ZhangXin555/kosmo-riscv/docs/Kosmo2_RISC-V五级流水CPU详解.docx

本文档怎么用

第 1 章：工程在哪、怎么跑起来。

第 2–10 章：一个模块一章，先贴该模块的全部代码，再按代码书写顺序一步一步讲，配 Vivado 真实截图。

第 11 章：把整机串起来，讲数据怎么在模块之间流动，五级流水怎么形成。

第 12 章：总结、改指令的方法、踩过的坑、附录。

代码块里的行号（如 cpu_add.sv:27）是源文件真实行号，可以直接跳过去对照。

# 目录

按 F9 更新

# 第 1 章 这本书怎么读，工程在哪，怎么跑起来

这一章不讲电路，只讲三件事：工程文件在哪、软件怎么打开、三种跑法怎么点。看完你应该能自己把仿真跑出来、把综合跑出来。

## 1.1 工程在哪

东西 | 路径
RTL 源码（27 个文件） | D:\ZI GUANG\aaaaidearjiyeda\rs0\kosmo_port\rtl\
PDS 工程（紫光，上板用） | D:\ZI GUANG\aaaaidearjiyeda\rs0\kosmo_port\kosmo_riscv\kosmo_riscv.pds
PDS 工具 | D:\ZI GUANG\PDS2025.2\PDS_2025.2-ads\bin\pds_shell.exe
Vivado 工程（看电路图用） | D:\kosmo_vivado\kosmo_rtl\kosmo_rtl.xpr
Vivado 工具 | D:\vivado\2025.2\Vivado\bin\
GitHub 仓库（源码 + 本书 + 约束 + 仿真） | https://github.com/ZhangXin555/kosmo-riscv

ZI 和 GUANG 之间是 10 个空格，整个目录名长度 17 个字符。复制路径时最容易在这里少打空格，一少就"找不到文件"。

用 VSCode 打开 rtl 目录即可（装了 Verilog-HDL 扩展就有语法高亮和跳转）。想看电路图用 Vivado，想上板用 PDS。

## 1.2 先认识五个词

词 | 意思 | 在本工程里
指令 | CPU 执行的一条命令，32 位 | add x5,x6,x7 编成 00 7 3 0 6 5 33
PC | 程序计数器，装"下一条指令的地址" | 复位后是 0x8000_0000
流水线 | 把一条指令拆成几段，几段同时干活 | 本工程 5 段：取指 / 译码 / 执行 / 访存 / 写回
拍 | 一个时钟周期，流水线的计时单位 | 小回归程序跑了 1605 拍
位流 | 综合布线后生成的、能烧进 FPGA 的文件 | 本工程三版都是 3,333,784 字节

## 1.3 五级流水一句话

一条指令进门后要走五个工位，每个工位一拍，走完五拍出结果。第一个工位在取指令的时候，第二个工位正在译码上一条，第三个工位正在算再上一条……所以稳定运行时，每个工位都在干活，平均下来一条指令只花一拍。这就叫五级流水。

本工程五个工位对应五个模块：

级 | 名字 | 干什么 | 源文件
IF | 取指 | 按 PC 从 IROM 取 32 位指令 | cpu_IFU.sv
ID | 译码 | 拆字段、拼立即数、读寄存器、算分支目标 | cpu_IDU.sv、cpu_Control.sv
EX | 执行 | ALU 算结果、判分支、算地址 | cpu_EXU.sv、cpu_ALU.sv、cpu_add.sv
MEM | 访存 | load/store 真正访问存储器 | cpu_LSU.sv
WB | 写回 | 把结果写进寄存器堆 | cpu_WBU.sv、cpu_RegisterFile.sv

工位与工位之间有两道"墙"，墙里是一排触发器，负责把上一级的结果锁住交给下一级：cpu_IFID_EX_Reg.sv 和 cpu_EX_LSWB_Reg.sv。

## 1.4 整机的样子

Vivado 里对综合后的设计按 F4 打开 Schematic，看到的就是整机：四个方块、十一根对外引脚、197 根内部连线。

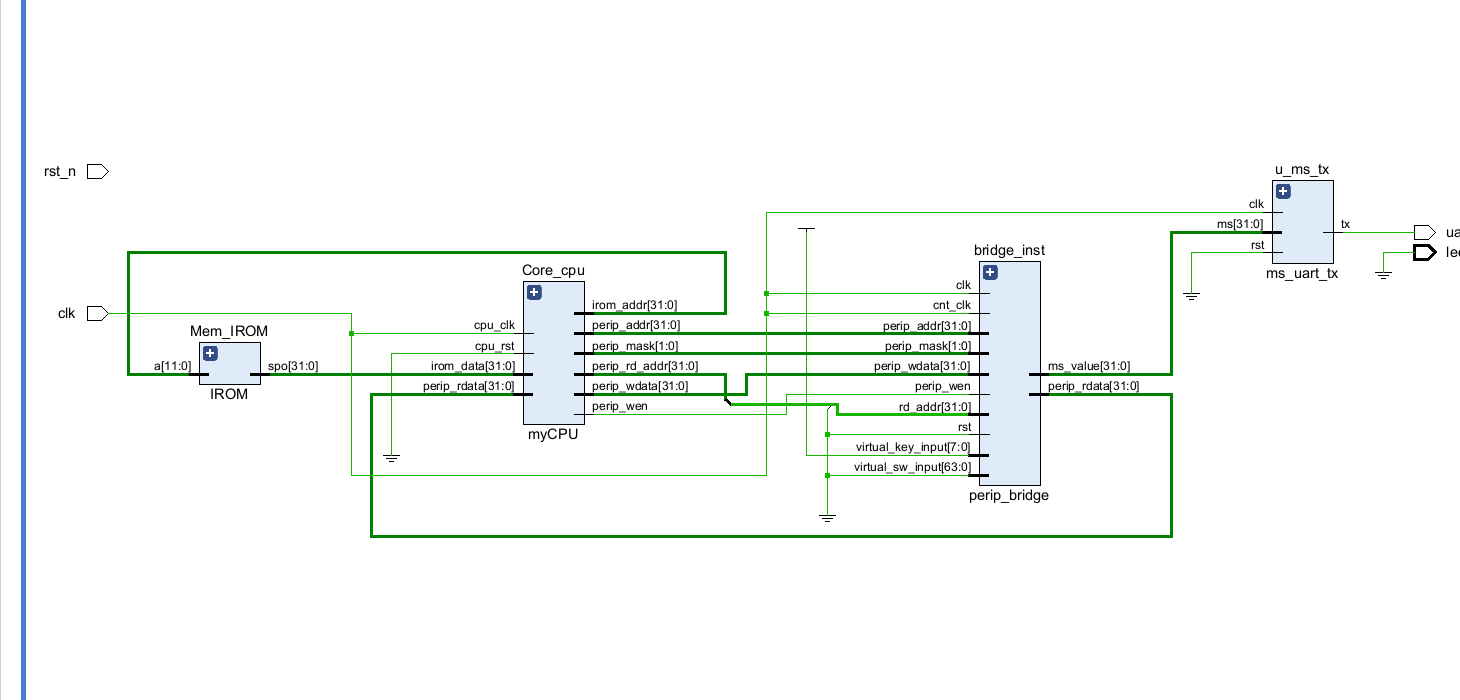
[picture p1: figure]

图 1-1　顶层 top：Mem_IROM 供指令，Core_cpu 是 CPU 本体，bridge_inst 接外设，u_ms_tx 发串口

图里每个方块的左边是输入、右边是输出。Core_cpu 的 irom_addr[11:0] 出去、irom_data[31:0] 回来——这就是取指那条路；perip_addr / perip_wdata / perip_wen 出去、perip_rdata 回来——这就是访问外设那条路。

## 1.5 层次结构

Vivado 左边 Netlist 窗口能看到层次：Core_cpu 下面挂着 10 个模块，其中 EX_LSWB_Reg_inst0 再往下展开是 146 个 RTL_REG_SYNC（就是触发器）。

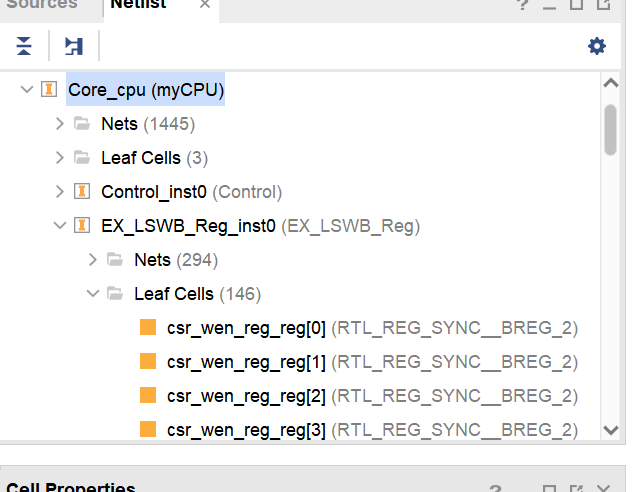
[picture p2: figure]

图 1-2　Netlist 树：Core_cpu → EX_LSWB_Reg_inst0 → 146 个触发器单元

本书第 2 章到第 10 章每章讲一个模块：先贴这个模块的全部代码，再按代码的书写顺序一步步讲，最后收尾。第 11 章把整机串起来讲数据怎么流，第 12 章总结。

## 1.6 三种跑法

跑法一：行为仿真（不烧板，最快）

用 Vivado 或 ModelSim 建工程，把 rtl 全部文件加进去，写一个 testbench 给时钟、给复位，看 pc 和 RegisterFile 里的值。本工程的小回归程序跑 1605 拍，最后寄存器结果是 0x4e84（20100）。

跑法二：综合看电路（不烧板，看面积和连线）

Vivado 里 Run Synthesis，看 Report Utilization：3119 个 LUT、1687 个触发器、64 个 BRAM36。再按 F4 看 Schematic，就是图 1-1。

跑法三：综合布线上板（出位流）

PDS 里打开 kosmo_riscv.pds，先综合再布局布线，最后生成 .sbit。三版位流都是 3,333,784 字节，Fmax 分别是 75.34 / 110.10 / 130.84 MHz。

## 1.7 本书的约定

- 代码块里的行号（如 cpu_add.sv:27）指源文件的真实行号，可直接跳过去看。
- 图都是 Vivado 里的真实截图，不是画出来的示意图。图里方块名、连线名跟代码里的信号名一一对应。
- 每个模块章节最后一节是"三问收尾"：它干什么、怎么做到的、为什么这样写。

## 自测

1. 复位后第一条指令的地址是多少？为什么是这个值？

2. 五级流水稳定运行时，平均一条指令几拍？为什么不是 5 拍？

3. 图 1-1 里 Core_cpu 和 bridge_inst 之间那几根线叫什么名字？它们负责什么？

# 第 2 章 add：一个既能加又能减的加法器

从最底下讲起。整台 CPU 里真正"算数"的东西只有一个 32 位加法器，cpu_add.sv。把它的 31 行代码看懂，后面 ALU 的 11 种运算就有一半能看懂。

## 一、全部代码

`timescale 1ns/1ps

//=============================================================================

// 模块名 ：add（可切换加/减的加法器）

// 位置 ：被 cpu_ALU.sv 调用的组合运算单元（EX 级内部）

// 干什么 ：choose_add_sub=0 时做 add_1 + add_2（加法）；

// choose_add_sub=1 时做 add_1 + (~add_2 + 1) = add_1 - add_2（减法）。

// "加 1"来自 add_2_inv，它是 add_2 的按位取反（在 ALU 里生成），

// 所以这里不再自己取反，省一级逻辑。

// 关键点 ：减法用"补码 = 取反加一"实现；BW 是位宽参数（ALU 里例化成 32）。

//=============================================================================

module add

#(

parameter BW=4 // 位宽参数，默认 4（ALU 里用 32）

)

(

input choose_add_sub, // 0=加法，1=减法

input [BW-1:0]add_1, // 被加数（操作数 A）

input [BW-1:0]add_2, // 加数（操作数 B）

input [BW-1:0]add_2_inv, // ~add_2，减法时用来做补码

output [BW-1:0]result // 运算结果

);

logic [BW-1:0]add_3; // 真正参与相加的第二项

// 选第二操作数：加法直接用 B；减法用 ~B（1 的补数）

assign add_3 = (choose_add_sub == 1'b0)? add_2:(add_2_inv + 1'b1); // 减法时 +1 补齐成 2 的补码

// 核心：A + B 或 A + (~B+1)

assign result = add_1 + add_3;

endmodule

## 二、按代码顺序讲

### 第 1 步 起名字

module add #(

parameter BW=4

)(

input choose_add_sub,

input [BW-1:0] add_1,

input [BW-1:0] add_2,

input [BW-1:0] add_2_inv,

output [BW-1:0] result

);

module add 是这个模块的名字，别处例化它时写 add #(.BW(32)) add_inst0 (...)。

parameter BW=4 是位宽参数，默认 4 位。为什么默认 4 位？因为作者想让它既能做 4 位小加法（测试用），也能在 ALU 里做 32 位加法（BW=32）。不写参数时是 4 位，例化时改一下就是 32 位，代码一行不用重写。

### 第 2 步 四个输入、一个输出

端口 | 位宽 | 它是什么
choose_add_sub | 1 | 0 = 做加法，1 = 做减法
add_1 | BW | 被加数（第一个操作数）
add_2 | BW | 加数（第二个操作数）
add_2_inv | BW | add_2 按位取反，减法时用它做补码
result | BW | 算出来的和或差

四个输入里，add_2 和 add_2_inv 是同一个数的两种形态。为什么不省掉 add_2_inv、让模块自己取反？因为取反是纯组合逻辑，放在外面（ALU 里）可以只做一次、多个地方共用；放进加法器就变成"每次加法都顺手取反一次"，多一级门延迟。这个设计选择会在第 3 章第 4 步再出现一次。

### 第 3 步 先声明一根内部线占个位

logic [BW-1:0] add_3;

add_3 是"真正参与相加的第二项"。为什么需要这一根线？因为第二项有两个来源：加法时它是 add_2，减法时它是 add_2_inv + 1。先把"选哪个"算出来放进 add_3，最后一步就只剩一句干净的 result = add_1 + add_3。

### 第 4 步 选第二项：加还是减

assign add_3 = (choose_add_sub == 1'b0) ? add_2 : (add_2_inv + 1'b1);

这一行是三目运算符，翻译成人话：

- 如果 choose_add_sub 等于 0（做加法），add_3 就等于 add_2；
- 否则（做减法），add_3 就等于 add_2_inv + 1。

为什么减法是"取反加一"？ 计算机里没有减法器，只有加法器。要算 a - b，就把它变成 a + (-b)。而 -b 在补码里等于 ~b + 1（按位取反再加一）。举例：

b = 0000_0011（十进制 3）

~b = 1111_1100

~b+1 = 1111_1101 ← 这就是 -3 的补码

验证：3 + (-3) = 0000_0011 + 1111_1101 = 1_0000_0000，最高位溢出被丢掉，剩下 0000_0000 = 0。对的。

上面这个 +1 是用一个独立的小加法器做的（图 2-1 左边那个 RTL_ADD，一个输入是 d2_inv、另一个是常数 1）。

### 第 5 步 真正相加

assign result = add_1 + add_3;

这一句才是主加法器。前面所有工作都是为了把"该加什么"准备好，到这里只剩一次加法。

+ 在 always 块外面是纯组合逻辑：输入一变，输出立刻跟着变，不需要时钟。综合工具会把它映射成进位链（carry chain），32 位大约占 32 个 LUT。

### 第 6 步 它在图上长什么样

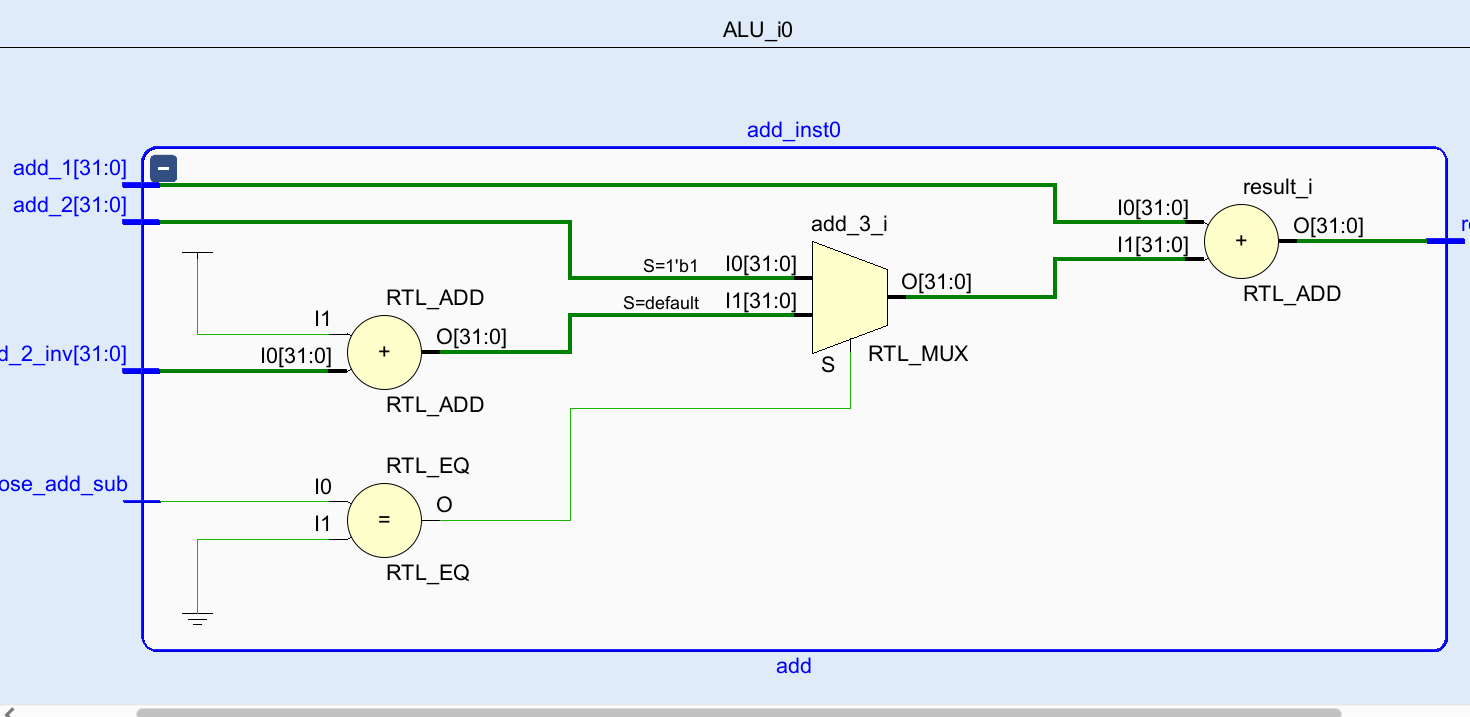
[picture p3: figure]

图 2-1　add_inst0 内部：左边 +1 做补码，中间 MUX 选加还是减，右边 A+B 出结果

图上有四个方块，正好对上代码：

图上的器件 | 对应的代码 | 干什么
左边 RTL_ADD（I0=d_2_inv，I1=1） | :27 的 add_2_inv + 1'b1 | 取反再加一，做出补码
中间 RTL_MUX（S=choose_add_sub） | :27 的三目运算符 ? : | 决定第二项用 add_2 还是补码
右边 RTL_ADD（I0=add_1，I1=add_3） | :30 的 add_1 + add_3 | 真正的加法
下方 RTL_EQ（I0=choose_add_sub，I1=0） | :27 的 choose_add_sub == 1'b0 | 比较器，输出接 MUX 的选择端

这张图最值钱的地方：它证明了"减法不另开加法器"这句话在电路上是什么样——图里只有两个 +，其中一个还是 +1（1 位就够，综合器会把它并进主加法器的进位输入）。

### 第 7 步 改一行，图会怎么变

改动 | 电路上的后果
把 :27 的 add_2_inv + 1'b1 改成 add_2_inv | 左边那个 RTL_ADD 消失，减法结果整体差 1（a-b 变成 a-~b）
把 :27 的三目改成两路 always 分支 | 综合出等价电路，但可能多一级 MUX 延迟
把 BW 改成 64 | 两个加法器都变 64 位，进位链变长，Fmax 下降

## 三、本章小结

问题 | 答案
它干什么 | 算 add_1 + add_3，add_3 是 add_2 或它的补码
怎么做到 | 一个 +1 小加法器做补码 → 一个 MUX 选第二项 → 一个主加法器出结果
为什么这样写 | 减法复用加法器，省一个 32 位加法器的面积
为什么留 add_2_inv 端口 | 取反是纯组合逻辑，放外面只做一次，省延迟
图上怎么认 | 两个 RTL_ADD + 一个 RTL_MUX + 一个 RTL_EQ

## 自测

1. choose_add_sub=0、add_1=5、add_2=3，add_3 和 result 各是多少？

2. choose_add_sub=1、add_1=5、add_2=3，用二进制写出 add_2_inv、add_3、result。

3. 为什么减法的 +1 也要用加法器做，而不是直接写 add_1 - add_2？

# 第 3 章 ALU：11 种运算，一个加法器搞定

这一章只讲一个模块：cpu_ALU.sv 里的 ALU。写法是固定的四段：

1. 先给出全部代码（一字不改，带真实行号）；

2. 按代码书写顺序一步一步讲，每一步先写"这一步在做什么"，再展开细节；

3. 每一步都配一张工程截图，并说清图里哪个器件对应哪一行；

4. 最后收尾三问：这个模块实现了什么功能、为什么这样写就正确、换个写法为什么会错。

读的时候可以对着代码看：左边代码、右边解释、中间看图。

## 一、全部代码

### 1.1 模块本体（cpu_ALU.sv 第 37–112 行）

37: module ALU #(

38: parameter BW = 32 // 数据位宽（本 CPU 用 32）

39: )(

40: input [BW-1:0] d1, // 操作数 A

41: input [BW-1:0] d2, // 操作数 B

42: input [3:0] choice, // 操作码

43: output logic [BW-1:0] result // 运算结果

44: );

45: //-------------------------------------------------------------------------

46: // ① 并行预计算：所有结果同时算，最后选（组合逻辑，无时钟）

47: //-------------------------------------------------------------------------

48: logic [BW-1:0] d2_inv; // d2 的按位取反（减法用）

49: logic [BW-1:0] and_result; // d1 & d2

50: logic [BW-1:0] or_result; // d1 | d2

51: logic [BW-1:0] xor_result; // d1 ^ d2

52: logic [BW-1:0] sll_result; // d1 << d2[4:0]

53: logic [BW-1:0] srl_result; // d1 >> d2[4:0]（高位补 0）

54: logic [BW-1:0] sra_result; // d1 >>> d2[4:0]（高位补符号位）

55: logic [BW-1:0] add_result; // 加法器输出（减法也走它）

56: logic [BW-1:0] sub_result; // 减法结果（= 加法器输出）

57:

58: logic signed_lt; // 有符号小于（1 位）

59: logic unsigned_lt; // 无符号小于（1 位）

60: logic equal; // 不相等（1 位）

61:

62: assign d2_inv = ~d2; // 先取反，减法要用

63:

64: assign and_result = d1 & d2; // 与

65: assign or_result = d1 | d2; // 或

66: assign xor_result = d1 ^ d2; // 异或

67: assign sll_result = d1 << d2[4:0]; // 左移

68: assign srl_result = d1 >> d2[4:0]; // 逻辑右移

69: assign sra_result = $signed(d1) >>> d2[4:0]; // 算术右移

70:

71: // 比较器：$signed 让综合器走有符号比较；结果只有 1 位

72: assign signed_lt = $signed(d1) < $signed(d2); // 有符号小于

73: assign unsigned_lt = d1 < d2; // 无符号小于

74: assign equal = (d1 != d2); // 不相等（注意定义）

75:

76: //-------------------------------------------------------------------------

77: // ② 加减共用一个加法器

78: // choose_add_sub = 0 → d1 + d2

79: // choose_add_sub = 1 → d1 + (~d2 + 1) = d1 - d2（补码）

80: //-------------------------------------------------------------------------

81: add #(

82: .BW(BW)

83: ) add_inst0 (

84: .choose_add_sub(choice == `alu_sub), // 1=减法，0=加法

85: .add_1(d1), // 被加数

86: .add_2(d2), // 加数

87: .add_2_inv(d2_inv), // d2 的取反值（减法时用）

88: .result(add_result) // 和

89: );

90: assign sub_result = add_result; // 减法也走同一个加法器

91:

92: //-------------------------------------------------------------------------

93: // ③ 一层 case 选最终结果（这个 always 是纯组合，always@(*) 不会生成寄存器）

94: //-------------------------------------------------------------------------

95: always @(*) begin

96: case(choice)

97: `alu_signed_comparator : result = {{(BW-1){1'b0}}, signed_lt}; // < 有符号

98: `alu_unsigned_comparator : result = {{(BW-1){1'b0}}, unsigned_lt}; // < 无符号

99: `alu_add : result = add_result; // 加

100: `alu_sub : result = sub_result; // 减

101: `alu_and : result = and_result; // 与

102: `alu_or : result = or_result; // 或

103: `alu_xor : result = xor_result; // 异或

104: `alu_equal : result = {{(BW-1){1'b0}}, equal}; // 不相等

105: `alu_sll : result = sll_result; // <<

106: `alu_srl : result = srl_result; // >>

107: `alu_sra : result = sra_result; // >>>

108: default : result = {BW{1'b0}}; // 未定义 → 0

109: endcase

110: end

111:

112: endmodule

### 1.2 操作码定义（第 23–33 行）

23: `define alu_add 4'b0000 // 加

24: `define alu_sub 4'b0001 // 减

25: `define alu_or 4'b0010 // 或

26: `define alu_and 4'b0011 // 与

27: `define alu_xor 4'b0100 // 异或

28: `define alu_signed_comparator 4'b0101 // 有符号比较（小于）

29: `define alu_unsigned_comparator 4'b0110 // 无符号比较（小于）

30: `define alu_equal 4'b0111 // 相等判断（实际存"不相等"）

31: `define alu_sll 4'b1000 // 逻辑左移

32: `define alu_srl 4'b1001 // 逻辑右移

33: `define alu_sra 4'b1010 // 算术右移

这 11 个 define 是"操作码的名字"。代码里写 ` alu_add ` 就等于写 4'b0000`，只是让人读得懂。

### 1.3 它在整个 CPU 里的位置

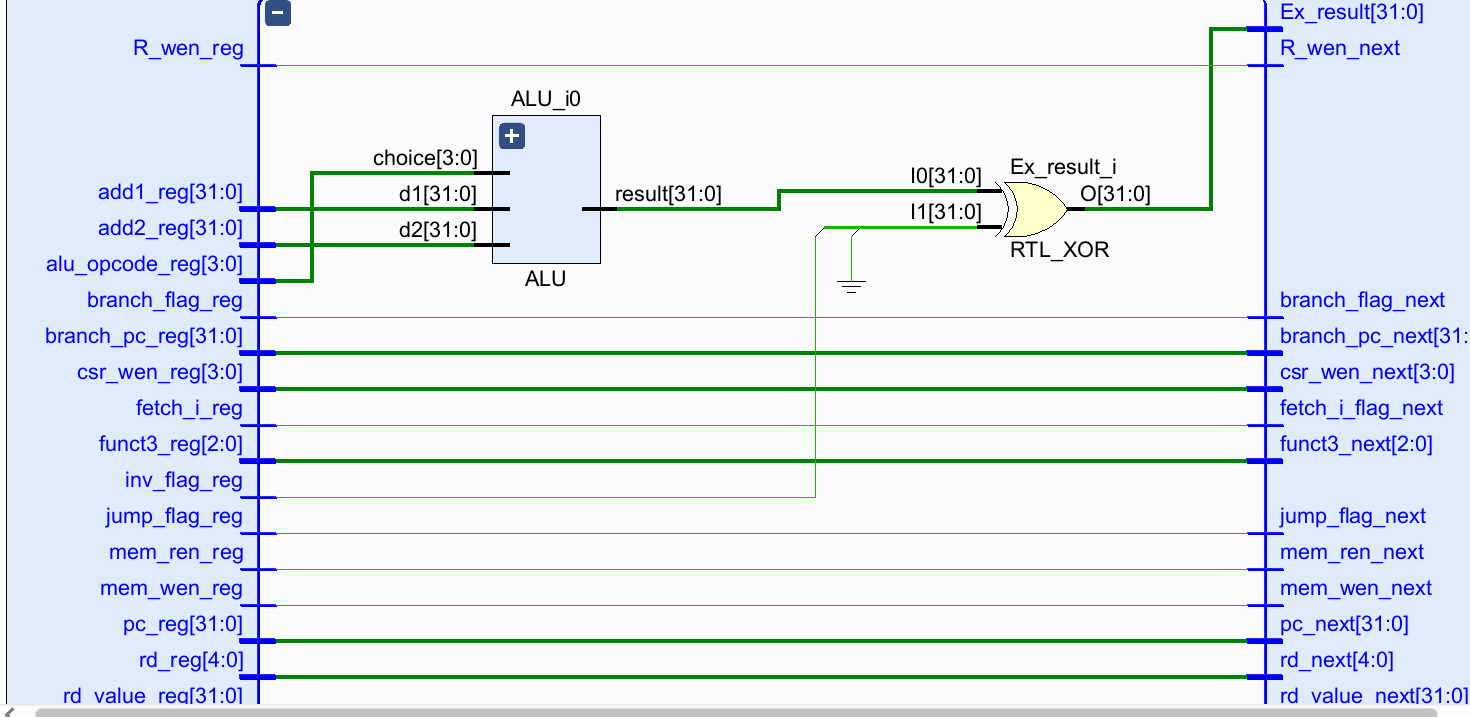
[picture p4: figure]

图 3-3　EXU_inst0 内部：ALU_i0 是 EXU 里唯一干活的方块，右边一个 RTL_XOR 翻 bit0

ALU 不是顶层模块，它被 EXU（cpu_EXU.sv:115-122）例化成一个叫 ALU_i0 的方块。图上那个方块就是本章要拆的东西：

- 左边进去三根总线：d1、d2、choice；
- 右边出来一根：result；
- 再右边那个 RTL_XOR 是 EXU 自己加的，不属于 ALU。

## 二、按代码顺序讲

顺序就是代码的书写顺序，一步不跳：

起名字 → 定端口 → 声明内部线 → 取反 → 六种运算 → 三种比较 → 加法器 → case 选一个 → 收尾

第1步 第2步 第3步 第4步 第5步 第6步 第7步 第8步 第9步

### 第 1 步 module ALU #( parameter BW = 32 ) (

37: module ALU #(

38: parameter BW = 32 // 数据位宽（本 CPU 用 32）

39: )(

这一步在做什么：给电路起名字，并把"位宽"定成一个能改的数。

- module ALU：这块电路的名字叫 ALU。别处写 ALU #(.BW(32)) ALU_i0 (...)，就是把这一整块复制一份放进 EXU 里。
- #( parameter BW = 32 )：参数。这个模块里所有写 `BW` 的地方都等于 32，所有 [BW-1:0] 展开就是 [31:0]，也就是 32 根线并排。
- 为什么用参数而不是直接写 32：add 模块里 BW 默认是 4，ALU 例化它时传了 32，所以同一份 add 代码既能做 4 位加法器，也能做 32 位加法器。

### 第 2 步 4 个端口：3 进 1 出

40: input [BW-1:0] d1, // 操作数 A

41: input [BW-1:0] d2, // 操作数 B

42: input [3:0] choice, // 操作码

43: output logic [BW-1:0] result // 运算结果

44: );

这一步在做什么：画出这个电路与外界的边界——从外面进来什么线，往外面出去什么线。

行 | 端口 | 方向 | 位宽 | 实际是几根线 | 代表什么
40 | d1 | 进 | 32 | d1[31]…d1[0] | 操作数 A（rs1，或立即数运算时的第一个源）
41 | d2 | 进 | 32 | d2[31]…d2[0] | 操作数 B（rs2，或立即数）
42 | choice | 进 | 4 | choice[3]…choice[0] | 操作码，告诉 ALU 做哪种运算
43 | result | 出 | 32 | result[31]…result[0] | 选中的那种运算的结果

为什么只有 `result` 前面多一个 `logic`：因为第 8 步要在 always @(*) 里给 result 赋值（过程赋值），只有 logic / reg 类型才能这么用。d1、d2、choice 只在 assign 右边被读，普通的 input 就够。

到这一步为止，模块里一根线都还没接——只是把 4 个出入口定义好了。

### 第 3 步 先把要用的内部线"占个位"

48: logic [BW-1:0] d2_inv; // d2 的按位取反（减法用）

49: logic [BW-1:0] and_result; // d1 & d2

50: logic [BW-1:0] or_result; // d1 | d2

51: logic [BW-1:0] xor_result; // d1 ^ d2

52: logic [BW-1:0] sll_result; // d1 << d2[4:0]

53: logic [BW-1:0] srl_result; // d1 >> d2[4:0]

54: logic [BW-1:0] sra_result; // d1 >>> d2[4:0]

55: logic [BW-1:0] add_result; // 加法器输出

56: logic [BW-1:0] sub_result; // 减法结果

58: logic signed_lt; // 有符号小于（1 位）

59: logic unsigned_lt; // 无符号小于（1 位）

60: logic equal; // 不相等（1 位）

这一步在做什么：声明 12 根内部线。它们现在什么都没接，只有名字和宽度。

行 | 线名 | 位宽 | 后面会装什么 | 谁用它
48 | d2_inv | 32 | ~d2 | 第 7 步的加法器
49 | and_result | 32 | d1 & d2 | 第 8 步 case 的 0011
50 | or_result | 32 | d1 | d2 | 第 8 步 case 的 0010
51 | xor_result | 32 | d1 ^ d2 | 第 8 步 case 的 0100
52 | sll_result | 32 | d1 << d2[4:0] | 第 8 步 case 的 1000
53 | srl_result | 32 | d1 >> d2[4:0] | 第 8 步 case 的 1001
54 | sra_result | 32 | d1 >>> d2[4:0] | 第 8 步 case 的 1010
55 | add_result | 32 | 加法器输出 | 第 8 步 case 的 0000
56 | sub_result | 32 | 就是 add_result | 第 8 步 case 的 0001
58 | signed_lt | 1 | 有符号比较结果 | 第 8 步 case 的 0101
59 | unsigned_lt | 1 | 无符号比较结果 | 第 8 步 case 的 0110
60 | equal | 1 | "不相等"的结果 | 第 8 步 case 的 0111

为什么 9 根 32 位、3 根 1 位：运算结果都要和 result 一样宽（32 位）；比较只有"是/否"两种，1 位就够，到第 8 步再用 31 个 0 补成 32 位。

### 第 4 步 d2_inv = ~d2（第 62 行）

62: assign d2_inv = ~d2;

这一步在做什么：把 `d2` 每一位取反，接到 `d2_inv` 那 32 根线上。

- assign 是永久连线，不是"执行一次"：右边一变，左边立刻跟着变。
- ~ 是按位取反，不是取负：32 根线每根过一个非门，并排 32 个非门。

d2 = 0x00000003 算一遍：

d2 = 0000_0000_0000_0000_0000_0000_0000_0011

~d2 = 1111_1111_1111_1111_1111_1111_1111_1100 = 0xFFFFFFFC

位 | d2 | 过非门 | d2_inv
bit31…bit2 | 全是 0 | ~0 = 1 | 全是 1
bit1 | 1 | ~1 = 0 | 0
bit0 | 1 | ~1 = 0 | 0

这根线后面给谁用：第 7 步送进 add_inst0 的 .add_2_inv(d2_inv)，减法时靠它拼补码。

不写这一行会怎样：第 7 步的 add_2_inv 端口悬空（0），减法会算成 A + 1。

### 第 5 步 6 行 assign，6 种运算同时算（第 64–69 行）

64: assign and_result = d1 & d2; // 与

65: assign or_result = d1 | d2; // 或

66: assign xor_result = d1 ^ d2; // 异或

67: assign sll_result = d1 << d2[4:0]; // 左移

68: assign srl_result = d1 >> d2[4:0]; // 逻辑右移

69: assign sra_result = $signed(d1) >>> d2[4:0]; // 算术右移

这一步在做什么：6 种运算各配一座电路，同时算，各占一根线。

拿 d1 = 5 = 0101、d2 = 3 = 0011 一位一位看：

行 | 运算 | 门电路 | 算式 | 结果
64 | 按位与 & | 32 个与门，同一位都是 1 才出 1 | 0101 & 0011 | 0001 = 1
65 | 按位或 | | 32 个或门，有一位是 1 就出 1 | 0101 | 0011 | 0111 = 7
66 | 按位异或 ^ | 32 个异或门，两位不同才出 1 | 0101 ^ 0011 | 0110 = 6
67 | 左移 << | 移位器，低位补 0 | 0101 << 3 | 0010_1000 = 40
68 | 逻辑右移 >> | 移位器，高位补 0 | 0101 >> 3 | 0000 = 0
69 | 算术右移 >>> | 移位器，高位补符号位 | 0101 >>> 3 | 0000 = 0

移位量为什么写 `d2[4:0]`：RISC-V 规定移位量只有 5 位（0~31），32 位数据最多移 31 位。写 d2[4:0] 就是只取低 5 根线，其余 27 根不参与。

算术右移和逻辑右移的差别，用负数才看得出来：d1 = 0xFFFFFFF2（-14），d2 = 2

>>> 2 : 1111_1111_1111_1111_1111_1111_1111_1100 = 0xFFFFFFFC = -4 高位补 1

>> 2 : 0011_1111_1111_1111_1111_1111_1111_1100 = 0x3FFFFFFC = 1073741820 高位补 0

同一条数据，`>>>` 补 1、`>>` 补 0——这就是 `sra` 和 `srl` 的全部区别。 $signed(d1) 是告诉编译器"把 d1 当有符号数看"，否则 >>> 会退化成 >>。

这 6 根线后面给谁用：都在第 8 步的 case 里被选中。

### 第 6 步 3 行比较，各出 1 位（第 72–74 行）

72: assign signed_lt = $signed(d1) < $signed(d2); // 有符号小于

73: assign unsigned_lt = d1 < d2; // 无符号小于

74: assign equal = (d1 != d2); // 不相等（注意定义）

这一步在做什么：3 个比较器，每个只输出 1 位（真 = 1，假 = 0）。

有符号和无符号的差别，用负数最明显：d1 = 0xFFFFFFF2（有符号是 -14，无符号是 4294967282），d2 = 2

行 | 怎么比 | 结果 | 为什么
72 | -14 < 2（有符号） | 1 | 负数小于正数
73 | 4294967282 < 2（无符号） | 0 | 42 亿当然不小于 2

同一对数据，两个比较器给出相反结果——这就是 RISC-V 为什么要分 blt（有符号）和 bltu（无符号）。

`equal` 为什么写 `!=`：它算的是"不相等"，5 != 3 得 1。名字叫 equal、值却是"不相等"，这是故意的——EXU 那边（cpu_EXU.sv:108）会把它翻转一次变成"相等"。这里改成 `==`，EXU 再翻一次，等于没翻，所有分支指令全反。

!= 的门电路：32 个异或门（相同位输出 0）+ 一个 32 输入或门（有任何一位不同就输出 1）。

### 第 7 步 把三根线送进加法器（第 81–90 行）

81: add #(

82: .BW(BW)

83: ) add_inst0 (

84: .choose_add_sub(choice == `alu_sub), // 1=减法，0=加法

85: .add_1(d1), // 被加数

86: .add_2(d2), // 加数

87: .add_2_inv(d2_inv), // d2 的取反值（减法时用）

88: .result(add_result) // 和

89: );

90: assign sub_result = add_result; // 减法也走同一个加法器

这一步在做什么：把第 4 步取反好的 `d2_inv` 和第 2 步的 `d1`、`d2` 送进 `add` 模块，一次算出加减。

行 | 语句 | 干什么
81–83 | add #(.BW(BW)) add_inst0 ( | 把 add 模块复制一份，起名 add_inst0，位宽传 32
84 | .choose_add_sub(choice == \alu_sub)` | 算一个 1 位的值：choice 等于 0001 时传 1（做减法），否则传 0（做加法）
85 | .add_1(d1) | A = d1
86 | .add_2(d2) | B = d2
87 | .add_2_inv(d2_inv) | 把取反好的线接进来
88 | .result(add_result) | 加法器输出接到 add_result 这 32 根线
90 | assign sub_result = add_result; | 减法结果就是加法器输出，不再另建电路

图 3-1　add_inst0 内部：左边 +1、中间 MUX、右边 A+B，正对上图第 84–88 行

add 模块内部只有两行（cpu_add.sv:27 和 :30）：

27: assign add_3 = (choose_add_sub == 1'b0)? add_2:(add_2_inv + 1'b1);

30: assign result = add_1 + add_3;

所以：

- choice = 0000（加）→ choose_add_sub = 0 → add_3 = d2 → add_result = d1 + d2
- choice = 0001（减）→ choose_add_sub = 1 → add_3 = ~d2 + 1 → add_result = d1 + ~d2 + 1 = d1 - d2

拿 5 和 3 算：

加：0101 + 0011 = 1000 = 8 ✓

减：0101 + (1100 + 1 = 1101) = 1_0010 → 丢掉最高进位 = 0010 = 2 ✓

为什么"取反加一"等于减法：~B + 1 = 2³² − B，所以 A + (~B + 1) = 2³² + (A − B)，32 位加法器只保留低 32 位，那个 2³² 正好溢出丢掉，剩下 A − B。

### 第 8 步 case：如果 choice 等于几，就把哪根线接到输出（第 95–110 行）

95: always @(*) begin

96: case(choice)

97: `alu_signed_comparator : result = {{(BW-1){1'b0}}, signed_lt};

98: `alu_unsigned_comparator : result = {{(BW-1){1'b0}}, unsigned_lt};

99: `alu_add : result = add_result;

100: `alu_sub : result = sub_result;

101: `alu_and : result = and_result;

102: `alu_or : result = or_result;

103: `alu_xor : result = xor_result;

104: `alu_equal : result = {{(BW-1){1'b0}}, equal};

105: `alu_sll : result = sll_result;

106: `alu_srl : result = srl_result;

107: `alu_sra : result = sra_result;

108: default : result = {BW{1'b0}};

109: endcase

110: end

这一步在做什么：12 路里挑 1 路接到 `result`——就是一个 12 选 1 的 MUX。

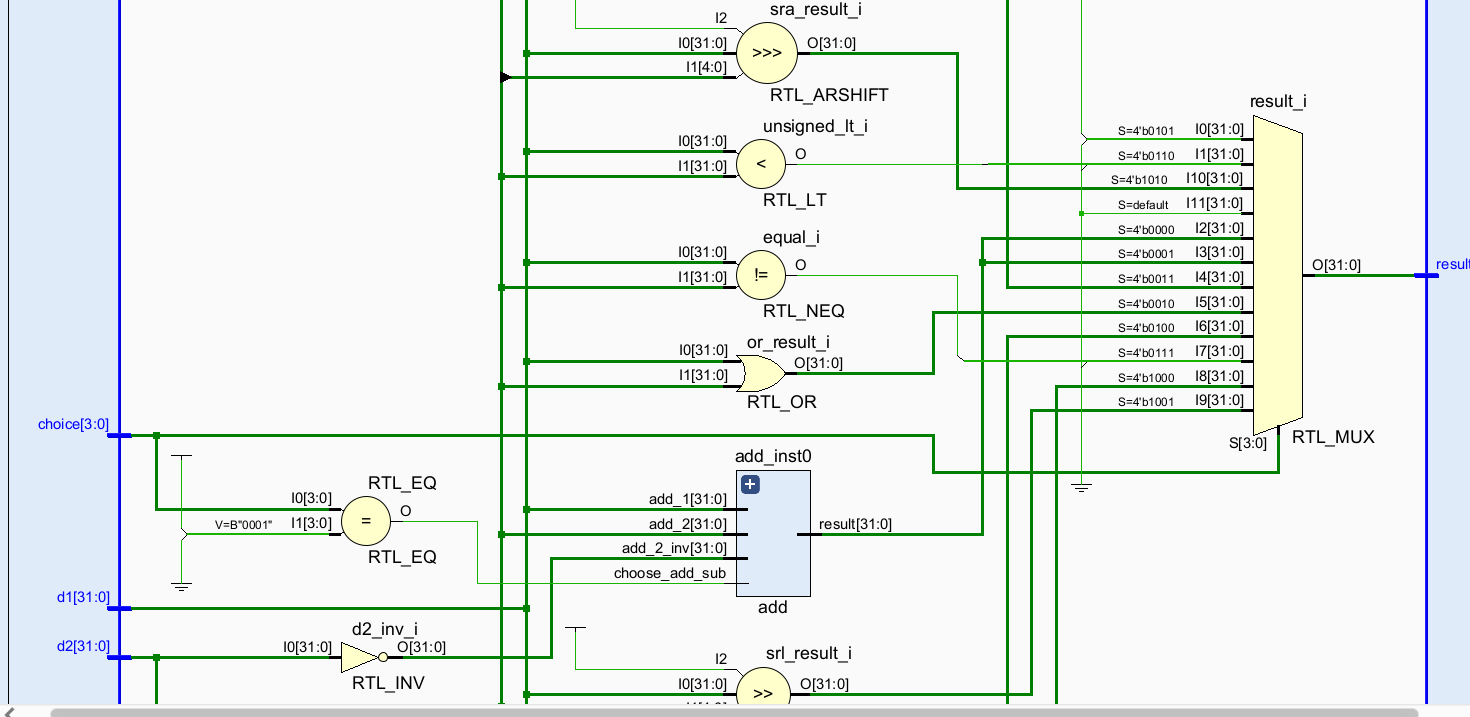
[picture p5: figure]

图 3-2　ALU_i0 内部：左边一排运算单元并行，右边 RTL_MUX（S = choice[3:0]）按 case 选

看图对照代码：图左边那一排 `RTL_AND` / `RTL_OR` / `RTL_XOR` / `RTL_LSHIFT` / `RTL_RSHIFT` / `RTL_ARSHIFT` / `RTL_LT`×2 / `RTL_EQ` / `RTL_INV` / `add_inst0`，就是第 4～7 步那 10 行 `assign` + 1 个例化；图右边那个 `RTL_MUX`，就是第 8 步这个 `case`。

每一行翻译成人话就是"如果 `choice` 等于这个值，就把等号右边那根线接到 `result` 上"：

常量 | 值 | 这一行 | 人话
alu_add | 0000 | result = add_result; | 要加，就把加法器输出接出去
alu_sub | 0001 | result = sub_result; | 要减，接减法输出（同一根线）
alu_or | 0010 | result = or_result; | 接或
alu_and | 0011 | result = and_result; | 接与
alu_xor | 0100 | result = xor_result; | 接异或
alu_signed_comparator | 0101 | result = {31'd0, signed_lt}; | 接有符号比较，补 31 个 0
alu_unsigned_comparator | 0110 | result = {31'd0, unsigned_lt}; | 接无符号比较
alu_equal | 0111 | result = {31'd0, equal}; | 接"不相等"
alu_sll | 1000 | result = sll_result; | 接左移
alu_srl | 1001 | result = srl_result; | 接逻辑右移
alu_sra | 1010 | result = sra_result; | 接算术右移
其他 | 1011~1111 | result = 32'd0; | 默认全 0

`{{(BW-1){1'b0}}, signed_lt}` 是什么意思：把 1 位的 signed_lt 放在最低位，前面补 31 个 0，凑成 32 位。{(BW-1){1'b0}} 就是"31 个 0"的写法。

`always @(*)` 为什么不能写 `posedge clk`：这是组合逻辑，choice 一变就该立刻出结果。加了时钟就变成"下一拍才出"，整个 CPU 多一拍延迟。

`default` 为什么必须有：choice 是 4 位，有 16 种可能，代码只写了 11 种。不写 default，剩下 5 种情况下 result 没赋值，综合器会推断"要记住上次的值"，生成锁存器（latch）——电路不对，仿真和时序都对不上。

### 第 9 步 收尾：这 8 步合起来实现了什么

合起来干的事：

1. 拿到 32 位的 A、32 位的 B、4 位的操作码；

2. 用 32 个非门做出 ~B；

3. 同时算出与、或、异或、三种移位、两种比较、一种"不相等"，9 个结果各挂一根线；

4. 把 A、B、~B 送进一个加法器，加法和减法靠"选 B 还是 ~B+1"共用一座电路；

5. 最后用 12 选 1 的 MUX，按操作码把对应那根线接到输出。

功能一句话：给一个操作码，就输出对应的那一种运算结果。 RISC-V 的 R 型指令（add/sub/and/or/xor/sll/srl/sra）和 I 型指令（addi/andi/ori/xori/slli/srli/srai）在 EX 级做的是同一件事，只是操作码不同，走的是同一个 ALU。

为什么这样就对：

- 加/减：全加器按真值表串联，取反加一等于取负（~B+1 = 2³²−B，溢出位丢掉）。
- 与/或/异或：RISC-V 定义就是按位运算，& / | / ^ 正好一位对一位。
- 移位：shamt 只有 5 位，正好对应 d2[4:0]。
- 比较：< 综合成减法看符号/进位；!= 是 32 个异或再或起来。
- MUX：choice 4 根线能区分 16 种，用 11 种够用。

换个写法为什么会错：

换个写法 | 会怎样 | 为什么
删掉 :108 的 default | 综合出锁存器 | 16 种取值只写了 11 种，剩下 5 种没赋值，综合器只能"记住上次"
:74 改成 equal = (d1 == d2) | 分支指令全反 | EXU 的 inv_flag 还要再翻一次，两次取反等于没翻
用 if/else if 链代替 case | 功能对，Fmax 下降 | 综合成级联 MUX，信号要穿 11 级选择
加减各做一个加法器 | 功能对，面积翻倍 | 多一个 32 位加法器
移位量写 d2 | 仿真结果一样 | Verilog 自动取低 5 位，但读代码的人会误以为能移 32 位以上

## 三、本章小结

你要记住的 | 内容
这个模块干什么 | 给 4 位操作码，输出 11 种运算里对应的那一种
它怎么做到 | 所有运算并行算，最后一层 MUX 选
加减为什么只有一个加法器 | ~B+1 就是 -B，靠 MUX 选第二操作数
为什么 equal 是"不相等" | EXU 会翻转 bit0，两次取反会抵消
图上怎么认 | 左边一排运算单元 = 第 4～6 步；中间 add_inst0 = 第 7 步；右边 RTL_MUX = 第 8 步

# 第 4 章 EXU：ALU 外面只套了一个异或门

第 3 章把 ALU 讲完了。ALU 是 EXU 里面的一个方块。这一章讲 cpu_EXU.sv：EXU 自己干了什么，为什么它能只用一个异或门就把 ALU 包起来。

## 一、全部代码

`timescale 1ns/1ps

//=============================================================================

// 模块名 ：EXU（Execute Unit，执行单元）

// 流水级 ：第 3 级 —— EX（真正算数的那一级）

// 干什么 ：1) 把 ID 送来的操作数 A/B 丢进 ALU 算（加减/逻辑/移位/比较）

// 2) 把控制信号原样"透传"给 EX→MEM 流水寄存器

// 3) 用 inv_flag 对"比较结果"做一次取反，实现 beq/bge/bgeu

// 关键点 ：

// * EXU 本身没有状态（纯组合逻辑），流水寄存器在 EX_LSWB_Reg 里；

// * `Ex_result = alu_result ^ {31'd0, inv_flag_reg}` 这行是"取反技巧"：

// ALU 只会算"小于"和"不相等"，分支指令需要"大于等于""相等"，

// beq/bge/bgeu 在 ID 级把 inv_flag 置 1，这里只翻转最低位就完成等价判断，

// 省掉一条"再比较一次"的路径，关键路径更短、频率更高；

// * 访存地址、寄存器写回值都从 Ex_result 走：lw/sw 的地址 = rs1+imm，

// alu 结果 = 写回值。

//=============================================================================

/*interface define*/

// __opcode__

`define R_opcode 7'b0110011 // R 型

`define lw 7'b0000011 // load

`define addi 7'b0010011 // 立即数算术

`define jarl 7'b1100111 // jalr

`define S_opcode 7'b0100011 // store

`define B_opcode 7'b1100011 // 条件分支

`define lui 7'b0110111 // lui

`define auipc 7'b0010111 // auipc

`define jal 7'b1101111 // jal

`define M_opcode 7'b1110011 // 系统指令

// ---- ALU 操作码 ----

`define alu_add 4'b0000

`define alu_sub 4'b0001

`define alu_or 4'b0010

`define alu_and 4'b0011

`define alu_xor 4'b0100

`define alu_signed_comparator 4'b0101

`define alu_unsigned_comparator 4'b0110

`define alu_equal 4'b0111

`define alu_sll 4'b1000

`define alu_srl 4'b1001

`define alu_sra 4'b1010

`define Performance_Count

module EXU (

// ---- 来自 IFID_EX_Reg（ID 打过来的）----

input [2:0] funct3_reg, // 功能码

input [3:0] csr_wen_reg, // CSR 写使能

input R_wen_reg, // 写通用寄存器

input mem_wen_reg, // 写内存

input mem_ren_reg, // 读内存

input [4:0] rd_reg, // 目的寄存器

input [31:0] pc_reg, // 本条 PC

input [3:0] alu_opcode_reg, // ALU 操作码

input inv_flag_reg, // 比较结果取反

input jump_flag_reg, // 跳转

input branch_flag_reg, // 分支

input fetch_i_reg, // fence.i

input [31:0] branch_pc_reg, // 分支目标

input [31:0] rs2_value_reg, // rs2 原值（store 数据）

input [31:0] add1_reg, // ALU A

input [31:0] add2_reg, // ALU B

input [31:0] rd_value_reg, // 预计算写回值

// ---- 送给 EX_LSWB_Reg（往下打一拍）----

output [2:0] funct3_next,

output [3:0] csr_wen_next,

output R_wen_next,

output mem_wen_next,

output mem_ren_next,

output [4:0] rd_next,

output [31:0] pc_next,

output jump_flag_next,

output [31:0] rs2_value_next,

output [31:0] rd_value_next,

output [31:0] Ex_result, // ALU 结果（下面两级都要用）

output fetch_i_flag_next,

output branch_flag_next,

output [31:0] branch_pc_next

);

logic [31:0] alu_result; // ALU 原始输出

//-------------------------------------------------------------------------

// 控制信号透传：EX 级不改这些信号，只是原样交给下一级寄存器

//-------------------------------------------------------------------------

assign funct3_next = funct3_reg; // 功能码

assign csr_wen_next = csr_wen_reg; // CSR 写使能

assign R_wen_next = R_wen_reg; // 写寄存器

assign mem_wen_next = mem_wen_reg; // 写内存

assign mem_ren_next = mem_ren_reg; // 读内存

assign rd_next = rd_reg; // 目的寄存器

assign pc_next = pc_reg; // PC

assign jump_flag_next = jump_flag_reg; // 跳转标志

assign rs2_value_next = rs2_value_reg; // store 数据（原样带下去）

assign rd_value_next = rd_value_reg; // 写回值（原样带下去）

assign fetch_i_flag_next = fetch_i_reg; // fence.i

assign branch_flag_next = branch_flag_reg; // 分支标志

assign branch_pc_next = branch_pc_reg; // 分支目标

//-------------------------------------------------------------------------

// ALU 结果 + 取反技巧

// inv_flag_reg = 1 时，只翻转 bit0：

// ALU 算 "不相等"(1) → 翻转成 0 → bne 不成立；beq 成立…

// 注意 ALU 里 equal 的定义是 (d1 != d2)，配合 inv_flag 正好实现两类分支。

//-------------------------------------------------------------------------

assign Ex_result = alu_result ^ {31'd0, inv_flag_reg};

//-------------------------------------------------------------------------

// 例化 ALU（组合逻辑，参数化位宽 BW）

// 输入：d1=A, d2=B, choice=操作码；输出：result

//-------------------------------------------------------------------------

/* verilator lint_off PINMISSING */

ALU #(

.BW(32) // 32 位数据通路

) ALU_i0 (

.d1(add1_reg), // 操作数 A

.d2(add2_reg), // 操作数 B

.choice(alu_opcode_reg), // 操作码

.result(alu_result) // 结果

);

endmodule

## 二、按代码顺序讲

### 第 1 步 它在流水线上的位置

EXU = EXecute Unit，第三级。它的上游是流水寄存器 IFID_EX_Reg（把 ID 级算好的东西锁住），下游是 EX_LSWB_Reg。

图 4-1　EXU_inst0 内部：中间 ALU_i0 是算数单元，右边 RTL_XOR 只翻 bit0，四周全是直通的 _reg → _next

图里最明显的特征：一大排 `_reg` 进、`_next` 出，竖着穿过去。这些是"EXU 不碰、但要往下传"的信号：目的寄存器号、写使能、访存标志、PC……EXU 只负责算，别的原样往下递。

### 第 2 步 端口：两组，一组算、一组过

EXU 的端口可以分成三列看：

类别 | 信号 | 说明
要算的 | add1_reg、add2_reg、alu_opcode_reg | 两个操作数 + 操作码，喂给 ALU
算出来的 | Ex_result | ALU 结果，可能被异或门翻 bit0
直通的 | R_wen_reg、rd_reg、mem_ren_reg、mem_wen_reg、csr_wen_reg、pc_reg、funct3_reg、rs2_value_reg、rd_value_reg、jump_flag_reg、valid_last、ready_last | 一位不改，直接 _next

这就是 EXU 的全部工作：算一个值，其余原样传。

### 第 3 步 15 条直通线

assign rd_next = rd_reg;

assign R_wen_next = R_wen_reg;

assign mem_ren_next = mem_ren_reg;

assign mem_wen_next = mem_wen_reg;

assign csr_wen_next = csr_wen_reg;

assign pc_next = pc_reg;

assign funct3_next = funct3_reg;

assign rs2_value_next = rs2_value_reg;

assign rd_value_next = rd_value_reg;

assign jump_flag_next = jump_flag_reg;

每一句都是"左边 = 右边"，中间什么都没做。这在电路上就是一根线（图 4-1 里那些竖着穿过去的细线）。

为什么要这样写而不是省略？因为流水寄存器 EX_LSWB_Reg 需要这些信号，而它们必须由 EXU 交给它；EXU 是两级之间的"传菜口"。

### 第 4 步 算数：只例化一个 ALU

ALU #(.BW(32)) ALU_i0 (

.d1 (add1_reg),

.d2 (add2_reg),

.choice (alu_opcode_reg),

.result (alu_result)

);

#(.BW(32)) 把 ALU 的位宽参数设成 32；ALU_i0 是例化名，Vivado 图里那个方块的标签就是它。

### 第 5 步 那一个异或门：翻 bit0

assign Ex_result = alu_result ^ {31'd0, inv_flag_reg};

inv_flag_reg 是 1 位，{31'd0, inv_flag_reg} 把它补成 32 位（高 31 位是 0，最低位是它）。异或的性质：

- x ^ 0 = x（不翻）——inv_flag_reg=0
- x ^ 1 = ~x[0]（只翻最低位）——inv_flag_reg=1

所以这一句的意思是：`inv_flag_reg` 为 0 时结果不变，为 1 时把结果的最低位取反。

### 第 6 步 为什么要翻最低位

分支指令的比较结果就放在 bit0 里。cpu_ALU.sv 里 equal = (d1 != d2) 算的是"不相等"：相等时 equal=0，不相等时 equal=1。

而 RISC-V 的 beq 要求"相等就跳"。所以 beq 需要把"不相等"翻成"相等"：inv_flag=1 时把 bit0 翻过来，equal=0 变 1，branch_taken = branch_flag & Ex_result[0] 就成立了。

这就是 IDU 里那行 inv_flag 的由来：

assign inv_flag = (opcode == `B_opcode && (funct3 == 3'b101 || funct3 == 3'b111 || funct3 == 3'b000)) ? 1'b1 : 1'b0;

funct3 为 000（beq）、101（bge）、111（bgeu）时置 1——这三条都是"要取反才等价"的分支：

指令 | ALU 算出来的 bit0 | 翻不翻 | 最终跳不跳
beq | equal（不等=1） | 翻 | 相等才跳
bne | equal | 不翻 | 不等于才跳
blt | signed_lt（小于=1） | 不翻 | 小于就跳
bge | signed_lt | 翻 | 不小于（≥）就跳
bltu | unsigned_lt | 不翻 | 无符号小于就跳
bgeu | unsigned_lt | 翻 | 无符号不小于就跳

一个异或门 + 一个 inv_flag 位，搞定 6 条分支的方向。这是全工程最省的一处设计。

### 第 7 步 谁用它

branch_taken 在 cpu_Control.sv 里：

assign branch_taken = branch_flag & Ex_result[0];

branch_flag 说明"这是一条分支"，Ex_result[0] 说明"比较结果是真"。两个都为真才改 PC。

### 第 8 步 改这行，电路会怎么变

改动 | 后果
把 ^ 改成 + | 变成加法，bit0 进位会串到高位，全错
把 {31'd0, inv_flag_reg} 改成 inv_flag_reg | 位宽不匹配，只有 bit0 参与异或，其余位被截断
删掉异或门，让 ALU 直接输出 == | 要么多一种 ALU 运算（面积 + MUX 深度），要么改分支逻辑，二选一

## 三、本章小结

问题 | 答案
它干什么 | 调 ALU 算结果，把其他信号原样送到下一级
怎么做到 | 15 条 assign 直通 + 1 个 ALU_i0 + 1 个异或门
为什么用一个异或门 | 6 条分支里有 3 条需要"取反"，翻 bit0 最省
图上怎么认 | 中间 ALU_i0，右下 RTL_XOR，其余是竖着穿的线
谁接它的结果 | cpu_Control.sv 的 branch_taken，和 EX_LSWB_Reg

## 自测

1. d1=5、d2=5、choice=4'b0111（equal），inv_flag_reg=1，Ex_result[0] 是多少？分支跳不跳？

2. 为什么 blt 不需要翻，而 bge 需要翻？

3. 图 4-1 里那些竖着穿过去的线，它们在代码里对应哪些 assign？

# 第 5 章 IDU：把 32 位机器码拆成五路信号

IDU = Instruction Decode Unit，第二级。它拿到 32 位指令，输出"这一条指令要干什么"的一整套信号：ALU 干什么、要不要访存、要不要写寄存器、要不要跳、跳去哪。

这一章要讲四个文件：cpu_IDU.sv（主译码器）、cpu_RegisterFile.sv（寄存器堆）、cpu_Control.sv（两级总调度）、cpu_Data_hazard.sv（冒险检测）。

## 一、全部代码

### 1.1 IDU 主体

`timescale 1ns/1ps

//=============================================================================

// 模块名 ：IDU（Instruction Decode Unit，译码单元）

// 流水级 ：第 2 级 —— ID（译码 + 读寄存器 + 算分支目标）

// 干什么 ：拿到 IF 送来的 32 位指令，做四件事：

// 1) 拆字段：opcode[6:0] / rs1[19:15] / rs2[24:20] / funct3[14:12] / rd[11:7]

// 2) 拼立即数：I/U/S/B/J 五种格式，按 opcode 选一个

// 3) 生成控制信号：写回使能 R_wen、访存 mem_wen/mem_ren、分支 branch_flag、

// 跳转 jump_flag、ALU 操作码 alu_opcode、CSR 写使能 csr_wen_next

// 4) 读通用寄存器（例化 Reg_Stack），顺便算出分支目标 pc+imm、跳转返回地址 snpc

// 关键点 ：

// * 本模块全是组合逻辑（assign），只有末尾的 Reg_Stack 里有触发器；

// * ALU 的两个操作数 add1_value/add2_value 在这里就选好，EX 级只管算；

// * `imm` 与 `csr_wen_next` 互相引用（csr_wen_next 用 imm，imm 又由 opcode 选），

// Verilog 的 assign 是并行求值，先后顺序无所谓；

// * 例外：csr_wen_next 判断时 imm 还没“定义完”，但组合逻辑会自动收敛。

//=============================================================================

/*interface define*/

// ---- RISC-V opcode（inst[6:0]）----

`define R_opcode 7'b0110011 // R 型：add/sub/sll/slt/sltu/xor/srl/sra/or/and

`define lw 7'b0000011 // I 型 load：lw

`define addi 7'b0010011 // I 型算术：addi 及各变体

`define jarl 7'b1100111 // I 型 jalr（原文拼写 jarl）

`define S_opcode 7'b0100011 // S 型 store

`define B_opcode 7'b1100011 // B 型 条件分支

`define lui 7'b0110111 // U 型 lui

`define auipc 7'b0010111 // U 型 auipc

`define jal 7'b1101111 // J 型 jal

`define M_opcode 7'b1110011 // 系统指令：ecall/mret/csr 读写

// ---- ALU 操作码（与 cpu_ALU.sv 的 case 一一对应）----

`define alu_add 4'b0000 // 加（也用于地址计算/访存地址）

`define alu_sub 4'b0001 // 减

`define alu_or 4'b0010 // 或

`define alu_and 4'b0011 // 与

`define alu_xor 4'b0100 // 异或

`define alu_signed_comparator 4'b0101 // 有符号小于（slt / blt / bge）

`define alu_unsigned_comparator 4'b0110 // 无符号小于（sltu / bltu / bgeu）

`define alu_equal 4'b0111 // 相等（beq / bne）

`define alu_sll 4'b1000 // 逻辑左移

`define alu_srl 4'b1001 // 逻辑右移

`define alu_sra 4'b1010 // 算术右移

`define Performance_Count // 性能统计开关

//=============================================================================

// 端口分组说明（读代码时先看这一块，再看下面的 assign）

// 【指令入口】inst[31:0] 当前指令；snpc = pc+4；pc 当前地址

// 【寄存器堆】rd_value = 上一条写回的值；rd/R_wen 写回端口；csrd/csr_wen CSR 读口

// 【EXU 前递】EXU_rs1_in / EXU_rs2_in —— 经过冒险单元选择后的真实操作数

// （可能是寄存器值，也可能是 EX/MEM 前递过来的新值）

// 【给 ID→EX 流水寄存器】rd_next/funct3/alu_opcode/add1_value/add2_value/

// branch_pc/mem_wen/mem_ren/inv_flag/branch_flag/jump_flag/

// R_wen_next/csr_wen_next/rd_value_next/pc_out

// 【给控制/异常】ecall_flag/mret_flag/fence_i_flag/exc_cause

// 【给冒险单元】rs1/rs2（源寄存器号）、A0 值 a0_value（调试用）

// 【握手】valid_last/ready_last、valid_next/ready_next（本设计恒通）

//=============================================================================

module IDU(

input clock, // 时钟

input reset, // 复位

input [31:0] inst, // 当前指令

input [31:0] snpc, // pc + 4（jal/jalr 的返回地址）

input [31:0] pc, // 当前指令地址

input [31:0] rd_value, // 写回值（来自 WB 级）

input [31:0] csrd, // CSR 读出的值

input [4:0] rd, // 写回目标寄存器号

input R_wen, // 写回使能（来自后续级）

input [3:0] csr_wen, // CSR 写使能（来自后续级）

input [31:0] EXU_rs1_in, // 实际 rs1 操作数（含前递）

input [31:0] EXU_rs2_in, // 实际 rs2 操作数（含前递）

output [4:0] rd_next, // 本指令的 rd（送下一级）

output [2:0] funct3, // funct3 字段（ALU 细分用）

output mret_flag, // 是 mret 指令

output ecall_flag, // 是 ecall 指令

input [1:0] exc_cause, // 异常原因（来自 Control）

output fence_i_flag, // 是 fence.i 指令（清流水，本设计只做气泡）

output [31:0] branch_pc, // 分支目标地址 = pc + imm

output [31:0] rs1_value, // rs1 寄存器值（Reg_Stack 输出）

output [31:0] rs2_value, // rs2 寄存器值

output [31:0] add1_value, // ALU 操作数 A（已选好）

output [31:0] add2_value, // ALU 操作数 B（已选好）

output [3:0] csr_wen_next, // CSR 写使能（4bit：mepc/mcause/mstatus/mtvec）

output R_wen_next, // 本指令是否写通用寄存器

output [31:0] rd_value_next, // 预先算好的写回值（jal/jalr 的返回地址等）

output mem_wen, // 写存储器（store）

output mem_ren, // 读存储器（load）

output inv_flag, // 分支需要取反（beq/bge/bgeu → 用 bne/blt/bltu 判）

output branch_flag, // 是条件分支

output jump_flag, // 是跳转（jal/jalr）

output [3:0] alu_opcode, // ALU 操作码

output [4:0] rs1, // 源寄存器 1 号

output [4:0] rs2, // 源寄存器 2 号

output [31:0] a0_value, // a0(x10) 的值（调试/打印用）

output [31:0] mepc_out, // mepc 寄存器值（异常返回地址）

output [31:0] mtvec_out, // mtvec 寄存器值（异常入口）

output [31:0] pc_out, // 本级 PC（保存进流水寄存器）

input valid_last, // 上一级有效

output ready_last, // 告诉上一级我准备好了

input ready_next, // 下一级准备好了

output valid_next // 告诉下一级数据有效

);

logic [31:0] csr_addr; // CSR 地址（= imm）

logic [6:0] oprand; // inst[31:25]：R 型用来区分 sra/srl、add/sub

logic [6:0] opcode; // inst[6:0]：主操作码

// 五种立即数格式 + CSR 读值 + 选中后的 imm

logic [31:0] imm_I; // I 型：12 位符号扩展

logic [31:0] imm_U; // U 型：20 位左移 12

logic [31:0] imm_R; // R 型：无立即数（只为对称保留）

logic [31:0] imm_S; // S 型：store 的偏移

logic [31:0] imm_B; // B 型：分支偏移（已左移 1）

logic [31:0] imm_J; // J 型：jal 偏移（已左移 1）

logic [31:0] csrs; // CSR 读出的数据

logic [31:0] imm; // 最终选中的立即数

assign ready_last = ready_next; // 握手直通（本设计无背压）

assign valid_next = valid_last; // 握手直通

//-------------------------------------------------------------------------

// 字段切分：RISC-V 的字段位置是固定的，直接从 inst 里取

//-------------------------------------------------------------------------

assign oprand = inst[31:25]; // funct7

assign opcode = inst[6:0]; // 主操作码

assign rs1 = inst[19:15]; // 源寄存器 1

assign rs2 = inst[24:20]; // 源寄存器 2

assign funct3 = inst[14:12]; // 功能码 3 位

assign rd_next = inst[11:7]; // 目的寄存器

//-------------------------------------------------------------------------

// 三条"整条指令编码固定"的特殊指令：直接和 32 位常数比较

//-------------------------------------------------------------------------

assign ecall_flag = (inst == 32'b00000000000000000000000001110011); // ecall

assign mret_flag = (inst == 32'b00110000001000000000000001110011); // mret

assign fence_i_flag = (inst == 32'b00000000000000000001000000001111); // fence.i

//-------------------------------------------------------------------------

// CSR 写使能：4 位分别对应 4 个 CSR

// [0]=mepc(0x341) [1]=mcause(0x342) [2]=mstatus(0x300) [3]=mtvec(0x305)

// 只有 opcode 是系统指令、且立即数等于这个 CSR 地址时，才允许写

//-------------------------------------------------------------------------

assign csr_wen_next[0] = (opcode == `M_opcode && imm == 32'h341); // mepc

assign csr_wen_next[1] = (opcode == `M_opcode && imm == 32'h342); // mcause

assign csr_wen_next[2] = (opcode == `M_opcode && imm == 32'h300); // mstatus

assign csr_wen_next[3] = (opcode == `M_opcode && imm == 32'h305); // mtvec

//-------------------------------------------------------------------------

// 写回 / 访存 / 跳转 / 分支 控制

//-------------------------------------------------------------------------

// store、branch 不写寄存器；opcode==0 是空指令（NOP 被当成 0），也不写

assign R_wen_next = (opcode == `S_opcode || opcode == `B_opcode || opcode == 0)? 1'b0:1'b1;

assign mem_wen = (opcode == `S_opcode); // store 才写存储器

assign mem_ren = (opcode == `lw); // lw 才读存储器

assign jump_flag = (opcode == `jarl || opcode == `jal)? 1'b1:1'b0; // jalr / jal

// 分支取反：beq(000)/bge(101)/bgeu(111) 用"反向比较"来实现，省一条减法

assign inv_flag = (opcode == `B_opcode && (funct3 == 3'b101 || funct3 == 3'b111 || funct3 == 3'b000 ))? 1'b1:1'b0;

assign branch_flag = (opcode == `B_opcode)? 1'b1:1'b0; // 条件分支整体标志

//-------------------------------------------------------------------------

// 写回值预计算：跳转指令写 PC+4；CSR 指令写 CSR 旧值；其它指令写 0（真正结果由 EX 给）

//-------------------------------------------------------------------------

assign csr_addr = imm; // CSR 地址就藏在 imm 里（I 型编码）

assign rd_value_next = jump_flag? snpc: // jal/jalr：返回地址 = pc+4

(|csr_wen_next)? csrs: // csr 指令：写回 CSR 读值（| 表示非零）

0; // 其它：占位 0

assign branch_pc = pc + imm; // 分支目标 = 当前 PC + 偏移（ID 级就算好）

assign pc_out = pc; // 本级 PC 存进流水寄存器，后面算 auipc/jalr

//-------------------------------------------------------------------------

// ALU 两个操作数：在 ID 级就选好，EX 级直接送加法器

//-------------------------------------------------------------------------

// 操作数 A：lui 用 0；jal/auipc 用 PC；其余用 rs1

assign add1_value = (opcode == `lui)? 0 :

(opcode == `jal || opcode == `auipc )? pc :

EXU_rs1_in;

// 操作数 B：R/B 型用 rs2；csrrs/csrrc 用 rd_value_next；csrrwi 用 0；其余用立即数

assign add2_value = (opcode == `R_opcode || opcode == `B_opcode)? EXU_rs2_in :

(opcode == `M_opcode && funct3 == 3'b010)? rd_value_next :

(opcode == `M_opcode && funct3 == 3'b001)? 0 : imm;

//-------------------------------------------------------------------------

// ALU 操作码译码：一串三目运算（等价于优先级 case）

// 读法：A ? 结果 : B ? 结果 : ... : 最后默认值

// 1) 地址类/加法类 → alu_add

// 2) slt/blt/bge → alu_signed_comparator

// 3) sltu/bltu/bgeu→ alu_unsigned_comparator

// 4) xor / or / and / sll / srl / sra / sub

//-------------------------------------------------------------------------

assign alu_opcode = (opcode == `S_opcode || opcode == `lw

|| opcode == `lui || opcode == `auipc

|| opcode == `jal || opcode == `jarl

|| (opcode ==`addi && funct3 == 3'b000) || (opcode == `R_opcode &&

funct3 == 3'b000 && oprand[5] == 1'b0) || (opcode == `B_opcode &&

funct3[2:1] == 2'b01))?

`alu_add : (opcode == `addi && funct3 == 3'b010) || // slti

(opcode == `R_opcode && funct3 == 3'b010) || // slt

(opcode == `B_opcode && (funct3 == 3'b101 || funct3 == 3'b100))? // bge/blt

`alu_signed_comparator:

(opcode == `B_opcode && (funct3 == 3'b110 || funct3 == 3'b111)) || // bltu/bgeu

(opcode == `addi && (funct3 == 3'b011)) || // sltiu

(opcode == `R_opcode && (funct3 == 3'b011))? // sltu

`alu_unsigned_comparator:

(opcode == `addi && funct3 == 3'b100 ) || // xori

(opcode == `R_opcode && funct3 == 3'b100 )? // xor

`alu_xor : (opcode == `addi && funct3 == 3'b110 ) || // ori

(opcode == `R_opcode && funct3 == 3'b110 ) || // or

(opcode == `M_opcode && funct3 == 3'b010 )? // csrrs

`alu_or : (opcode == `addi && funct3 == 3'b111 ) || // andi

(opcode == `R_opcode && funct3 == 3'b111 )? // and

`alu_and : (opcode == `addi && funct3 == 3'b001 ) || // slli

(opcode == `R_opcode && funct3 == 3'b001 )? // sll

`alu_sll : (opcode == `addi && funct3 == 3'b101 && oprand[5] == 1'b0) || // srli

(opcode == `R_opcode && funct3 == 3'b101 && oprand[5] == 1'b0)? // srl

`alu_srl : (opcode == `addi && funct3 == 3'b101 && oprand[5] == 1'b1) || // srai

(opcode == `R_opcode && funct3 == 3'b101 && oprand[5] == 1'b1)? // sra

`alu_sra : (opcode == `R_opcode && funct3 == 3'b000 && oprand[5] == 1'b1)? // sub

`alu_sub : (opcode == `B_opcode && funct3[2:1] == 2'b00)? // beq/bne

`alu_equal:`alu_add; // 默认加法

// 注意：beq/bne 用 alu_equal 算出"相等"，再配合 inv_flag 决定是否取反

//-------------------------------------------------------------------------

// 立即数拼接（逐位对照 RISC-V 手册的编码图）

//-------------------------------------------------------------------------

assign imm_I = {{20{inst[31]}},inst[31:20]}; // I：signExt(inst[31:20])

assign imm_U = {inst[31:12],12'd0}; // U：inst[31:12]<<12

assign imm_R = {25'd0,inst[31:25]}; // R：无立即数，仅占位

assign imm_S = {{20{inst[31]}},inst[31:25],inst[11:7]}; // S：signExt(imm[11:5],imm[4:0])

assign imm_B = {imm_S[31:11],imm_S[0],imm_S[10:1]}<<1; // B：位重排后左移 1（偶数偏移）

assign imm_J = {{11{inst[31]}},inst[31],inst[19:12],inst[20],inst[30:21]}<<1; // J：位重排后左移 1

/* verilator lint_off IMPLICIT */

// 按 opcode 选立即数

assign imm = (opcode == `lw || opcode == `addi || opcode == `jarl || opcode == `M_opcode)? imm_I:

(opcode == `lui || opcode == `auipc)? imm_U:

(opcode == `jal)? imm_J:

(opcode == `B_opcode)? imm_B:

(opcode == `S_opcode)? imm_S:

(opcode == `S_opcode)? imm_R : // ← 原文笔误：这里再写 S_opcode，imm_R 永远选不中

0; // R 型本来不用立即数，所以无害，保留原样

// 读法提醒：立即数靠"opcode 决定格式"，不改 opcode、改 funct3 都还在同一格式里。

//-------------------------------------------------------------------------

// 例化寄存器栈：读 rs1/rs2 的值，并维护 mepc/mtvec/mcause 等 CSR

// （真正的寄存器堆在 cpu_RegisterFile.sv 里，这里是把"读口 + CSR + 调试口"打包）

//-------------------------------------------------------------------------

Reg_Stack Reg_Stack_inst0(

.reset(reset), // 复位

.clock(clock), // 时钟

.pc(pc), // 当前 PC（ecall 时存进 mepc）

.ecall_flag(ecall_flag), // ecall 触发

.exc_cause(exc_cause), // 异常原因（写 mcause）

.rs1(rs1), // 读口 1 地址

.rs2(rs2), // 读口 2 地址

.rd(rd), // 写口地址

.rd_value(rd_value), // 写口数据

.csr_addr(csr_addr), // CSR 地址

.R_wen(R_wen), // 通用寄存器写使能

.csr_wen(csr_wen), // CSR 写使能

.csrd(csrd), // CSR 读数据

.rs1_value(rs1_value), // 输出 rs1 值

.rs2_value(rs2_value), // 输出 rs2 值

.a0_value(a0_value), // 输出 a0（x10）值，调试用

.csrs(csrs), // 输出 CSR 值

.mepc_out(mepc_out), // 输出 mepc

.mtvec_out(mtvec_out) // 输出 mtvec

);

endmodule

### 1.2 寄存器堆

`timescale 1ns/1ps

//=============================================================================

// RegisterFile：32×32 位寄存器堆（RV32I 的 x0~x31）

//=============================================================================

// 【要点】

// 1) 两个**组合**读口（rs1/rs2）：只要给地址，当拍就出数据，不需要时钟。

// 这是 RISC-V 的便利之处：读不消耗周期。

// 2) 一个**同步**写口（wen + waddr + wdata）：时钟上升沿写入。

// 写口接的是 WB 级（写回），所以"读"永远看到的是已经提交的值。

// 3) x0 必须恒为 0：

// · 写口：`waddr != 0` 才写（防止被写坏）

// · 读口：`rs1_addr == 0 ? 0 : ...`（防止有人绕过写口）

// 4) a0（x10）单独引出一根线：测试程序把结果放在 a0 里，

// 仿真/板上的判定模块直接读它就知道程序跑出什么值。

// 5) reset 时把 32 个寄存器全清 0（for 循环，综合会展开成并行复位）。

//=============================================================================

// __opcode__（和其他文件重复定义，方便单文件搬走）

`define R_opcode 7'b0110011

`define lw 7'b0000011 // lw

`define addi 7'b0010011 // addi

`define jarl 7'b1100111 // jalr

`define S_opcode 7'b0100011 // store

`define B_opcode 7'b1100011 // 分支

`define lui 7'b0110111 // lui

`define auipc 7'b0010111 // auipc

`define jal 7'b1101111 // jal

`define M_opcode 7'b1110011 // CSR/ecall/mret

// alu 操作码（本模块用不到，保持与其他文件一致的宏集合，便于整体拷贝）

`define alu_add 4'b0000

`define alu_sub 4'b0001

`define alu_or 4'b0010

`define alu_and 4'b0011

`define alu_xor 4'b0100

`define alu_signed_comparator 4'b0101

`define alu_unsigned_comparator 4'b0110

`define alu_equal 4'b0111

`define alu_sll 4'b1000

`define alu_srl 4'b1001

`define alu_sra 4'b1010

`define Performance_Count

module RegisterFile #(ADDR_WIDTH = 5, DATA_WIDTH = 32) (

input clock, // 时钟

input [DATA_WIDTH-1:0] wdata, // 写数据（来自 WB 级）

input [ADDR_WIDTH-1:0] waddr, // 写地址（rd）

input wen, // 写使能（WB 级的 R_wen）

input reset, // 复位（清空全部寄存器）

input [ADDR_WIDTH-1:0] rs1_addr, // 读地址 1

input [ADDR_WIDTH-1:0] rs2_addr, // 读地址 2

output [DATA_WIDTH-1:0] rs1_value, // 读数据 1（组合输出）

output [DATA_WIDTH-1:0] rs2_value, // 读数据 2（组合输出）

output [DATA_WIDTH-1:0] a0_value // x10 (a0) 的值，测试判定用

);

// 32 个 32 位寄存器

logic [DATA_WIDTH-1:0] rf [2**ADDR_WIDTH-1:0];

//-------------------------------------------------------------------------

// 同步写口 + 复位

// · reset 为高：下一个沿把 32 个寄存器全部清 0

// · 否则 wen 且 waddr != 0：写入 wdata

// · x0 永远不写（waddr != 0 这个条件就是干这个的）

//-------------------------------------------------------------------------

always @(posedge clock) begin

if (reset) begin

for (int i = 0; i < 2**ADDR_WIDTH; i++) begin

rf[i] <= 0;

end

end else if (wen && waddr != 0) begin // x0 寄存器始终为 0

rf[waddr] <= wdata;

end

end

//-------------------------------------------------------------------------

// 组合读口

// 读 x0 时直接返回常数 0，不查表 —— 双保险，防止 x0 被写脏

//-------------------------------------------------------------------------

assign rs1_value = (rs1_addr == 0) ? 0 : rf[rs1_addr];

assign rs2_value = (rs2_addr == 0) ? 0 : rf[rs2_addr];

// a0 = x10：测试程序约定把结果放这里

assign a0_value = rf[10];

endmodule

### 1.3 Control（总调度）

`timescale 1ns/1ps

//=============================================================================

// Control：流水线控制单元（旁路/停顿/跳转/异常 的总决策器）

//=============================================================================

// 【它在流水线里的位置】

// 它是**纯组合逻辑**（没有时序），随时看"当前各级里是什么指令"，

// 然后当拍决定三件事：

// 1) 下一条 PC 去哪 → dnpc / dnpc_flag

// 2) 这一拍谁要作废 → EXU_inst_clear（冲刷 EX 级）、icache_clr

// 3) 操作数从哪来 → EXU_rs1_in / EXU_rs2_in（数据旁路）

// 另外还负责 load-use 冒险的一拍停顿 → IFU_stall

//

// 【为什么要有旁路（forwarding）】

// `addi x1, x0, 5` 刚在 EX 级算出 x1=5，下一条 `add x2, x1, x1` 在 ID 级读寄存器堆时，

// 前一条还没写回（要等 WB 级），读出来的是旧值。

// 做法：不真等，而是从"正在飞的指令"里把结果抄过来 —— 这就是旁路。

// 优先级：EX 级结果（最近）> MEM 级结果 > MEM 级 load 数据 > 寄存器堆原值（最旧）。

//

// 【load-use 冒险为什么必须停一拍】

// load 的数据要到 MEM 级末尾才从存储器出来，EX 级拿不到。

// 所以当"上一条是 load 且目标是本条要用的寄存器"时，只能让 IF 停一拍、

// 把 EX 级作废，等 load 的数据在 MEM 级出现后再旁路。

//=============================================================================

module Control(

input clock, // 时钟（本模块没用到，保留端口便于替换成时序版本）

input reset, // 复位（同上，没用到）

input [31:0] mtvec_out, // 异常入口地址（CSR mtvec）

input [31:0] mepc_out, // 异常返回地址（CSR mepc）

input [31:0] branch_pc, // EX 级算好的分支目标（pc+imm）

input [31:0] Ex_result, // EX 级 ALU 结果

input [31:0] MEM_Ex_result, // MEM 级的结果（= WB 写回值，旁路源）

input [31:0] MEM_Rdata, // MEM 级 load 读回的数据（旁路源）

input [31:0] IDU_rs1_value, // ID 级从寄存器堆读出的 rs1 原值

input [31:0] IDU_rs2_value, // ID 级从寄存器堆读出的 rs2 原值

input branch_flag, // EX 级：这是一条分支指令

input jump_flag, // EX 级：这是一条跳转指令（jal/jalr）

input mret_flag, // ID 级：mret

input ecall_flag, // ID 级：ecall

input MEM_mem_ren, // MEM 级：这是一条 load

input fence_i_flag, // EX 级：fence.i（清指令缓存）

input [4:0] IDU_rs1, // ID 级：本条指令的 rs1 号

input [4:0] IDU_rs2, // ID 级：本条指令的 rs2 号

input IDU_valid, // ID 级有真指令

input EXU_valid, // EX 级有真指令

input MEM_valid, // MEM 级有真指令

input ifault, // IF 级：取指地址越界（异常）

input [4:0] EXU_rd, // EX 级：目的寄存器号

input [4:0] MEM_rd, // MEM 级：目的寄存器号

input EXU_mem_ren, // EX 级：这是一条 load（下一拍就要用它的数据）

input EXU_R_Wen, // EX 级：要写寄存器堆

input MEM_R_Wen, // MEM 级：要写寄存器堆

output IFU_stall, // ★让 IF 级停一拍

output [31:0] EXU_rs1_in, // ★旁路后真正送进 ALU 的 rs1

output [31:0] EXU_rs2_in, // ★旁路后真正送进 ALU 的 rs2

output icache_clr, // 清取指缓存

output EXU_inst_clear, // ★冲刷 EX 级（把这条指令作废）

output [31:0] dnpc, // ★下一条 PC

output dnpc_flag, // ★要不要改 PC

output [1:0] exc_cause // 异常原因（给 CSR 用）

);

logic [1:0] IDU_rs1_choice; // rs1 的四选一控制码（由 Data_hazard 给出）

logic [1:0] IDU_rs2_choice; // rs2 的四选一控制码

// 预计算控制信号以减少关键路径

logic branch_taken; // 分支真的成立（要跳）

logic exception_or_jump; // 无条件改变 PC 的事件

logic stall_condition; // 需要停一拍

logic exc_misalign; // 目标地址不对齐

logic exc_trap; // 发生异常（要跳异常入口）

logic rs1_hazard, rs2_hazard; // rs1/rs2 撞上了上一条 load 的目标

//-------------------------------------------------------------------------

// 第一级：基本条件计算（都是组合，当拍出结果）

//-------------------------------------------------------------------------

// 分支是否成立：ALU 把"比较结果"塞在 bit0 上（beq 时 inv_flag 取反后 1=相等）

assign branch_taken = branch_flag & Ex_result[0];

// 这些指令一定会改 PC：jal/jalr、fence.i、mret、ecall

assign exception_or_jump = jump_flag | fence_i_flag | mret_flag | ecall_flag;

// 取指地址不对齐（IALIGN=32）：跳转/分支目标 bit[1] 非 0 即触发 mcause=0

// 注：mret/ecall 不走这条判断（它们的目标是 CSR 里的地址）

assign exc_misalign = ~mret_flag & ~ecall_flag &

((jump_flag & Ex_result[1]) | (branch_taken & branch_pc[1]));

// 只要"地址不对齐"或"取指越界"就进异常

assign exc_trap = exc_misalign | ifault;

// 异常原因编码：2'b10=取指越界，2'b01=地址不对齐，2'b00=正常

assign exc_cause = ifault ? 2'b10 : (exc_misalign ? 2'b01 : 2'b00);

// ---- load-use 冒险检测 ----

// x0 永远是 0，写 x0 不算数，所以 `EXU_rd != 5'b0` 必须判

assign rs1_hazard = (EXU_rd == IDU_rs1) && (EXU_rd != 5'b0);

assign rs2_hazard = (EXU_rd == IDU_rs2) && (EXU_rd != 5'b0);

// 上一条(EX 级)是 load，且它要写的寄存器正是本条要读的 → 停一拍

assign stall_condition = EXU_mem_ren && (rs1_hazard || rs2_hazard);

//-------------------------------------------------------------------------

// 第二级：输出信号

//-------------------------------------------------------------------------

// 要改 PC：分支成立 / 无条件跳转 / 异常

assign dnpc_flag = branch_taken | exception_or_jump | exc_trap;

// 要冲刷 EX 级：上面那些"改 PC"的情况都会让紧跟其后的指令作废；

// load-use 停顿也要作废（停的这一拍 EX 级里是条假指令）

assign EXU_inst_clear = branch_taken | exception_or_jump | stall_condition | exc_trap;

// 让 IF 级停一拍（PC 保持、不发新指令）

assign IFU_stall = stall_condition;

// fence.i：清指令缓存（本工程的 IROM 是组合读，实际只用来同步流水线）

assign icache_clr = fence_i_flag & EXU_valid;

//-------------------------------------------------------------------------

// 第三级：dnpc 选择（跳到哪里）—— 优先级从上到下

//-------------------------------------------------------------------------

logic [31:0] dnpc_reg;

always @(*) begin

if (exc_trap) // ① 异常最优先 → 去 mtvec

dnpc_reg = mtvec_out;

else if (jump_flag) // ② jal/jalr → 用 ALU 算出的目标

dnpc_reg = Ex_result;

else if (branch_flag) // ③ 分支 → 用 ID 级算好的 pc+imm

dnpc_reg = branch_pc;

else if (mret_flag) // ④ mret → 回 mepc

dnpc_reg = mepc_out;

else // ⑤ 其它（理论上不会走到，因为 dnpc_flag=0）

dnpc_reg = mtvec_out;

end

assign dnpc = dnpc_reg;

//-------------------------------------------------------------------------

// 第三级（并行）：数据旁路四选一

// choice 由 Data_hazard 模块根据"寄存器号是否相同 + 该级是否真的写"算出：

// 2'b00 → 用寄存器堆读出来的原值（最新鲜的旧值）

// 2'b01 → 用 EX 级 ALU 结果（上一条刚算出来）

// 2'b10 → 用 MEM 级结果（上上条的结果，已经在流水寄存器里）

// 2'b11 → 用 MEM 级 load 读回的数据

//-------------------------------------------------------------------------

logic [31:0] rs1_mux_reg, rs2_mux_reg;

always @(*) begin

case (IDU_rs1_choice)

2'b01: rs1_mux_reg = Ex_result; // 来自 EX 级

2'b10: rs1_mux_reg = MEM_Ex_result; // 来自 MEM 级

2'b11: rs1_mux_reg = MEM_Rdata; // 来自 load

default: rs1_mux_reg = IDU_rs1_value; // 寄存器堆原值

endcase

end

always @(*) begin

case (IDU_rs2_choice)

2'b01: rs2_mux_reg = Ex_result;

2'b10: rs2_mux_reg = MEM_Ex_result;

2'b11: rs2_mux_reg = MEM_Rdata;

default: rs2_mux_reg = IDU_rs2_value;

endcase

end

assign EXU_rs1_in = rs1_mux_reg;

assign EXU_rs2_in = rs2_mux_reg;

//-------------------------------------------------------------------------

// 旁路控制码生成：单独放在 Data_hazard 模块里（见 cpu_Data_hazard.sv）

//-------------------------------------------------------------------------

Data_hazard Data_hazard_inst(

.IDU_rs1(IDU_rs1),

.IDU_rs2(IDU_rs2),

.EXU_rd(EXU_rd),

.MEM_rd(MEM_rd),

.MEM_valid(MEM_valid),

.EXU_valid(EXU_valid),

.IDU_valid(IDU_valid),

.MEM_mem_ren(MEM_mem_ren),

.EXU_R_Wen(EXU_R_Wen),

.MEM_R_Wen(MEM_R_Wen),

.IDU_rs1_choice(IDU_rs1_choice),

.IDU_rs2_choice(IDU_rs2_choice)

);

endmodule

### 1.4 Data_hazard（冒险检测）

`timescale 1ns/1ps

//=============================================================================

// Data_hazard：数据冒险（旁路）选择器 —— 纯组合，只吐 2 位控制码

//=============================================================================

// 【一句话职责】

// 判断"我在 ID 级要用的 rs1/rs2"能不能从流水线更靠后的级直接抄过来，

// 并给出四选一控制码，交给 Control 去做真正的多路选择。

//

// 【控制码含义】（和 cpu_Control.sv 里的 case 一一对应）

// 2'b00 → 用寄存器堆读出的原值

// 2'b01 → 用 EX 级 ALU 结果（上一条指令刚算出来的）

// 2'b10 → 用 MEM 级结果（上上条指令的结果）

// 2'b11 → 用 MEM 级 load 读回的数据

//

// 【为什么要 `!= 5'b0`】

// x0 恒为 0，任何写 x0 的指令都是空操作；如果不排除，会出现

// "把某条指令的 rd=0 当成真依赖"而错误旁路，甚至覆盖 x0 的 0 值。

//

// 【为什么 EXU 优先于 MEM】

// EX 级是"最近"的指令，它的结果最新；

// 如果 EX 和 MEM 同时命中同一个寄存器，必须用 EX 的（MEM 那条更旧）。

//

// 【为什么 load 要特殊处理】

// load 的数据不在 Ex_result 里，而在存储器读口出来的 MEM_Rdata 里，

// 所以 MEM 级命中且这条是 load（MEM_mem_ren=1）时，选择码要给 2'b11。

// 注意：load 后面紧跟使用它的指令这种情况（load-use）光靠旁路救不了，

// 必须由 Control 的 stall_condition 停一拍（见 cpu_Control.sv）。

//=============================================================================

module Data_hazard(

input [4:0] IDU_rs1, // 本条指令的 rs1 号

input [4:0] IDU_rs2, // 本条指令的 rs2 号

input [4:0] EXU_rd, // EX 级指令的目的寄存器

input [4:0] MEM_rd, // MEM 级指令的目的寄存器

input IDU_valid, // 以下三个 valid 本实现里没用到，

input EXU_valid, // 保留是为了以后加"作废指令不参与旁路"用

input MEM_valid,

input MEM_mem_ren, // MEM 级这条是 load（要取读数据而不是 ALU 结果）

input EXU_R_Wen, // EX 级真的会写寄存器堆

input MEM_R_Wen, // MEM 级真的会写寄存器堆

output [1:0] IDU_rs1_choice, // rs1 的四选一控制码

output [1:0] IDU_rs2_choice // rs2 的四选一控制码

);

// 第一步：只比"寄存器号是否相同"（还没管这一级是不是真的要写）

logic exu_rs1_match, exu_rs2_match;

logic mem_rs1_match, mem_rs2_match;

// 第二步：再与上"这一级确实要写寄存器堆 (R_Wen)"

logic exu_rs1_valid, exu_rs2_valid;

logic mem_rs1_valid, mem_rs2_valid;

// 寄存器号相同，且不是 x0

assign exu_rs1_match = (EXU_rd == IDU_rs1) && (EXU_rd != 5'b0);

assign exu_rs2_match = (EXU_rd == IDU_rs2) && (EXU_rd != 5'b0);

assign mem_rs1_match = (MEM_rd == IDU_rs1) && (MEM_rd != 5'b0);

assign mem_rs2_match = (MEM_rd == IDU_rs2) && (MEM_rd != 5'b0);

// 命中 + 该级真的要写 → 才允许旁路

assign exu_rs1_valid = EXU_R_Wen && exu_rs1_match;

assign exu_rs2_valid = EXU_R_Wen && exu_rs2_match;

assign mem_rs1_valid = MEM_R_Wen && mem_rs1_match;

assign mem_rs2_valid = MEM_R_Wen && mem_rs2_match;

// 最终优先级：EX 级 > MEM 级(load 用 11 / 普通结果用 10) > 寄存器堆原值(00)

assign IDU_rs1_choice = exu_rs1_valid ? 2'b01 : (mem_rs1_valid ? (MEM_mem_ren ? 2'b11 : 2'b10) : 2'b00);

assign IDU_rs2_choice = exu_rs2_valid ? 2'b01 : (mem_rs2_valid ? (MEM_mem_ren ? 2'b11 : 2'b10) : 2'b00);

endmodule

## 二、按代码顺序讲 IDU

### 第 1 步 先看指令长什么样

RISC-V 的 32 位指令不是随意排的，字段位置是固定的：

字段 | 位置 | 作用
opcode | inst[6:0] | 主操作码，决定大类（R 型 / I 型 / load / store / 分支……）
rd | inst[11:7] | 目的寄存器号（写谁）
funct3 | inst[14:12] | 3 位功能码，细分同大类里的不同指令
rs1 | inst[19:15] | 源寄存器 1 号
rs2 | inst[24:20] | 源寄存器 2 号
funct7 | inst[31:25] | 7 位功能码（R 型用来分 add/sub、srl/sra）

所以 IDU 开头几行就是把字段切出来：

assign oprand = inst[31:25]; // funct7

assign opcode = inst[6:0]; // 主操作码

assign rs1 = inst[19:15];

assign rs2 = inst[24:20];

assign funct3 = inst[14:12];

assign rd_next= inst[11:7];

这几句在电路上就是按位取线，不消耗任何逻辑门——综合器直接连线。

### 第 2 步 拼立即数：五种拼法

分支、load/store、lui 这些指令带立即数，但立即数的位在指令里是打散的（为了让 rs1/rs2/rd 位置固定）。IDU 要把它们拼回来：

assign imm_I = {{20{inst[31]}}, inst[31:20]};

assign imm_U = {inst[31:12], 12'd0};

assign imm_S = {{20{inst[31]}}, inst[31:25], inst[11:7]};

assign imm_B = {imm_S[31:11], imm_S[0], imm_S[10:1]} << 1;

assign imm_J = {{11{inst[31]}}, inst[31], inst[19:12], inst[20], inst[30:21]} << 1;

类型 | 拼法 | 例子
I 型 | 指令的 bit31 复制 20 份补高位，接上 inst[31:20] | addi x1,x2,-1
U 型 | inst[31:12] 后面补 12 个 0（等于左移 12） | lui x1,0x12345
S 型 | 高位 inst[31:25] + 低位 inst[11:7] | sw x1,8(x2)
B 型 | 从 S 型重排位序，再左移 1（偏移一定是偶数） | beq x1,x2,label
J 型 | 位序大乱，再左移 1 | jal x1,label

{{20{inst[31]}}, ...} 是符号扩展：如果指令最高位是 1（负数），高 20 位全补 1。例：inst[31:20] 是 1111_1111_1111（-1），拼出来就是 0xFFFF_FFFF。

### 第 3 步 选立即数

assign imm = (opcode == `lw || opcode == `addi || opcode == `jarl || opcode == `M_opcode) ? imm_I :

(opcode == `S_opcode) ? imm_S :

(opcode == `B_opcode) ? imm_B :

(opcode == `lui || opcode == `auipc) ? imm_U : imm_J;

一串三目运算符 = 一个多路选择器。按主操作码选对应格式的立即数。这就是图里那个 RTL_MUX。

### 第 4 步 五类控制信号

IDU 输出的信号可以归成五类：

类别 | 信号 | 举例
写回 | R_wen_next、rd_next、rd_value_next | jal 的返回值是 pc+4
访存 | mem_ren、mem_wen | lw 置 mem_ren，sw 置 mem_wen
跳转 | jump_flag、branch_flag、branch_pc | branch_pc = pc + imm
算数 | alu_opcode、add1_value、add2_value | ALU 的操作码和两个操作数
CSR/异常 | csr_wen_next、mret_flag、ecall_flag、fence_i_flag | 4 位 CSR 写使能

其中 R_wen_next 这一行最关键：

assign R_wen_next = (opcode == `S_opcode || opcode == `B_opcode || opcode == 0) ? 1'b0 : 1'b1;

store 和分支不写寄存器，opcode=0（非法指令）也不写，其余都写。注意它和流水寄存器里的 `valid` 是两回事：R_wen_next 说"这条指令本身要不要写"，valid 说"这条指令现在还在不在流水线里"。两者必须同时为真才真的写（第 7 章讲）。

### 第 5 步 操作数 A/B 怎么选

assign add1_value = (opcode == `lui) ? 0 : ...

assign add2_value = (opcode == `R_opcode || opcode == `B_opcode) ? EXU_rs2_in : ...

- ALU 的 A 口：lui 时用 0（因为 lui 的结果就是立即数本身），其余用 rs1 的值；
- ALU 的 B 口：R 型和分支用 rs2 的值，其余用立即数。

为什么要传 EXU_rs1_in / EXU_rs2_in 进来？因为前递（forwarding）：rs1 的值可能还在 EX 级没写回，得从 EXU 那边直接拿最新的（第 10 章）。

### 第 6 步 寄存器堆：两读一写

cpu_RegisterFile.sv 是一个 32×32 的存储器，两个读口同时读（rs1、rs2），一个写口写（rd）。

assign rdata1 = (raddr1 == 0) ? 0 : regs[raddr1];

assign rdata2 = (raddr2 == 0) ? 0 : regs[raddr2];

raddr1 == 0 时强制读 0，这是第一道 x0 保护：x0 恒为 0，代码里 add x0,... 写不进去。

写口：

if (wen && waddr != 0) regs[waddr] <= wdata;

waddr != 0 是第二道保护：即使写使能为 1，写 x0 也不生效。

寄存器堆是写在前、读组合：读不经过时钟（当拍就能出数），写要等时钟上升沿。所以同一条指令里"读 rs1 和 rs2"是当拍完成，"写 rd"要等到 WB 级那一拍结束。

### 第 7 步 Control：一个模块管两件事

cpu_Control.sv 管两件事：下一拍 PC 去哪（dnpc）和要不要停/清流水。

dnpc 有五级优先，从上往下判断，谁先命中听谁的：

优先级 | 条件 | dnpc
1 | exc_trap（异常） | mtvec
2 | jump_flag（jal/jalr） | EXU_Ex_result（跳转目标已在 EX 级算好）
3 | branch_taken | branch_pc（ID 级算的 pc+imm）
4 | mret | mepc
5 | 默认 | snpc（pc+4）

assign branch_taken = branch_flag & Ex_result[0];

### 第 8 步 Data_hazard：四档旁路码

cpu_Data_hazard.sv 输出两个 2 位码，告诉 IDU 的"读寄存器"该怎么取数：

码 | 意思
00 | 用寄存器堆读出来的值
01 | 用 EX 级的结果（EXU_Ex_result）
10 | 用 MEM 级的结果（LSU_Rdata 或 Ex_result）
11 | 用 WB 级要写回的值

这就是"前递"：后面的指令要用的数还没写回寄存器堆，就直接从流水线中间抽过来。

### 第 9 步 停顿的判据

assign stall_condition = EXU_mem_ren && (rs1_hazard || rs2_hazard);

翻译：EX 级是一条 load，而 ID 级这条指令要用的寄存器正好是 load 要写的那个 → 停一拍。

为什么要停？因为 load 的数据要到 MEM 级结束才拿得到，EX 级那一拍还没有，没法前递。停一拍等它出来，代价是周期数 +1（本工程真实固件里 load-use 停顿时 13,684 拍，占 6.8%）。

## 三、本章小结

问题 | 答案
IDU 干什么 | 把 32 位机器码拆成"算数/访存/跳转/写回/CSR"五类信号
怎么做到 | 按位切字段 → 拼五种立即数 → 选立即数 → 按 opcode 生成控制信号
Control 干什么 | 定下一拍 PC（五级优先）+ 决定停不停、清不清
Data_hazard 干什么 | 四个 2 位码选旁路源 + 一个停顿信号
为什么要前后递 | 后一条指令要用的数可能还在流水线中间，没写回寄存器堆

## 自测

1. inst = 0x00C58533（add x10,x11,x12），opcode、rs1、rs2、rd 各是多少？

2. beq x1,x2,-8 的立即数在指令里是打散的，imm_B 拼出来是多少？为什么要左移 1？

3. 什么时候 stall_condition 为 1？如果去掉这个停顿，程序会错在哪？

# 第 6 章 IFU：PC 从哪来，指令怎么取

IFU = Instruction Fetch Unit，第一级。它只干两件事：维护 PC、把 PC 送出去换成指令。

## 一、全部代码

//=============================================================================

// 模块名 ：IFU（Instruction Fetch Unit，取指单元）

// 流水级 ：第 1 级 —— IF（取指）

// 干什么 ：维护"下一条要取的指令地址" PC，并把 IROM 的数据当成指令送出去。

// 它只管"地址怎么变"，不管"指令是什么意思"（那是 ID 级的事）。

// 关键点 ：

// 1) PC 复位值 0x8000_0000，是 IROM 的起始地址；

// 2) 正常情况 PC <= PC + 4（RISC-V 指令定长 4 字节）；

// 3) 一旦 dnpc_flag 有效（来自 ID 级的分支/跳转/陷入），PC <= dnpc，

// 这就叫"重定向/redirect"，是流水线清空(flush)的触发源；

// 4) stall 有效时 PC 保持不变（load-use 冒险时冻结取指）；

// 5) ready 是外部（多周期存储器）给的"可以继续"信号，本设计恒为 1。

// 说明 ：本模块没有寄存器堆、没有运算，全部逻辑就是"三选一的 PC 更新"。

//=============================================================================

`timescale 1ns / 1ps

/*interface define*/

// ---- 下面是 RISC-V 指令 opcode 的宏定义（CPU 各文件都复制一份，方便单独编译）----

`define R_opcode 7'b0110011 // R 型：add/sub/and/or/xor/sll/srl/sra/slt

`define lw 7'b0000011 // I 型 load：lw

`define addi 7'b0010011 // I 型算术：addi

`define jarl 7'b1100111 // I 型 jalr（原文拼写为 jarl，沿用不改）

`define S_opcode 7'b0100011 // S 型 store

`define B_opcode 7'b1100011 // B 型 条件分支 beq/bne/blt/bge...

`define lui 7'b0110111 // U 型 lui

`define auipc 7'b0010111 // U 型 auipc

`define jal 7'b1101111 // J 型 jal

`define M_opcode 7'b1110011 // 系统指令（ecall/mret/csr 类）

// ---- ALU 操作码宏定义（EX 级 cpu_ALU.sv 用，这里只为了各文件能独立编译）----

`define alu_add 4'b0000

`define alu_sub 4'b0001

`define alu_or 4'b0010

`define alu_and 4'b0011

`define alu_xor 4'b0100

`define alu_signed_comparator 4'b0101

`define alu_unsigned_comparator 4'b0110

`define alu_equal 4'b0111

`define alu_sll 4'b1000

`define alu_srl 4'b1001

`define alu_sra 4'b1010

`define Performance_Count // 打开性能计数器（统计拍数/CPI 用）

//=============================================================================

// 端口说明

// 输入 clock ：时钟，所有时序逻辑都在它的上升沿动作

// 输入 reset ：复位（高有效），把 PC 拉回 0x8000_0000

// 输入 dnpc[31:0] ：新的 PC 值（分支/跳转/陷入的目标地址）

// 输入 dnpc_flag ：新 PC 使能；=1 表示"这一拍就要跳"

// 输入 irom_data ：IROM 组合读出的指令字（地址已经由 pc 给出）

// 输入 stall ：取指冻结（load-use 冒险时由 Data_hazard 给）

// 输出 snpc[31:0] ：顺序 PC = pc + 4（送去 ID 级算 jal/jalr 的返回地址）

// 输出 pc[31:0] ：当前指令地址（同时直接接到 IROM 的地址口）

// 输出 inst[31:0] ：当前指令内容（就是 irom_data 直通）

// 输入 ready ：存储器就绪；本设计恒 1，保留是为了将来接慢速存储器

// 输出 ifault ：取指越界异常（PC 跑到 IROM 之外）

// 输出 valid ：取到的指令有效；本设计恒 1

//=============================================================================

module IFU(

input clock, // 时钟

input reset, // 复位，高有效

input [31:0] dnpc, // 重定向目标地址

input dnpc_flag, // 重定向使能

input [31:0] irom_data, // IROM 输出的指令

input stall, // 取指暂停

output [31:0] snpc, // pc + 4

output logic [31:0] pc, // 当前 PC

output [31:0] inst, // 当前指令

input ready, // 存储器就绪

output ifault, // 取指越界异常

output logic valid // 指令有效

);

localparam ResetValue = 32'h8000_0000; // 复位后第一条指令地址（IROM 基址）

assign valid = 1'b1; // 本设计取指永远有效（IROM 单拍返回）

// IROM 只有 16 KB（0x8000_0000 ~ 0x8000_3FFF）：

// pc[31:14] 必须等于 18'h2_0000（即高 18 位是 0x8000 >> … 精确说 0x8000_0000>>14 = 0x20000）

// 一旦不等，说明 PC 跑到 ROM 外面去了 —— 这就是"取指地址越界"异常。

assign ifault = (pc[31:14] != 18'h2_0000); // 1 = 越界

assign snpc = pc + 4; // 顺序下一条（指令 4 字节对齐）

assign inst = irom_data; // IROM 是组合读，当拍就能拿到指令

//-------------------------------------------------------------------------

// PC 更新：四种情况，优先级从高到低

// 1) reset → 回到 0x8000_0000

// 2) stall → 冻结（PC 不动，等前面那条 load 写完）

// 3) dnpc_flag → 跳转/分支/陷入，PC 取目标地址

// 4) 其他 → PC + 4，顺序执行

// 注意每个分支都带 valid & ready 条件：存储器没准备好就不动 PC。

//-------------------------------------------------------------------------

always @(posedge clock) begin

if (reset) // 复位优先

pc <= ResetValue; // 回到 ROM 起始

else if (stall & valid & ready) // 冒险暂停

pc <= pc; // 保持

else if (dnpc_flag & valid & ready) // 重定向

pc <= dnpc; // 跳到目标

else if (valid & ready) // 正常顺序执行

pc <= snpc; // PC += 4

end

endmodule

## 二、按代码顺序讲

### 第 1 步 复位到哪

localparam ResetValue = 32'h8000_0000;

复位后 PC 等于 0x8000_0000。为什么是这个怪数？因为板子上 IROM 就映射在这个地址（M 段），PC 从这开始取的第一条指令就是程序的第一条。

### 第 2 步 PC 的四种走法

always @(posedge clock) begin

if (reset) pc <= ResetValue;

else if (stall & valid & ready) pc <= pc;

else if (dnpc_flag & valid & ready) pc <= dnpc;

else if (valid & ready) pc <= snpc;

end

四条分支，优先级从上到下：

优先级 | 条件 | PC 变成 | 什么时候发生
1 | reset | 0x8000_0000 | 上电/按键复位
2 | stall | 不动 | load-use 冒险，等一拍
3 | dnpc_flag | dnpc | 分支成立、跳转、异常、mret
4 | 默认 | snpc = pc+4 | 正常顺序执行

这个 always 块编译出来就是一个 32 位寄存器 + 一个四选一 MUX。

### 第 3 步 snpc 和 inst

assign snpc = pc + 4;

assign inst = irom_data;

snpc 是"顺序下一条"，永远等于 pc+4（RISC-V 指令固定 4 字节）。inst 直接取 IROM 的输出——IROM 是组合读，地址给上去当拍就有数据，不需要等时钟。所以 IFU 一拍就能完成取指。

### 第 4 步 valid 恒为 1

assign valid = 1'b1;

本设计取指永远有效：IROM 组合读、单拍返回，没有"取指失败"这种情况。如果换成需要等待的存储器（比如外挂 SPI Flash），这里就要改成状态机。

### 第 5 步 越界检测

assign ifault = (pc[31:14] != 18'h2_0000);

0x8000_0000 的高 18 位是 0b10_0000_0000_0000_0000 = 0x20000。只要 PC 高 18 位不等于这个值，就说明 PC 跑出了 IROM 的 16 KB 范围（0x8000_0000~0x8000_3FFF）。

这个 ifault 是个探针：接出来看波形，能立刻发现"程序跑飞了"。第 8 章那个 736 拍的 bug，就是靠它定位的。

### 第 6 步 IROM 只接 12 根地址线

顶层里 IROM 的例化是：

Mem_IROM (.a(pc[13:2]), .spo(irom_data))

注意是 pc[13:2]，不是 pc[11:0]：

- pc[1:0] 永远是 0（指令 4 字节对齐），不用接；
- pc[13:2] 是 12 位，正好寻址 4096 条指令 = 16 KB；
- 用 pc[13:2] 而不是 pc[11:0]，等于把地址的低 14 位当偏移——0x8000_0000 和 0x8000_4000 会指向同一块，但 ifault 会拦住后者。

### 第 7 步 三个常见错误

错误写法 | 后果
pc <= pc + 1 | 按字节加，取到的是半条指令，全乱
用 pc[11:0] 接 IROM | 16 KB 的 IROM 只用了 4 KB 的地址空间，0x8000_1000 开始就回卷了
stall 时不判 valid & ready | 停顿时可能把已经废掉的指令又算一拍，PC 多走一步

## 三、本章小结

问题 | 答案
它干什么 | 维护 PC；把 PC 送给 IROM 换成指令
怎么做到 | 一个 32 位寄存器 + 四选一 MUX；snpc = pc+4；inst = irom_data
为什么一拍就取到 | IROM 组合读，地址进数据出
为什么复位到 0x8000_0000 | IROM 映射在 M 段
图上怎么认 | 顶层图里 Mem_IROM 左边 a[11:0]、右边 spo[31:0]，接的就是 IFU 的 PC

## 自测

1. 复位后第一拍、第二拍、第三拍的 PC 各是多少？

2. dnpc = 0x8000_0100、dnpc_flag = 1，下一拍 PC 是多少？

3. 如果 PC 跑到 0x8000_4000，ifault 是多少？为什么？

# 第 7 章 流水寄存器与写回：两道墙、一个总闸

五级流水线之所以能"五段同时干活"，靠的是工位之间的两道墙：IFID_EX_Reg 和 EX_LSWB_Reg。墙里是一排触发器，把上一级的结果锁住，下一级只看墙里的值。写回在最后一级 WBU 完成。

这一章讲三个文件：cpu_IFID_EX_Reg.sv、cpu_EX_LSWB_Reg.sv、cpu_WBU.sv，外加它们的通用积木 cpu_Reg.sv。

## 一、全部代码

### 1.1 流水寄存器通用单元

`timescale 1ns/1ps

//=============================================================================

// 模块名 ：Reg（带复位、带写使能的通用寄存器）

// 位置 ：被流水线寄存器模块（cpu_IFID_EX_Reg / cpu_EX_LSWB_Reg）反复例化

// 干什么 ：每个时钟上升沿，如果 wen=1 就把 din 存进 dout；reset 时清成 RESET_VAL。

// wen=0 时保持原值 —— 这就是流水线"暂停/气泡"的实现方式。

// 参数 ：WIDTH 位宽；RESET_VAL 复位值。

//=============================================================================

module Reg #(WIDTH = 1, RESET_VAL = 0) (

input clock, // 时钟

input reset, // 复位，高有效

input [WIDTH-1: 0]din, // 输入端

output logic [WIDTH-1: 0]dout, // 输出端（寄存后的值）

input wen // 写使能：1=更新，0=保持

);

always @(posedge clock) begin

if (reset) // 复位优先

dout <= RESET_VAL; // 清成指定初值

else if (wen) // 有写使能才更新

dout <= din; // 打一拍

end

endmodule

### 1.2 第一道墙

`timescale 1ns/1ps

//=============================================================================

// 模块名 ：IFID_EX_Reg（ID → EX 流水寄存器）

// 流水级 ：介于第 2 级 ID 和第 3 级 EX 之间的"隔板"

// 干什么 ：把 ID 级算好的所有信号，在时钟上升沿**同时**打一拍，送给 EX 级。

// 处理器能"流水"的根本原因就在这里：每一级只干自己那段活，

// 干完把结果推进寄存器，下一拍下一级接着干，上一级同时开始处理下一条。

// 三条规则（复刻时照抄这三条就不会错）：

// 1) reset=1 → 全部清 0（valid=0，相当于流水线里没有指令）

// 2) 有效且下一级接收 → 正常把本拍输入打进寄存器

// 3) 被冲刷(EXU_inst_clr) → 控制信号清零、valid 清零（这条指令被"擦掉"，

// 变成气泡 bubble；数据寄存器不清也无所谓，因为 valid=0 没人会用它）

// 为什么要"冲刷"：分支预测失败 / jal / jalr / 异常时，后面已经取进来的

// 错误指令必须作废，否则会写错寄存器、写错内存。

//=============================================================================

/*interface define*/

// __opcode__

`define R_opcode 7'b0110011 // R 型

`define lw 7'b0000011 // load

`define addi 7'b0010011 // 立即数算术

`define jarl 7'b1100111 // jalr

`define S_opcode 7'b0100011 // store

`define B_opcode 7'b1100011 // 条件分支

`define lui 7'b0110111 // lui

`define auipc 7'b0010111 // auipc

`define jal 7'b1101111 // jal

`define M_opcode 7'b1110011 // 系统指令

// ---- ALU 操作码 ----

`define alu_add 4'b0000

`define alu_sub 4'b0001

`define alu_or 4'b0010

`define alu_and 4'b0011

`define alu_xor 4'b0100

`define alu_signed_comparator 4'b0101

`define alu_unsigned_comparator 4'b0110

`define alu_equal 4'b0111

`define alu_sll 4'b1000

`define alu_srl 4'b1001

`define alu_sra 4'b1010

`define Performance_Count

module IFID_EX_Reg(

input clock, // 时钟

input reset, // 复位（同步，高有效）

input EXU_inst_clr, // 冲刷：把本拍要写入的指令变成气泡

// ---- 握手信号（本设计 ready 恒 1，但结构上保留）----

input valid_last, // 上一级（ID）给的 valid

input ready_last, // 给上一级的 ready

input ready_next, // 下一级（EX）给的 ready

output logic valid_next, // 送给下一级的 valid

// ---- 来自 IDU 的数据/控制 ----

input [2:0] funct3, // 功能码

input [3:0] csr_wen, // CSR 写使能

input R_wen, // 通用寄存器写使能

input mem_wen, // 写存储器

input mem_ren, // 读存储器

input [4:0] rd, // 目的寄存器号

input [31:0] pc, // 本条指令的 PC

input [3:0] alu_opcode, // ALU 操作码

input inv_flag, // 比较结果是否取反（分支用）

input jump_flag, // 跳转标志

input branch_flag, // 分支标志

input fetch_i_flag, // fence.i 标志

input [31:0] branch_pc, // 分支目标地址

input [31:0] rs2_value, // rs2 原值（store 数据用）

input [31:0] add1, // ALU 操作数 A

input [31:0] add2, // ALU 操作数 B

input [31:0] rd_value, // 预先算好的写回值

// ---- 送给 EXU 的同类信号（全部加 _reg 后缀）----

output logic [2:0] funct3_reg,

output logic [3:0] csr_wen_reg,

output logic R_wen_reg,

output logic mem_wen_reg,

output logic mem_ren_reg,

output logic [4:0] rd_reg,

output logic [31:0] pc_reg,

output logic [3:0] alu_opcode_reg,

output logic inv_flag_reg,

output logic jump_flag_reg,

output logic branch_flag_reg,

output logic fetch_i_reg,

output logic [31:0] branch_pc_reg,

output logic [31:0] rs2_value_reg,

output logic [31:0] add1_reg,

output logic [31:0] add2_reg,

output logic [31:0] rd_value_reg

);

//-------------------------------------------------------------------------

// ① valid 寄存器：决定"这一格流水里到底有没有一条真指令"

// 冲刷时置 0 → 后面各级看到 valid=0 就知道这是个气泡，什么都不能写。

//-------------------------------------------------------------------------

always @(posedge clock) begin

if(reset) // 复位：流水线清空

valid_next <= 1'b0;

else if(valid_last & ready_next & EXU_inst_clr) // 有指令但被冲刷

valid_next <= 1'b0;

else if(valid_last & ready_next) // 正常接收

valid_next <= 1'b1;

else // 上一级没给指令（气泡）

valid_next <= 1'b0;

end

//-------------------------------------------------------------------------

// ② 数据寄存器（PC、操作数、rd、funct3、ALU 码……）

// 只在"有效且下一级能收"时更新；复位清 0；冲刷时不清（valid=0 就够）

//-------------------------------------------------------------------------

always @(posedge clock) begin

if(reset)begin

funct3_reg <= 0;

rd_reg <= 0;

alu_opcode_reg <= 0;

inv_flag_reg <= 0;

rs2_value_reg <= 0;

add1_reg <= 0;

add2_reg <= 0;

rd_value_reg <= 0;

branch_pc_reg <= 0;

pc_reg <= 0;

end

else if(valid_last & ready_next)

begin

funct3_reg <= funct3; // 功能码

rd_reg <= rd; // 目的寄存器

alu_opcode_reg <= alu_opcode; // ALU 操作码

inv_flag_reg <= inv_flag; // 比较取反

rs2_value_reg <= rs2_value; // store 数据

add1_reg <= add1; // ALU A

add2_reg <= add2; // ALU B

rd_value_reg <= rd_value; // 写回值（jal 的 pc+4 等）

branch_pc_reg <= branch_pc; // 分支目标

pc_reg <= pc; // 本条 PC

end

end

//-------------------------------------------------------------------------

// ③ 控制寄存器：写使能一类信号。冲刷时必须清 0，

// 否则一条被作废的指令仍可能写寄存器/写内存，把结果搞坏。

//-------------------------------------------------------------------------

always @(posedge clock) begin

if(reset)begin

mem_ren_reg <= 0;

csr_wen_reg <= 0;

R_wen_reg <= 0;

mem_wen_reg <= 0;

jump_flag_reg <= 0;

branch_flag_reg <= 0;

fetch_i_reg <= 0;

end

else if(valid_last & ready_next & EXU_inst_clr)begin

mem_ren_reg <= 0; // 冲刷：禁止读内存

csr_wen_reg <= 0; // 禁止写 CSR

R_wen_reg <= 0; // 禁止写通用寄存器

mem_wen_reg <= 0; // 禁止写内存

jump_flag_reg <= 0; // 取消跳转

branch_flag_reg <= 0; // 取消分支

fetch_i_reg <= 0; // 取消 fence.i

end

else if(valid_last & ready_next) begin

mem_ren_reg <= mem_ren;

csr_wen_reg <= csr_wen;

R_wen_reg <= R_wen;

mem_wen_reg <= mem_wen;

jump_flag_reg <= jump_flag;

branch_flag_reg <= branch_flag;

fetch_i_reg <= fetch_i_flag;

end

end

endmodule

### 1.3 第二道墙

`timescale 1ns/1ps

//=============================================================================

// 模块名 ：EX_LSWB_Reg（EX → MEM 流水寄存器，名字里的 LSWB 是"load/store/wb"）

// 流水级 ：这是 5 级流水里的**第 3 到第 4 级之间的那道墙**

// IF → ID → EX → [EX_LSWB_Reg] → MEM(LSU) → WB(WBU)

// 干什么 ：把 EX 级算好的东西在时钟上升沿"锁"一份，下一拍交给 MEM 级用。

// 数据寄存器 + 控制寄存器都要锁：数据是 Ex_result/rs2/rd，控制是

// mem_ren/mem_wen/R_wen/csr_wen/jump_flag，漏一个就会出"写错寄存器"的幽灵 bug。

// 为什么需要它 ：每一级只做一件事、只占一拍；没有这道墙，EX 的组合结果会

// 直接冲进 MEM，级与级之间无法各自推进（也无法做 flush/stall）。

//

// ★ 读懂本文件的关键：`valid_next`（这一级现在有没有"真指令"）

// reset → 0（复位后流水线是空的）

// valid_last & ready_last → 1（上一级给了有效指令，且上一级也握手成功）

// 否则 → 0（上一级被冲刷/被暂停，这一级就作废）

// 注意这里只用了 ready_last，**没有**看 ready_next：

// 因为本级的 valid 表示"交给下一级的这一拍我有没有货"，

// 而下一级能不能收，由下一级自己的 valid/ready 逻辑去判断。

//

// ★ 数据寄存器的更新条件 `valid_last & ready_last`

// 两个条件同时成立才更新：上一级有货（valid）且双方握手成功（ready）。

// 被 flush 的那一拍不更新 → 里面的旧值保持，但 valid_next=0，

// 于是 LSU/WBU 看到 valid=0 就不会真的写内存/写寄存器。

//

// 复刻要点 ：

// 1) 所有 output 都必须是 `output logic`（过程赋值）；

// 2) reset 时**控制位全部清 0**（尤其 R_wen/mem_wen）——

// 否则复位那一刻流水线里的垃圾会写进寄存器堆或内存；

// 3) 冲刷（flush）时只依赖 valid 变 0 来屏蔽副作用，不必把数据也清零，

// 省掉一组复位优先级选择器。

//=============================================================================

/*interface define*/

// __opcode__（本文件其实没用到这些宏，但保留和其它模块一致的头部，方便整体移植）

`define R_opcode 7'b0110011

`define lw 7'b0000011 // lw

`define addi 7'b0010011 // addi

`define jarl 7'b1100111 // jalr

`define S_opcode 7'b0100011

`define B_opcode 7'b1100011

`define lui 7'b0110111 // lui

`define auipc 7'b0010111 // auipc

`define jal 7'b1101111 // jal

`define M_opcode 7'b1110011

// alu

`define alu_add 4'b0000

`define alu_sub 4'b0001

`define alu_or 4'b0010

`define alu_and 4'b0011

`define alu_xor 4'b0100

`define alu_signed_comparator 4'b0101

`define alu_unsigned_comparator 4'b0110

`define alu_equal 4'b0111

`define alu_sll 4'b1000

`define alu_srl 4'b1001

`define alu_sra 4'b1010

`define Performance_Count

module EX_LSWB_Reg (

input clock, // 时钟

input reset, // 同步复位（高有效）

// ---- 握手信号（valid/ready 协议，和 IFID_EX_Reg 完全一致）----

input valid_last, // 上一级（EX）这一拍有没有有效指令

input ready_last, // 上一级是否握手成功（EX 侧 ready）

input ready_next, // 下一级（MEM）是否准备好接收（本模块只透传，不参与判断）

output logic valid_next, // 本模块交给下一级的有效位

// ---- 从 EXU 来的数据/控制 ----

input mem_ren, // 是 load（读内存）

input mem_wen, // 是 store（写内存）

input R_wen, // 要写回寄存器堆

input [3:0] csr_wen, // 写哪个 CSR（mepc/mcause/mstatus/mtvec 各一位）

input [31:0] Ex_result, // EX 算出的结果（load/store 的地址 或 写回值）

input [4:0] rd, // 目的寄存器号

input [2:0] funct3, // 功能位（区分 lb/lh/lw、sb/sh/sw）

input [31:0] rs2_value, // store 要写的数据

input jump_flag, // 是跳转指令（jal/jalr）

input [31:0] rd_value, // 跳转时写回 pc+4

input [31:0] pc, // 当前指令地址（调试/CSR 用）

// ---- 交给 LSU/WBU 的数据/控制 ----

output logic mem_ren_reg, // 打一拍后的 mem_ren

output logic mem_wen_reg, // 打一拍后的 mem_wen

output logic R_wen_reg, // 打一拍后的 R_wen

output logic [3:0] csr_wen_reg, // 打一拍后的 csr_wen

output logic [31:0] Ex_result_reg, // 打一拍后的地址/结果

output logic [4:0] rd_reg, // 打一拍后的 rd

output logic [2:0] funct3_reg, // 打一拍后的 funct3

output logic [31:0] rs2_value_reg, // 打一拍后的 store 数据

output logic jump_flag_reg, // 打一拍后的 jump_flag

output logic [31:0] rd_value_reg, // 打一拍后的 pc+4

output logic [31:0] pc_reg // 打一拍后的 pc

);

//-------------------------------------------------------------------------

// ① 有效位：决定这一级"有没有真指令"

//-------------------------------------------------------------------------

always @(posedge clock) begin

if (reset) // 复位：流水线清空

valid_next <= 1'b0;

else if (valid_last & ready_last) // 上一级有货且握手成功 → 本级有货

valid_next <= 1'b1;

else // 上一级被冲刷 / 被暂停 → 本级作废

valid_next <= 1'b0;

end

//-------------------------------------------------------------------------

// ② 数据 + 控制：只在"上一级有货且握手成功"的那一拍更新

//-------------------------------------------------------------------------

always @(posedge clock) begin

if (reset) begin

// 复位时**控制位必须清零**，特别是 R_wen / mem_wen，

// 否则复位瞬间流水线里的旧值会把寄存器堆或内存写坏

mem_ren_reg <= 0;

mem_wen_reg <= 0;

R_wen_reg <= 0;

csr_wen_reg <= 0;

Ex_result_reg <= 0;

rd_value_reg <= 0;

rd_reg <= 0;

funct3_reg <= 0;

rs2_value_reg <= 0;

jump_flag_reg <= 0;

pc_reg <= 0;

end else if (valid_last & ready_last) begin

mem_ren_reg <= mem_ren; // load 标志

mem_wen_reg <= mem_wen; // store 标志

R_wen_reg <= R_wen; // 写回标志

csr_wen_reg <= csr_wen; // CSR 写使能

Ex_result_reg <= Ex_result; // 地址 / 结果

rd_value_reg <= rd_value; // 跳转写回的 pc+4

rd_reg <= rd; // 目的寄存器

funct3_reg <= funct3; // 访存宽度

rs2_value_reg <= rs2_value; // store 数据

jump_flag_reg <= jump_flag; // 跳转标志

pc_reg <= pc; // 指令地址

end

// 注意：else 分支什么都不做 = 保持原值（被暂停时流水寄存器不变）

end

endmodule

### 1.4 写回

`timescale 1ns/1ps

//=============================================================================

// 模块名 ：WBU（Write Back Unit，写回单元）

// 流水级 ：WB（第 5 级，最后一级）

// 干什么 ：决定"这条指令最后写回寄存器堆的值是哪一个"，并把写回使能交出去。

// 它是纯组合逻辑，本身没有寄存器；写回动作发生在 RegisterFile 里。

//

// ★ 写回值三选一（本模块唯一真正的逻辑，务必记牢）

// rd_value_next = (jump_flag | |csr_wen) ? rd_value // ① 跳转 or 写 CSR → pc+4 / csr 旧值

// : (mem_ren) ? MEM_Rdata // ② load → 存储器读回的数据

// : Ex_result; // ③ 其它 → ALU 结果

// 记忆口诀：跳转/CSR 优先，其次 load，最后才是 ALU。

// 为什么 CSR 要写回 rd_value（pc+4）？因为 CSR 指令（csrrw 等）要顺带

// 把 CSR 旧值写进 rd —— 旧值由 Reg_Stack 从 csrs 端口旁路给 rd_value，

// 这里只是选通路。

//

// ★ `R_wen_next = R_wen & valid`

// valid=0 表示这一拍流水线里是"被冲刷掉的假指令"，

// 即使它携带 R_wen=1，也绝不能真的写寄存器堆 —— 这一句就是防幽灵写回的闸门。

//

// ★ `ready = 1'b1`

// WB 是最后一级，永远能"接收"（写回在当拍就完成，不需要等），

// 所以 ready 恒 1。也正因为如此，WB 不会成为整条流水线的瓶颈。

//

// 复刻要点 ：三个输出

// 1) `pc_out` → 给 IFU 判断"现在该不该跳"（和 dnpc 比较）

// 2) `rd_value_next` → 写回数据

// 3) `R_wen_next` → 写回使能（已和 valid 与过）

//=============================================================================

/*interface define*/

// __opcode__（头部宏与其它模块保持一致，实际本文件未用到）

`define R_opcode 7'b0110011

`define lw 7'b0000011 // lw

`define addi 7'b0010011 // addi

`define jarl 7'b1100111 // jalr

`define S_opcode 7'b0100011

`define B_opcode 7'b1100011

`define lui 7'b0110111 // lui

`define auipc 7'b0010111 // auipc

`define jal 7'b1101111 // jal

`define M_opcode 7'b1110011

// alu

`define alu_add 4'b0000

`define alu_sub 4'b0001

`define alu_or 4'b0010

`define alu_and 4'b0011

`define alu_xor 4'b0100

`define alu_signed_comparator 4'b0101

`define alu_unsigned_comparator 4'b0110

`define alu_equal 4'b0111

`define alu_sll 4'b1000

`define alu_srl 4'b1001

`define alu_sra 4'b1010

`define Performance_Count

module WBU (

input clock, // 时钟（本模块不用，保留统一接口）

input reset, // 复位（本模块不用，保留统一接口）

input [31:0] MEM_Rdata, // 存储器读回的数据（load 结果）

input [31:0] Ex_result, // ALU 结果

input [31:0] rd_value, // 跳转时的 pc+4 / CSR 旧值

input [4:0] rd, // 目的寄存器号

input [3:0] csr_wen, // CSR 写使能（4 位分别对应 4 个 CSR）

input R_wen, // 要写回寄存器堆

input mem_ren, // 是 load

input jump_flag, // 是跳转

input [31:0] pc, // 指令地址

input valid, // 这一拍指令是否有效

output ready, // 本模块永远 ready

output valid_next, // 有效标志往下传

output R_wen_next, // 真正的写回使能（与 valid 相与）

output [3:0] csr_wen_next, // CSR 写使能

output [31:0] csrd, // 送给 CSR 的写数据（= ALU 结果）

output logic [31:0] pc_out, // 指令 PC（给 IFU 做跳转判断）

output [31:0] rd_value_next, // 最终写回数据

output [4:0] rd_next // 最终写回寄存器号

);

//-------------------------------------------------------------------------

// ① PC 直通（IFU 用它和 dnpc 比较，判断是否要 flush 前两级）

//-------------------------------------------------------------------------

assign pc_out = pc;

//-------------------------------------------------------------------------

// ② 有效位直通

//-------------------------------------------------------------------------

assign valid_next = valid;

//-------------------------------------------------------------------------

// ③ ★写回值三选一★

// 跳转 / 写 CSR → rd_value（pc+4 或 csr 旧值）

// load → MEM_Rdata（存储器读回的）

// 其它 → Ex_result（ALU 结果）

//-------------------------------------------------------------------------

assign rd_value_next = (jump_flag | (|csr_wen)) ? rd_value

: (mem_ren) ? MEM_Rdata

: Ex_result;

//-------------------------------------------------------------------------

// ④ CSR 写数据 & 写使能

//-------------------------------------------------------------------------

assign csrd = Ex_result; // CSR 新值来自 ALU 结果（csrrw 的 rs1）

assign csr_wen_next = csr_wen; // CSR 写使能透传

//-------------------------------------------------------------------------

// ⑤ ★写回使能必须与 valid 相与★

// 被冲刷的假指令即使带着 R_wen=1 也不能写寄存器堆

//-------------------------------------------------------------------------

assign R_wen_next = R_wen & valid;

//-------------------------------------------------------------------------

// ⑥ 目的寄存器号 & ready

//-------------------------------------------------------------------------

assign rd_next = rd;

assign ready = 1'b1; // 最后一级，永远能收

endmodule //WBU

## 二、按代码顺序讲

### 第 1 步 墙为什么必要

没有墙，五级就是一团组合逻辑：IFU 的 PC 一变化，立刻穿过 IDU、EXU、LSU、WBU，同一拍里全走完——这不是流水线，这是一条超长的组合路径，时钟频率会被拖到很低。

有了墙，每一级的输出先存进触发器，下一级下一拍才看得到。代价是延迟（一条指令要走 5 拍），收益是频率（每拍只需要走完一级）。

### 第 2 步 通用单元 cpu_Reg

module Reg #(parameter BW = 32) (

input clock,

input reset,

input [BW-1:0] din,

input en,

output logic [BW-1:0] dout

);

always @(posedge clock) begin

if (reset) dout <= {BW{1'b0}};

else if (en) dout <= din;

end

endmodule

这是"带使能的 D 触发器"，是所有墙的积木。en=0 时保持不动——这正是"停顿"能实现的物理基础。

### 第 3 步 墙里的三样东西

两道墙里存的信号分三类：

类别 | 例子 | 作用
数据 | add1_reg、add2_reg、rs2_value_reg | 下一级要算的东西
控制 | alu_opcode_reg、mem_ren_reg、R_wen_reg | 下一级要按什么规则处理
有效位 | valid_last → valid_next | 这条指令还在不在流水线里

控制信号必须跟着数据一起走，否则会出现"数据是这条指令的，控制是上一条的"——这种错在波形上极难找。

### 第 4 步 valid：三道防线

流水线里有三种情况会让指令"作废"：分支跳走了（后面的指令取错）、异常（要跳异常入口）、fence.i（清流水）。作废不能靠"删掉数据"（数据已经存在墙里了），只能靠 valid 位：

防线 | 位置 | 作用
第一道 | 清流水时把墙里 valid_next 置 0 | 让整条指令作废
第二道 | WBU 里 R_wen_next = R_wen & valid | 作废的指令不许写寄存器堆
第三道 | RegisterFile 里 waddr != 0 | x0 永远写不进

其中第二道最关键。如果只把数据清零、忘了清 R_wen，就会发生"幽灵写回"：一条本该作废的指令，把 rd 写成了 0。这种 bug 在波形上表现为"某个寄存器莫名其妙变 0"，极难查。

### 第 5 步 ready / stall 握手

每个模块都有 valid_last（上游给我有效数据）、ready_next（下游准备好了）、valid_next（我给下游有效数据）、ready_last（告诉上游我准备好了）。

本设计里这些握手大部分直接直通：

assign ready_last = ready_next;

assign valid_next = valid_last;

只有 WBU 的 ready 会往前传（EX_LSWB 的 ready_next(WBU_ready)）。真正的停顿来自 Data_hazard 的 stall，它同时作用在 IFU 的 PC 和两道墙上。

### 第 6 步 墙的两种写法

写法一：一个信号一个 `Reg`

Reg #(.BW(32)) add1_reg_inst (

.clock(clock), .reset(reset),

.din(add1_value), .en(en), .dout(add1_reg)

);

写法二：合并打包

Reg #(.BW(32+32+1)) pack_inst (

.din({add1_value, add2_value, valid_last}),

.dout({add1_reg, add2_reg, valid_next}),

);

本工程用的是写法一（一个信号一个实例），好处是 Vivado 图里能一个个看清；坏处是 EX_LSWB_Reg 里有 18 个实例、IFID_EX_Reg 里有 30 多个。

图 7-1 就是 EX_LSWB_Reg 的引脚图，18 个输入、12 个输出，全部带 _reg 后缀——这就是第二种写法的"引脚形态"。

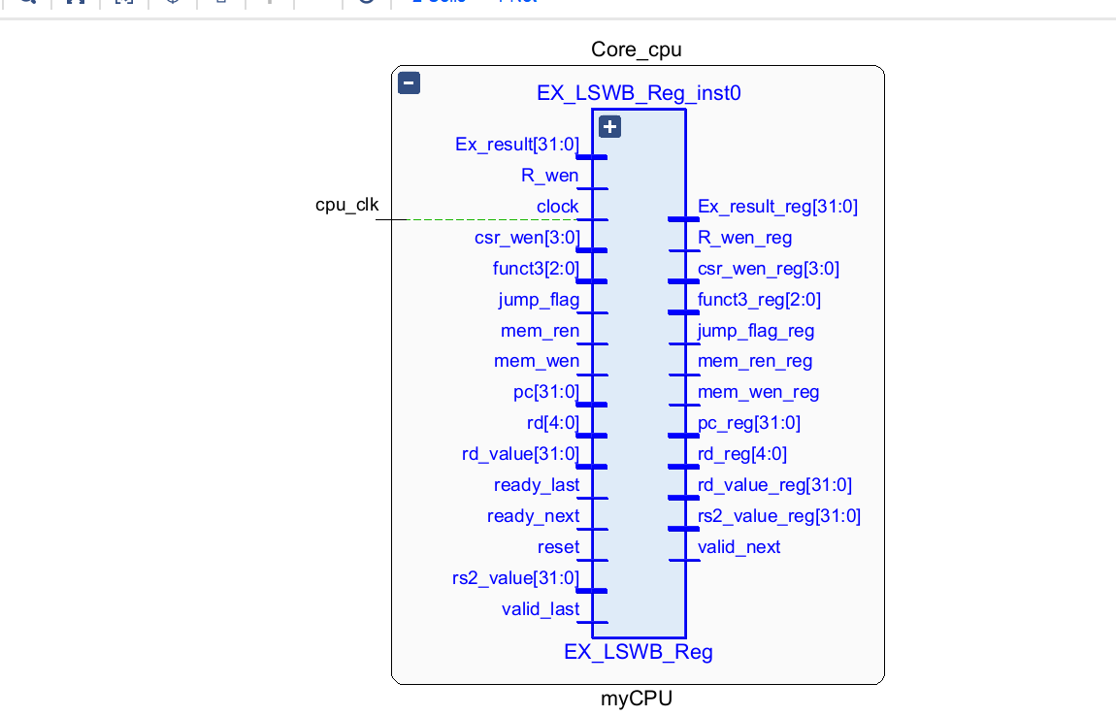
[picture p6: figure]

图 7-1　EX_LSWB_Reg_inst0 的引脚：左边 18 个输入、右边 12 个输出，全部是 _reg 后缀

### 第 7 步 资源账

墙 | 触发器数
IFID_EX_Reg | 184
EX_LSWB_Reg | 113
合计 | 297

全工程 1687 个触发器里，297 个（17.6%）花在流水线上——这是"并行"的门票钱。

### 第 8 步 写回：三选一

cpu_WBU.sv 是纯组合逻辑，没有触发器：

assign rd_value_next = jump_flag ? rd_value_reg : LSU_Rdata;

写回值三个来源：

来源 | 什么时候用
LSU_Rdata | load 指令（从存储器读回来的数）
Ex_result | 算数指令（ALU 结果）
rd_value_reg | 跳转指令（pc+4，返回地址）

选择靠 jump_flag 和 mem_ren。写使能：

assign R_wen_next = R_wen & valid;

这一句就是第 4 步说的第二道防线：作废的指令不许写。

### 第 9 步 为什么 WBU 不做成时序的

因为写回的最后一件事是"写寄存器堆"，而寄存器堆本身就是时序的（时钟沿写入）。如果再在 WBU 里加一级触发器，等于写回要两拍，valid 也要多传一拍，没意义。

纯组合的 WBU 还有个好处：延迟短，不占关键路径。

## 三、本章小结

问题 | 答案
墙干什么 | 锁住上一级的结果，让五级真正并行
墙里放什么 | 数据 + 控制 + valid
valid 干什么 | 标记"这条指令还有效"，作废时不写回
为什么 297 个触发器 | 并行要付的资源税
WBU 干什么 | 三选一选写回值，R_wen & valid 当总闸
图上怎么认 | 图 7-1 的 18 进 12 出，每个引脚都是一个触发器

## 自测

1. IFID_EX_Reg 的 en=0 时，墙里的值会变吗？为什么这能实现停顿？

2. 一条 beq 跳走后，后面已经取进来的两条指令怎么处理？

3. R_wen=1 但 valid=0，寄存器堆会被写吗？为什么？

# 第 8 章 LSU 与存储器：那个让 CPU 跑飞了 736 拍的 bug

LSU = Load Store Unit，第四级。它只管一件事：把地址、数据、宽度交给存储器，再把读回来的数按宽度扩展好。这一章还讲两个存储器（IROM、DRAM）和把外设挂在总线上的 perip_bridge。

## 一、全部代码

### 1.1 LSU

//=============================================================================

// 模块名 ：LSU（Load/Store Unit，访存单元）

// 流水级 ：MEM（第 4 级）

// 干什么 ：三件事

// 1) 把 EX 级递过来的地址/数据送出去给数据存储器（`addr/wen/wdata/mask/rdata`）；

// 2) 把读回来的原始 32 位数据按 funct3 切/扩成正确的 32 位

// （lb/lbu/lh/lhu/lw 五种宽度，注意有符号要符号扩展、无符号要补零）；

// 3) 把控制信号再往下透传给 WB 级（R_wen/csr_wen/rd/…）。

// 它是纯组合模块：LSU 内部**没有任何寄存器**，所以 MEM 这一级本身不额外吃拍，

// 真正的边界在 EX_LSWB_Reg（进）和后面 WB 级（出）。

//

// ★ funct3 编码（RISC-V 规范，读代码时对照看）

// 000 = lb 取字节，**符号扩展**

// 001 = lh 取半字，符号扩展

// 010 = lw 取整字

// 100 = lbu 取字节，**零扩展**

// 101 = lhu 取半字，零扩展

// 写内存那一侧：`mask = funct3_reg[1:0]`，由存储器按 mask 决定写几个字节

// （00=1 字节、01=2 字节、10=4 字节）

//

// ★ 数据对齐的坑（复刻时最容易漏）

// RISC-V 允许非对齐地址，硬件要按地址低位选字节。

// 这个 CPU 简化处理：读数据直接从 rdata[0+:8]/[0+:16] 取（默认访问是对齐的），

// 真正的字节选择放在了选通侧（mask / 存储器的行内偏移）。

// 如果自己实现时把地址低位丢了，lb 读 0x1001 会读到 0x1000 那一字节 —— 结果全错。

//

// ★ 为什么 `assign LSU_Rdata = rdata_ex;` 这一行当年出过 bug（已修，留作教训）

// 原来 DRAM.v 的读口是"1 拍寄存"（`spo <= mem[a]`），而 WBU 在**同一个沿**就采样

// LSU_Rdata，导致 load 拿到的是**上一个地址**的数据。

// 现在的修法：读地址改由 EX 级组合产生（见 dram_driver.sv 的 rd_addr），

// 让 BRAM 在 EX→MEM 这个沿就锁到真正的 load 地址，这一行就不用再改。

//=============================================================================

/* verilator lint_off UNUSEDSIGNAL */

`timescale 1ns / 1ps

module LSU(

// ---- 从 EX_LSWB_Reg 来的（已打一拍）----

input mem_ren_reg, // load 标志

input mem_wen_reg, // store 标志

input R_wen_reg, // 写回寄存器堆标志

input [3:0] csr_wen_reg, // CSR 写使能

input [31:0] Ex_result_reg, // load/store 地址（也兼作 ALU 结果）

input [4:0] rd_reg, // 目的寄存器号

input [2:0] funct3_reg, // 访存宽度/符号类型

input [31:0] rs2_value_reg, // store 写入数据

input jump_flag_reg, // 跳转标志

input [31:0] rd_value_reg, // 跳转写回值（pc+4）

input [31:0] pc_reg, // 指令地址

// ---- 透传给 WB 级 ----

output [31:0] rd_value_next, // 写回值（跳转时是 pc+4）

output R_wen_next, // 写回使能

output [31:0] LSU_Rdata, // 已按 funct3 对齐/扩展的读数据

output [3:0] csr_wen_next, // CSR 写使能

output [31:0] Ex_result_next, // ALU 结果（非 load 指令的写回值）

output [4:0] rd_next, // 目的寄存器号

output mem_ren_next, // load 标志（继续往下传）

output jump_flag_next, // 跳转标志

output [31:0] pc_next, // 指令地址

// ---- 直接连数据存储器（DRAM）的接口 ----

output [31:0] addr, // 访问地址（字节地址）

output wen, // 写使能

output [31:0] wdata, // 写数据

output [1:0] mask, // 写字节掩码：00=1B、01=2B、10=4B

input [31:0] rdata // 存储器读回的原始 32 位

);

logic [31:0] rdata_8i; // lb 结果（符号扩展）

logic [31:0] rdata_16i; // lh 结果（符号扩展）

logic [31:0] rdata_8u; // lbu 结果（零扩展）

logic [31:0] rdata_16u; // lhu 结果（零扩展）

logic [31:0] rdata_ex; // 最终选中的数据

//-------------------------------------------------------------------------

// ① 纯连线：控制/数据往下透传（MEM 级不改这些值）

//-------------------------------------------------------------------------

assign rd_value_next = rd_value_reg; // pc+4 直接过

assign R_wen_next = R_wen_reg; // 写回使能直接过

assign csr_wen_next = csr_wen_reg; // CSR 写使能直接过

assign Ex_result_next = Ex_result_reg; // ALU 结果直接过（WB 用它写回）

assign rd_next = rd_reg; // 目的寄存器直接过

assign mem_ren_next = mem_ren_reg; // load 标志直接过

assign jump_flag_next = jump_flag_reg; // 跳转标志直接过

assign pc_next = pc_reg; // PC 直接过

//-------------------------------------------------------------------------

// ② 送存储器的信号

//-------------------------------------------------------------------------

assign addr = Ex_result_reg; // 地址 = ALU 算出的有效地址

assign wdata = rs2_value_reg; // 写数据 = 源寄存器 2

assign wen = mem_wen_reg; // 只有 store 才写

assign mask = funct3_reg[1:0]; // 00:1B 01:2B 10:4B

//-------------------------------------------------------------------------

// ③ 读数据按宽度/符号整理

//-------------------------------------------------------------------------

assign LSU_Rdata = rdata_ex;

always @(*) begin

case (funct3_reg)

3'b000: rdata_ex = rdata_8i; // lb

3'b001: rdata_ex = rdata_16i; // lh

3'b010: rdata_ex = rdata; // lw（整字，不用处理）

3'b100: rdata_ex = rdata_8u; // lbu

3'b101: rdata_ex = rdata_16u; // lhu

default: rdata_ex = 0; // 其他（sb/sh/sw 不需要读）→ 0

endcase

end

// 零扩展：高位直接补 0

assign rdata_8u = {24'd0, rdata[7:0]};

assign rdata_16u = {16'd0, rdata[15:0]};

// 符号扩展：复用 cpu_sext 模块（把最高位复制到高位）

/* verilator lint_off PINMISSING */

sext #(

.DATA_WIDTH(8),

.OUT_WIDTH(32)

) sext_i8 (

.data(rdata[0+:8]), // 取低 8 位

.sext_data(rdata_8i) // 符号扩展到 32 位

);

sext #(

.DATA_WIDTH(16),

.OUT_WIDTH(32)

) sext_i16 (

.data(rdata[0+:16]), // 取低 16 位

.sext_data(rdata_16i) // 符号扩展到 32 位

);

endmodule //LSU

### 1.2 片内指令存储器

`timescale 1ns/1ps

// IROM: 4096 x 32, generated from coe/src0/irom.coe (case ROM, no IP)

module IROM(

input wire [11:0] a,

output reg [31:0] spo

);

always @(*) begin

case (a)

12'h000: spo = 32'h0013d117;

12'h001: spo = 32'h24410113;

12'h002: spo = 32'h16c010ef;

12'h003: spo = 32'h7a5000ef;

12'h004: spo = 32'h0000006f;

12'h005: spo = 32'hff010113;

12'h006: spo = 32'h00112623;

12'h007: spo = 32'h00812423;

12'h008: spo = 32'h01010413;

12'h009: spo = 32'h802007b7;

12'h00a: spo = 32'h0007a783;

12'h00b: spo = 32'h00078513;

12'h00c: spo = 32'h00c12083;

12'h00d: spo = 32'h00812403;

12'h00e: spo = 32'h01010113;

12'h00f: spo = 32'h00008067;

12'h010: spo = 32'hff010113;

12'h011: spo = 32'h00112623;

12'h012: spo = 32'h00812423;

12'h013: spo = 32'h01010413;

12'h014: spo = 32'h802007b7;

12'h015: spo = 32'h00478793;

12'h016: spo = 32'h0007a783;

12'h017: spo = 32'h00078513;

12'h018: spo = 32'h00c12083;

12'h019: spo = 32'h00812403;

12'h01a: spo = 32'h01010113;

12'h01b: spo = 32'h00008067;

12'h01c: spo = 32'hfd010113;

12'h01d: spo = 32'h02112623;

12'h01e: spo = 32'h02812423;

12'h01f: spo = 32'h03010413;

12'h020: spo = 32'hfca42e23;

12'h021: spo = 32'hfe042623;

12'h022: spo = 32'hfe042423;

12'h023: spo = 32'h0580006f;

### 1.3 小容量数据存储器（关键：它是时序读）

`timescale 1ns/1ps

// DRAM: 65536 x 32 simple-dual-port RAM

// NOTE: BRAM 上电为 0（PDS 综合时不要写 65536 次循环，会触发 "Loop limit 2000 exceeded"）

module DRAM(

input wire clk,

input wire [15:0] a,

output reg [31:0] spo,

input wire we,

input wire [31:0] d

);

reg [31:0] mem [0:65535];

initial begin

mem[16'h0003] = 32'h1234abcd;

mem[16'h0004] = 32'h55667788;

mem[16'h0007] = 32'hff0000ff;

end

always @(posedge clk) begin

if (we) mem[a] <= d;

spo <= mem[a];

end

endmodule

### 1.4 外设总线

`timescale 1ns / 1ps

//==========================================================================

// perip_bridge.sv — 外设总线桥（地址译码器 / MMIO）

//--------------------------------------------------------------------------

// 这个模块是 CPU 与外部世界之间的"前台"。CPU 只有一套 store/load 接口，

// 所有外设（DRAM、拨码、按键、数码管、LED、计时器）都挂在同一组地址上，

// 靠地址的高位来区分去哪个设备 —— 这就是所谓 MMIO（内存映射 I/O）。

//

// 地址分配（CPU 看到的 32 位地址）：

// 0x8010_0000 ~ 0x8013_FFFF → DRAM（256 KB，用低 18 位）

// 0x8020_0000 (+0x00) → 拨码开关 SW0（读）

// 0x8020_0004 (+0x04) → 拨码开关 SW1（读）

// 0x8020_0010 (+0x10) → 按键 KEY（读）

// 0x8020_0020 (+0x20) → 数码管 SEG（写）

// 0x8020_0040 (+0x40) → LED（写）

// 0x8020_0050 (+0x50) → 毫秒计时器（写魔数控制 / 读当前值）

//

// 两个关键概念：

// 1) 写通道：只有"落在某个地址上"的写才会生效（见两个 case）

// 2) 读通道：用"地址 == 常量"的掩码做**线与**，把多路数据 mux 起来，

// 未命中任何设备时返回 0xDEAD_BEEF（方便发现"读到了不存在的地址"）

//==========================================================================

module perip_bridge(

input logic clk,

input logic cnt_clk, // 计时器专用时钟（本设计=clk）

input logic rst,

// ---- CPU 访存接口（来自 MEM 级）----

input logic [31:0] perip_addr, // 访存地址

input logic [31:0] rd_addr, // **读**地址（EX 级提前给，见 dram_driver）

input logic [31:0] perip_wdata, // 写数据

input logic perip_wen, // 写使能

input logic [1:0] perip_mask, // 访问宽度：00=字节 01=半字 10=字

output logic [31:0] perip_rdata, // 读数据

// ---- 虚拟外设输入（板上没接，顶层给常数）----

input logic [63:0] virtual_sw_input, // 拨码开关值

input logic [7:0] virtual_key_input, // 按键值

// ---- 虚拟外设输出（板上没接，悬空）----

output logic [39:0] virtual_seg_output, // 数码管段码

output logic [31:0] virtual_led_output, // LED 寄存器

// ---- 给板级用 ----

output logic [31:0] ms_value, // 毫秒值（送 LED / 串口）

output logic ms_running // 计时中

);

//------------------------------------------------------------------

// 地址常量（写成 localparam 而不是宏，便于综合时被常量折叠）

//------------------------------------------------------------------

localparam logic [31:0] DRAM_ADDR_START = 32'h8010_0000; // DRAM 起点

localparam logic [31:0] DRAM_ADDR_END = 32'h8013_FFFF; // DRAM 终点（256KB）

localparam logic [31:0] SW0_ADDR = 32'h8020_0000; // 拨码 SW0

localparam logic [31:0] SW1_ADDR = 32'h8020_0004; // 拨码 SW1

localparam logic [31:0] KEY_ADDR = 32'h8020_0010; // 按键

localparam logic [31:0] SEG_ADDR = 32'h8020_0020; // 数码管

localparam logic [31:0] LED_ADDR = 32'h8020_0040; // LED

localparam logic [31:0] CNT_ADDR = 32'h8020_0050; // 毫秒计时器

//------------------------------------------------------------------

// 内部寄存器（可写的两个外设）

//------------------------------------------------------------------

logic [31:0] LED; // LED 寄存器

logic [39:0] seg_wdata; // 数码管寄存器

// 计时器回读值（由 counter 模块组合输出）

logic [31:0] cnt_rdata;

//------------------------------------------------------------------

// 写通道

// 只有 perip_wen 有效 且 地址精确匹配时才写入。

// 注意：这里用 perip_addr（MEM 级的地址），写是"正常时序"。

//------------------------------------------------------------------

always_ff @(posedge clk) begin

if (rst) begin

LED <= 32'd0;

seg_wdata <= 40'd0;

end else if (perip_wen) begin

case (perip_addr)

LED_ADDR: LED <= perip_wdata; // 写 LED 寄存器

SEG_ADDR: seg_wdata <= {8'd0, perip_wdata}; // 写数码管寄存器

default : ; // 其它地址：忽略

endcase

end

end

// 把寄存器值送到输出端口

assign virtual_led_output = LED;

assign virtual_seg_output = seg_wdata;

//------------------------------------------------------------------

// 读通道（组合逻辑）

// mmio_rdata 只负责"非计时器"的那几个设备；

// DRAM 和计时器的读数据在下面用掩码并到 perip_rdata 里。

// default 给 0xDEAD_BEEF：读到没实现的地址时，一眼就能看出来。

//------------------------------------------------------------------

logic [31:0] mmio_rdata;

always_comb begin

case (perip_addr)

SW0_ADDR: mmio_rdata = virtual_sw_input[31:0]; // 拨码低 32 位

SW1_ADDR: mmio_rdata = virtual_sw_input[63:32]; // 拨码高 32 位

KEY_ADDR: mmio_rdata = {24'd0, virtual_key_input};// 按键（8 位零扩展）

SEG_ADDR: mmio_rdata = seg_wdata[31:0]; // 读回数码管寄存器

LED_ADDR: mmio_rdata = LED; // 读回 LED 寄存器

default : mmio_rdata = 32'hDEAD_BEEF; // 未实现地址

endcase

end

//------------------------------------------------------------------

// DRAM：地址落在 0x8010_0000~0x8013_FFFF 时使能

// 送进去的是"低 18 位"，即 256KB 空间

//------------------------------------------------------------------

logic dram_sel;

logic [31:0] dram_rdata;

assign dram_sel = (perip_addr >= DRAM_ADDR_START) && (perip_addr < DRAM_ADDR_END);

dram_driver dram_driver_inst (

.clk (clk),

.perip_addr (perip_addr[17:0]), // 写/读地址（低 18 位）

.rd_addr (rd_addr), // **读**地址（EX 级，提前）

.perip_wdata(perip_wdata),

.perip_mask (perip_mask[1:0]), // 掩码：字节/半字/字

.dram_wen (perip_wen & (perip_addr >= DRAM_ADDR_START) && (perip_addr < DRAM_ADDR_END)),

.perip_rdata(dram_rdata) // 读回数据

);

//------------------------------------------------------------------

// 毫秒计时器：写 0x8020_0050 时使能；读时直接把 cnt_ms 送出去

//------------------------------------------------------------------

logic cnt_sel;

assign cnt_sel = (perip_addr == CNT_ADDR);

counter counter_inst (

.clk (cnt_clk),

.perip_wdata(perip_wdata),

.cnt_wen (perip_wen & cnt_sel), // 只有写这个地址才算数

.perip_rdata(cnt_rdata), // 读回毫秒数

.ms_value (ms_value), // 送给板级

.ms_running (ms_running)

);

//------------------------------------------------------------------

// 读数据汇总

// 每个设备配一个"地址是否命中"的 32 位掩码（全 0 或全 1），

// 用 & 选通、用 | 合并 —— 等价于一个多路选择器，

// 但这种写法综合出来的是一条很浅的或门树，时序更好。

//------------------------------------------------------------------

assign perip_rdata =

({32{dram_sel}} & dram_rdata) // DRAM

| ({32{cnt_sel}} & cnt_rdata) // 计时器

| ({32{~dram_sel & ~cnt_sel}} & mmio_rdata); // 其余 MMIO

endmodule

## 二、按代码顺序讲 LSU

### 第 1 步 两根线：地址和数据

assign addr = Ex_result_reg; // 地址 = ALU 算出的有效地址

assign wdata = rs2_value_reg; // 写数据 = 源寄存器 2

assign wen = mem_wen_reg; // 只有 store 才写

assign mask = funct3_reg[1:0]; // 00:1B 01:2B 10:4B

lw x1, 8(x2) 里的 8(x2) 就是 rs2_value + 8，而这个加法已经在 EX 级的 ALU 里做完了，Ex_result_reg 就是算好的地址。

### 第 2 步 宽度掩码

funct3[1:0] 直接当掩码用：

funct3 | 指令 | 掩码 | 宽度
000 | lb / sb | 00 | 1 字节
001 | lh / sh | 01 | 2 字节
010 | lw / sw | 10 | 4 字节

### 第 3 步 读回来的数按宽度扩展

assign rdata_8u = {24'd0, rdata[7:0]};

assign rdata_16u = {16'd0, rdata[15:0]};

lb 要符号扩展（rdata_8i），lbu 要零扩展（rdata_8u）。所以 lb 读 0xFF 得到 0xFFFF_FFFF（-1），lbu 读 0xFF 得到 0x0000_00FF（255）。

### 第 4 步 其余信号原样往下传

assign rd_value_next = rd_value_reg;

assign R_wen_next = R_wen_reg;

assign Ex_result_next = Ex_result_reg;

和 EXU 一样，LSU 只碰"访存"相关的几根线，别的直通。

## 三、那个 bug：DRAM 是时序读

### 第 5 步 DRAM 怎么读

always @(posedge clk) begin

if (we) mem[a] <= d;

spo <= mem[a]; // ← 关键在这一行

end

spo <= mem[a] 是时序赋值：地址 a 在时钟沿被采样，spo 在下一个时钟沿才更新。也就是说，地址给上去之后，要等一拍数据才出来。

而 IROM 是组合读（assign spo = mem[a]），地址给上去当拍就有数据。两个存储器的读时序不一样。

### 第 6 步 bug 是怎么发生的

LSU 把地址送出去，同一拍就去拿 rdata。如果 rdata 来自 DRAM（时序读），这一拍拿到的还是上一个地址的数据。

真实固件跑到第 736 拍时，PC 跳到 0x1234_5688——一个根本不存在的地址，程序跑飞，板上显示的毫秒数变成 29991 这种假数。

ifault 探针一接，立刻看到 PC 越界；再看 pc 的跳变时刻正好是某条 lw 之后一拍。

### 第 7 步 修法：地址提前一拍给

assign dram_addr = dram_wen ? perip_addr[17:2] : rd_addr[17:2];

assign perip_rd_addr = (EXU_mem_ren === 1'b1) ? EXU_Ex_result : 32'h8010_0000;

第一行：写的时候用 perip_addr，读的时候用 rd_addr（提前给出来的地址）。 第二行：EX 级一确认是 load，立刻把地址送到外设端口上，等 MEM 级用的时候，DRAM 已经在上一拍采过地址了，数据正好出来。

零成本修复：没有加触发器、没有加时钟周期，只改了两根线的取值时刻。

### 第 8 步 为什么小回归测试抓不到

小回归程序（1605 拍、结果 0x4e84）里没有任何一条 lw 后面紧跟用它的指令，而且读的地址都在 IROM（组合读）范围。DRAM 的时序读从来没被触发过。真实固件一上板，第一次读 DRAM 就炸。

教训：存储器模型的行为（组合读还是时序读）必须和 RTL 注释一致；测试要覆盖"读之后立刻用"的场景。

### 第 9 步 === 是什么

(EXU_mem_ren === 1'b1)

=== 是四值比较：1'b1、1'b0、1'bx、1'bz 都能比。仿真开头几拍很多信号是 x，用 == 会得到 x（被当成假），用 === 能得到确定的真假。这是仿真里的兜底写法。

## 四、perip_bridge：外设怎么挂上来

perip_bridge.sv 是 CPU 和外设之间的"接线板"。CPU 只认三根线：地址 perip_addr、写数据 perip_wdata、写使能 perip_wen。bridge 按地址高位决定这根写操作发给谁：

地址范围 | 外设 | 用途
0x8010_0000 附近 | counter | 毫秒计时器（写 0x8000_0000 启动，写 0xFFFF_FFFF 停止）
同上 | seg7 / display_seg | 数码管显示
同上 | dram_driver | 接 DRAM
按键/开关输入 | virtual_key_input、virtual_sw_input | 板上的按键和拨码开关

读方向反过来：CPU 给地址，bridge 从对应外设取数放回 perip_rdata。

## 三、本章小结

问题 | 答案
LSU 干什么 | 送地址/数据/掩码；把读回的数按宽度扩展
两个存储器有什么不同 | IROM 组合读（当拍出数），DRAM 时序读（下一拍出数）
bug 是什么 | LSU 当拍取数，DRAM 还在吐上一个地址的数据
怎么修的 | 地址提前一拍给（perip_rd_addr 用 EX 级地址）
为什么测试没抓到 | 小回归没触发 DRAM 读
bridge 干什么 | 按地址把 CPU 的写操作分发给不同外设

## 自测

1. lw x1,4(x2) 的 funct3 是多少？掩码是多少？

2. lb 读回 0xFF，写进寄存器是多少？lbu 呢？

3. DRAM 的 spo <= mem[a] 改成 assign spo = mem[a] 会发生什么？为什么不能这么改？

# 第 9 章 计时与串口：CPU 怎么把数字送出去

CPU 算完了，结果得让人看见。这一章讲两个"输出设备"：counter（毫秒计时器）和 ms_uart_tx（串口发送器）。

## 一、全部代码

### 1.1 毫秒计时器

`timescale 1ns / 1ps

//==========================================================================

// counter.sv — 毫秒计时器（"这套程序跑了多少毫秒"的裁判）

//--------------------------------------------------------------------------

// 用途：

// 比赛要求程序跑完后报一个"跑了多少毫秒"。CPU 自己不会数时间，

// 所以外面放一个独立计时器：CPU 在程序开头写一个魔数把它清零并启动，

// 在程序结尾再写一个魔数把它停住，之后读它就知道总耗时。

//

// 编程接口（CPU 通过 store/load 访问 0x8020_0050）：

// 写 0x8000_0000 → 启动（同时把毫秒数清零）

// 写 0xFFFF_FFFF → 停表（毫秒数不再增加，定格）

// 读 0x8020_0050 → 返回当前毫秒数 cnt_ms

//

// 计时原理：

// 50 MHz 时钟 → 50000 个时钟周期 = 1 ms

// 所以 cnt_1ms 从 0 数到 49999 就产生一个"毫秒脉冲"，

// 每来一次脉冲 cnt_ms 加 1。

//

// ⚠ 时钟必须与设计一致：本文件写死 49999（对应 50 MHz）。

// 如果板上实际是 27 MHz，就必须改成 26999，否则读数会偏大 1.85 倍。

//==========================================================================

module counter(

input logic clk, // 计时基准时钟

input logic rst, // 复位（清零全部）

input logic [31:0] perip_wdata, // 来自 CPU 的写数据（魔数）

input logic cnt_wen, // 本模块被写中时的写使能

output logic [31:0] perip_rdata, // 读回值（= 毫秒数）

output logic [31:0] ms_value, // 毫秒数（送给 LED / 串口的副本）

output logic ms_running // 1 = 正在计时

);

logic [15:0] cnt_1ms; // 1 毫秒内的时钟计数（0..49999）

logic [31:0] cnt_ms; // 毫秒计数（这就是最终要报的数）

logic start; // 运行标志

//------------------------------------------------------------------

// 启动 / 停表 控制

// 只有 CPU 写进来特定的两个魔数才动作，其它写值一律忽略

// 停表时**不清零** cnt_ms —— 要的就是"定格"住最后的数字

//------------------------------------------------------------------

always_ff @(posedge clk) begin

if (rst) begin

start <= 0; // 复位后不跑

end else if (cnt_wen & perip_wdata == 32'h8000_0000) begin

start <= 1; // 魔数 1：启动

end else if (cnt_wen & perip_wdata == 32'hFFFF_FFFF) begin

start <= 0; // 魔数 2：停表

end

end

//------------------------------------------------------------------

// 1 毫秒分频

// 数到 49999 就回 0（50000 个周期正好 1 ms @50MHz）

// 不跑的时候强制清零，保证每次启动都从"完整的一毫秒"开始

//------------------------------------------------------------------

always_ff @(posedge clk) begin

if (rst) begin

cnt_1ms <= 0;

end else if (start) begin

if (cnt_1ms == 49999) begin // 50000 拍 = 1 ms（50 MHz）

cnt_1ms <= 0;

end else begin

cnt_1ms <= cnt_1ms + 1;

end

end else begin

cnt_1ms <= 0; // 停表时清零，下次启动对齐

end

end

//------------------------------------------------------------------

// 毫秒累加

// 只有在"正在跑"且"刚好数满 1 ms"的那一拍才 +1

// 停表后这个值就定住了 → 读出来就是定格成绩

//------------------------------------------------------------------

always_ff @(posedge clk) begin

if (rst) begin

cnt_ms <= 0;

end else if (start && cnt_1ms == 49999) begin

cnt_ms <= cnt_ms + 1;

end

end

// 读口：CPU load 0x8020_0050 时拿到当前毫秒数（组合输出，同拍有效）

assign perip_rdata = cnt_ms;

// 给板级用：LED 和串口都拿这份值

assign ms_value = cnt_ms;

assign ms_running = start;

endmodule

### 1.2 串口（通用收发器）

`timescale 1ns / 1ps

//==========================================================================

// uart.sv — 通用异步收发器（8N1，115200 bps，本工程用来回传毫秒数）

//--------------------------------------------------------------------------

// 帧格式（8N1）：

// 空闲 = 高电平

// 起始位 1 个 = 0

// 数据位 8 个（**低位先发** LSB first）

// 停止位 1 个 = 1

// 一帧 10 个"位时间"，每位 = BAUD_DIV = CLK_FREQ / BAUD_RATE 个时钟

// 50 MHz / 115200 = 434（本工程取整，误差约 0.0064%，可接受）

//

// 本文件里有两套互相独立的状态机：

// rx_* ：接收（这里主要用来做"能收到东西"的验证，主流程用不到）

// tx_* ：发送（关键路径 —— 把 32 位毫秒数按字节发出去）

// 两份都用了"两次同步 + 边沿检测"处理异步输入（rx 来自外部引脚）。

//==========================================================================

module uart #(

parameter CLK_FREQ = 50000000, // 系统时钟频率

parameter BAUD_RATE = 115200 // 波特率

)(

input wire clk,

input wire rst_n, // 低有效复位

// 接收侧

input wire rx, // 串行输入

output reg [7:0] rx_data, // 收到的 1 字节

output reg rx_ready, // 收到数据后保持约半个位时间

// 发送侧

output reg tx, // 串行输出

input wire [7:0] tx_data, // 要发的字节

input wire tx_start, // 启动一拍

output reg tx_busy // 发送中（用于反压）

);

// 一个位时间需要多少个时钟

localparam BAUD_DIV = CLK_FREQ / BAUD_RATE;

//======================================================================

// 接收部分

//======================================================================

reg [1:0] rx_state;

reg [12:0] rx_cnt; // 位内计时

reg [7:0] rx_shift; // 移位寄存器

reg rx_d0, rx_d1, rx_d2; // 两级同步 + 一级延迟（做边沿检测）

//----------------------------------------------------------------------

// 异步输入同步（防止亚稳态）：rx → d0 → d1 → d2

//----------------------------------------------------------------------

always @(posedge clk or negedge rst_n) begin

if (!rst_n) begin

rx_d0 <= 1'b1; // 空闲是高电平

rx_d1 <= 1'b1;

rx_d2 <= 1'b1;

end else begin

rx_d0 <= rx;

rx_d1 <= rx_d0;

rx_d2 <= rx_d1;

end

end

// 下降沿检测：rx_d2=1 而 rx_d1=0 → 说明刚刚出现了起始位

wire rx_negedge = rx_d2 & ~rx_d1;

reg [3:0] rx_bit_cnt; // 已收几位

reg rx_ready_pulse; // 收完一字节的脉冲

reg [15:0] rx_ready_cnt;

//----------------------------------------------------------------------

// 接收状态机

// 0 空闲：等下降沿 → 置成 1，并把计时器预置半个位（对齐到位的中心）

// 1 等半个位：对齐到起始位中心

// 2 逐位采样：每满一个 BAUD_DIV 采一次 dr_rx，右移进 rx_shift

// 3 等停止位：收完第 8 位后再等一个位时间，输出 rx_data

//----------------------------------------------------------------------

always @(posedge clk or negedge rst_n) begin

if (!rst_n) begin

rx_state <= 0;

rx_cnt <= 0;

rx_bit_cnt <= 0;

rx_shift <= 0;

rx_data <= 0;

rx_ready_pulse <= 0;

end else begin

rx_ready_pulse <= 0;

case(rx_state)

0: begin

if(rx_negedge) begin

rx_state <= 1;

rx_cnt <= BAUD_DIV >> 1; // 半个位 → 采到起始位中心

rx_bit_cnt <= 0;

end

end

1: begin

if(rx_cnt == BAUD_DIV-1) begin

rx_cnt <= 0;

rx_state <= 2;

end else

rx_cnt <= rx_cnt + 1;

end

2: begin

if(rx_cnt == BAUD_DIV-1) begin

rx_cnt <= 0;

rx_shift <= {rx_d2, rx_shift[7:1]}; // LSB first

if(rx_bit_cnt == 7)

rx_state <= 3;

else

rx_bit_cnt <= rx_bit_cnt + 1;

end else

rx_cnt <= rx_cnt + 1;

end

3: begin

if(rx_cnt == BAUD_DIV-1) begin

rx_cnt <= 0;

rx_state <= 0;

rx_data <= rx_shift;

rx_ready_pulse <= 1'b1;

end else begin

rx_cnt <= rx_cnt + 1;

end

end

default: rx_state <= 0;

endcase

end

end

//----------------------------------------------------------------------

// rx_ready 展宽：收到一字节后保持约一个位时间的高电平

// （原注释写"半个 BAUD_DIV"，实际计数到 BAUD_DIV-1）

//----------------------------------------------------------------------

always @(posedge clk or negedge rst_n) begin

if (!rst_n) begin

rx_ready <= 1'b0;

rx_ready_cnt <= 0;

end else begin

if (rx_ready_pulse) begin

rx_ready <= 1'b1;

rx_ready_cnt <= 0;

end else if (rx_ready) begin

if (rx_ready_cnt < BAUD_DIV - 1) begin

rx_ready_cnt <= rx_ready_cnt + 1;

end else begin

rx_ready <= 1'b0;

end

end

end

end

//======================================================================

// 发送部分

//======================================================================

reg [3:0] tx_state;

reg [12:0] tx_cnt;

reg [3:0] tx_bit_cnt;

reg [9:0] tx_shift; // {停止位, 8 位数据, 起始位}

//----------------------------------------------------------------------

// 发送状态机

// 0 空闲：tx 保持高；检测到 tx_start → 装入 {1'b1, tx_data, 1'b0}

// 1 移位：每满一个位时间，把 tx_shift[0] 打到 tx 上，然后右移

// 总共发 10 位（起始位 + 8 数据 + 停止位）

//----------------------------------------------------------------------

always @(posedge clk or negedge rst_n) begin

if (!rst_n) begin

tx_state <= 0;

tx_busy <= 0;

tx_cnt <= 0;

tx_bit_cnt <= 0;

tx_shift <= 10'b1111111111;

tx <= 1'b1; // 空闲高

end else begin

case(tx_state)

0: begin

tx_busy <= 0;

if(tx_start) begin

tx_shift <= {1'b1, tx_data, 1'b0}; // 停止位 | 数据 | 起始位

tx_state <= 1;

tx_cnt <= 0;

tx_bit_cnt <= 0;

tx_busy <= 1;

end

end

1: begin

if(tx_cnt == BAUD_DIV-1) begin

tx_cnt <= 0;

tx <= tx_shift[0]; // 从起始位开始往外打

tx_shift <= {1'b1, tx_shift[9:1]}; // 右移，低位先发

if(tx_bit_cnt == 9)

tx_state <= 0; // 10 位发完

else

tx_bit_cnt <= tx_bit_cnt + 1;

end else

tx_cnt <= tx_cnt + 1;

end

endcase

end

end

endmodule

## 二、按代码顺序讲 counter

### 第 1 步 两个计数器

logic [15:0] cnt_1ms; // 1 毫秒内的时钟计数（0..49999）

logic [31:0] cnt_ms; // 毫秒计数

cnt_1ms 数到 49999 归零，同时 cnt_ms 加一。50 MHz 时钟下一个周期是 20 ns，50000 个周期正好 1 ms。

### 第 2 步 数到多少算 1 毫秒

if (cnt_1ms == 49999) begin // 50000 拍 = 1 ms（50 MHz）

cnt_1ms <= 0;

ms_value_next = cnt_ms + 1;

end

这里有个必须核对的前提：板子上的晶振到底是 50 MHz 还是 27 MHz。如果实际是 27 MHz，还是按 49999 数，那么"1 毫秒"实际是 1.85 毫秒，报出来的数会少 46%。

改法只有一处：把 49999 改成 26999（27 MHz ÷ 1000 - 1）。全工程只有这一个数需要改。

### 第 3 步 启动和停止靠"魔数"

if (cnt_wen & perip_wdata == 32'h8000_0000) start <= 1'b1; // 启动

else if (cnt_wen & perip_wdata == 32'hFFFF_FFFF) start <= 1'b0; // 停止

CPU 往这个外设写 0x8000_0000 就启动，写 0xFFFF_FFFF 就停止。用魔数而不是单独一根控制线，是为了省引脚——外设挂在总线上，只有地址、数据、写使能三根线。

### 第 4 步 读回来是什么

assign perip_rdata = cnt_ms;

assign ms_value = cnt_ms;

CPU 一读这个地址，拿到的就是当前毫秒数。ms_value 是给 LED 和串口用的副本。

## 三、按代码顺序讲串口

### 第 5 步 波特率怎么来的

localparam BAUD_DIV = CLK_FREQ / BAUD_RATE; // 50_000_000 / 115200 = 434

波特率 115200 意味着每位持续 1/115200 ≈ 8.68 µs。50 MHz 时钟下就是 434 个周期。所以发送器每数 434 拍移一位。

### 第 6 步 一帧十位

reg [9:0] tx_shift; // {停止位, 8 位数据, 起始位}

位 | 值 | 作用
起始位 | 0 | 告诉对方"开始了"
8 位数据 | 低位先发 | 真正的字节
停止位 | 1 | 告诉对方"这一帧完了"

tx_state 是状态机：空闲 → 起始位 → 8 位数据 → 停止位 → 回空闲。

### 第 7 步 本工程实际用的发送格式

top.v 里例化的 ms_uart_tx 不是上面这个通用 uart，而是一个更简单的定长帧发送器：

ms_uart_tx #(

.CLK_HZ(50_000_000), .BAUD(115200), .GAP_CLK(25_000_000)

) u_ms_tx (

.ms_value(ms_value), .tx(uart_tx)

);

它每 0.5 秒（GAP_CLK=25_000_000 拍）发一帧 6 字节：

字节 | 内容
1 | 0xAA（帧头）
2–5 | 毫秒数，高字节在前（m3 m2 m1 m0）
6 | 前 5 字节的异或校验

PC 端用 C:\temp\rd.py 读串口，收到 0xAA 就开始收 6 字节，校验对得上就打印毫秒数。这就是板上跑分时电脑上看到的数字来源。

### 第 8 步 接收方向

wire rx_negedge = rx_d2 & ~rx_d1;

rx_d0/rx_d1/rx_d2 是三级同步器：外部信号进 FPGA 先打两拍防亚稳态，再用第三拍和第一拍做边沿检测。检测到下降沿就是"起始位来了"，然后每 434 拍采一位，收满 8 位出数。

本工程的 CPU 不用接收方向（没有键盘输入），这段逻辑是给"从 PC 下载程序"留的。

## 三、本章小结

问题 | 答案
counter 干什么 | 每 50000 拍加 1，数出毫秒；CPU 读它拿时间
怎么启停 | 写魔数 0x8000_0000 启动、0xFFFF_FFFF 停止
27 MHz 怎么办 | 把 49999 改成 26999，全工程只此一处
串口怎么发 | 每 434 拍移一位，一帧 6 字节：AA + 4 字节毫秒 + 校验
为什么加同步器 | 外部信号进 FPGA 要防亚稳态

## 自测

1. 50 MHz 时钟下，cnt_1ms 数到 49999 需要多少纳秒？

2. 串口一帧 6 字节、每字节 10 位、115200 波特率，发一帧要多久？

3. 板子实际是 27 MHz 但代码按 50 MHz 数，程序报告 1000 ms 时，真实过了多久？

# 第 10 章 top：九个信号接出芯片

top.v 是整个工程唯一跟"板子"打交道的地方。它只做三件事：把时钟和复位接进来、把 myCPU 和几个外设连起来、把结果接到引脚上。

## 一、关键代码

top.v 全文 275 行，其中大部分是注释和引脚说明。这里贴最关键的四个部分。

### 1.1 顶层模块与端口

module top (

input wire clk, // 50 MHz 时钟（T9）

input wire rst_n, // 复位按键（W13），低有效

output wire [7:0] led, // 8 个 LED，低电平点亮

output wire uart_tx // 软 UART 发送脚（W6）

);

//------------------------------------------------------------------

// 复位同步器

// 异步按键 rst_n 直接当复位会引入亚稳态，所以先打 4 拍同步。

// rst_sync 的每一位都是 rst_n 延迟后的版本，这里只保留结构，

// 实际逻辑见下面的 DIAG 说明。

//------------------------------------------------------------------

reg [3:0] rst_sync; // 4 级同步移位寄存器

always @(posedge clk) rst_sync <= {rst_sync[2:0], rst_n}; // 每拍把 rst_n 往高位挤

// 【调试期绕过】上板验证时发现 BTN0 按下去会让 CPU 一直复位，

// 为了让程序上电就跑，直接把复位钉成 0（不复位）。

// 正式版应该改成：wire rst = ~rst_sync[3]; // 按键松开后才解除复位

wire rst = 1'b0; // DIAG: 忽略 BTN0，上电直接跑

//------------------------------------------------------------------

// 总线信号声明（CPU 与外部世界之间的所有线）

//------------------------------------------------------------------

wire [31:0] pc, instruction; // 取指地址 / 取回的指令

wire [31:0] perip_addr, perip_wdata, perip_rdata; // 外设：地址 / 写数据 / 读数据

wire [31:0] perip_rd_addr; // 外设：**读**地址（比写地址早一拍，见下）

wire perip_wen; // 外设写使能

wire [1:0] perip_mask; // 访问宽度：00=字节 01=半字 10=字

wire [39:0] seg40; // 数码管段码（本板没接，留空）

wire [31:0] led32; // 外设 LED 寄存器的值（本板没接，留空）

wire [31:0] ms_value; // 计时器的毫秒值

wire ms_running; // 计时器是否在跑

//------------------------------------------------------------------

// CPU 核（真正的流水线都在 myCPU 里）

//------------------------------------------------------------------

### 1.2 CPU 与外设的连接

myCPU Core_cpu (

.cpu_rst (rst), // 复位

.cpu_clk (clk), // 时钟

.irom_addr (pc), // 输出：下一条指令地址

.irom_data (instruction), // 输入：取回的指令

.perip_addr (perip_addr), // 输出：访存地址（MEM 级）

.perip_rd_addr (perip_rd_addr), // 输出：读地址（EX 级，提前给）

.perip_wen (perip_wen), // 输出：写使能

.perip_mask (perip_mask), // 输出：访问宽度

.perip_wdata (perip_wdata), // 输出：写数据

.perip_rdata (perip_rdata) // 输入：读回的数据

);

//------------------------------------------------------------------

// 指令 ROM

// 地址取 pc[13:2]：因为一字 4 字节，所以去掉低 2 位；

// 只取 14 位 => 16 KB 指令空间，足够放测试固件（2035 条）

//------------------------------------------------------------------

IROM Mem_IROM (

.a (pc[13:2]),

.spo (instruction)

);

//------------------------------------------------------------------

// 外设总线桥：地址译码 + 各外设

// 0x8010_0000 ~ 0x8013_FFFF → DRAM

// 0x8020_0040 → LED 寄存器

// 0x8020_0050 → 毫秒计时器

//------------------------------------------------------------------

perip_bridge bridge_inst (

.clk (clk),

.cnt_clk (clk), // 计时器用同一个时钟

.rst (rst),

.perip_addr (perip_addr),

.rd_addr (perip_rd_addr[17:0]),// **读地址**单独给（见 dram_driver 的注释）

.perip_wdata (perip_wdata),

.perip_wen (perip_wen),

.perip_mask (perip_mask),

.perip_rdata (perip_rdata),

.virtual_sw_input (64'd0), // 本板拨码没接，固定 0

.virtual_key_input (8'hFF), // 本板按键没接，固定全 1（不按下）

.virtual_seg_output(seg40), // 数码管输出（悬空）

.virtual_led_output(led32), // 外设 LED 输出（悬空）

.ms_value (ms_value), // 毫秒值 → 送 LED / 串口

.ms_running (ms_running) // 计时状态

);

//------------------------------------------------------------------

// LED 显示

// 设计意图：led = ~ms_value[7:0]（低 8 位毫秒，取反后输出，

// 因为 LED 是低电平点亮），程序停表后这个数就"冻住"，

// 人眼看到的二进制就是最终毫秒数的低 8 位。

// 正式版改成：assign led = ~ms_value[7:0];

//------------------------------------------------------------------

### 1.3 串口发送

assign led = 8'h00; // DIAG: 全灯亮（低有效）

//------------------------------------------------------------------

// 串口发送：把 ms_value 打包成 6 字节帧，每 0.5 秒发一次

//------------------------------------------------------------------

ms_uart_tx #(

.CLK_HZ (50_000_000), // 时钟频率

.BAUD (115200), // 波特率

.GAP_CLK (25_000_000) // 帧间隔 = 25M 拍 = 0.5 秒

) u_ms_tx (

.clk (clk),

.rst (rst),

.ms (ms_value), // 要发的毫秒值

.tx (uart_tx) // 输出脚

);

endmodule

//==========================================================================

// ms_uart_tx — 软 UART 发送器 + 帧打包器

//--------------------------------------------------------------------------

// 为什么自己写而不用现成的 uart.sv？

// 因为这里要的不只是"发一个字节"，而是"每 0.5 秒自动发一整帧 6 字节"，

// 把打包、间隔、字节序都放在一个模块里更省事。

//

// 结构分两块：

// (A) 字节串行器：把 1 个字节变成 起始位+8数据位+停止位 的波形

// (B) 帧打包器：决定"现在该发第几个字节"，并在发完 6 个后等 0.5 秒

//==========================================================================

### 1.4 复位同步与 LED

module ms_uart_tx #(

parameter integer CLK_HZ = 50_000_000, // 时钟频率

parameter integer BAUD = 115200, // 波特率

parameter integer GAP_CLK = 25_000_000 // 帧间隔（拍数）

)(

input wire clk,

input wire rst,

input wire [31:0] ms, // 当前毫秒值

output wire tx // 串口输出

);

// 1 个 bit 需要多少个时钟周期：50MHz / 115200 = 434.03 → 四舍五入 434

// 加 BAUD/2 再除，是为了做四舍五入而不是截断

localparam integer DIV = (CLK_HZ + BAUD/2) / BAUD; // 50MHz 下 = 434

//==================================================================

// (A) 字节串行器

//==================================================================

reg [15:0] cnt; // 位内计时：0..DIV-1

reg [3:0] bitn; // 当前发到第几位（0=起始位, 1..8=数据, 9=停止位）

reg [9:0] sh; // 移位寄存器：{停止位, 8位数据, 起始位}

reg busy; // 正在发送

reg tx_r; // 输出电平

assign tx = tx_r; // 输出到端口

// 下面这组变量属于帧打包器 (B)，因为串行器要用，所以提前声明

reg [2:0] bidx; // 当前发第几个字节 0..5

reg [7:0] cur_byte; // 当前要发的字节

reg [31:0] ms_lat; // 帧开始时锁存的毫秒值（防止发送途中数值变化）

reg [31:0] gap; // 帧间隔倒计时

reg start_pulse; // 通知串行器"可以发下一个字节了"

reg sent_hi; // 本字节是否已经被串行器接收

reg was_busy; // 上一拍的 busy，用来检测边沿

always @(posedge clk) begin

if (rst) begin

// 复位：线路保持空闲高电平

tx_r <= 1'b1; busy <= 1'b0; cnt <= 16'd0; bitn <= 4'd0; sh <= 10'h3FF;

end else if (!busy) begin

// 空闲态：线路为高，等 start_pulse 来

tx_r <= 1'b1;

if (start_pulse) begin

// 装载：bit9=停止位(1) bit8..1=数据 bit0=起始位(0)

sh <= {1'b1, cur_byte, 1'b0};

tx_r <= 1'b0; // 立刻拉低 = 起始位

cnt <= 16'd0;

bitn <= 4'd0;

busy <= 1'b1; // 进入发送态

end

end else begin

// 发送态：每 DIV 拍推进一位

if (cnt == DIV-1) begin

cnt <= 16'd0;

if (bitn == 4'd9) begin

// 停止位发完 → 回到空闲

busy <= 1'b0;

tx_r <= 1'b1;

end else begin

bitn <= bitn + 4'd1; // 下一位

tx_r <= sh[bitn + 4'd1]; // 数据是 LSB 先发

end

end else begin

cnt <= cnt + 16'd1; // 一位内继续计数

end

end

end

//==================================================================

// (B) 帧打包器

// 帧内容：AA m3 m2 m1 m0 XOR

// m3 = ms[31:24] ... m0 = ms[7:0]（大端）

// XOR = 前 5 字节异或，PC 端用它校验

//==================================================================

// 帧里 6 个字节的内容

wire [7:0] b0 = 8'hAA; // 帧头

wire [7:0] b1 = ms_lat[31:24]; // 毫秒 bit31..24

wire [7:0] b2 = ms_lat[23:16]; // 毫秒 bit23..16

wire [7:0] b3 = ms_lat[15:8]; // 毫秒 bit15..8

wire [7:0] b4 = ms_lat[7:0]; // 毫秒 bit7..0

wire [7:0] b5 = b0 ^ b1 ^ b2 ^ b3 ^ b4; // 校验字节

reg [7:0] byte_sel; // 按 bidx 选出当前字节

always @(*) begin

case (bidx)

3'd0: byte_sel = b0;

3'd1: byte_sel = b1;

3'd2: byte_sel = b2;

3'd3: byte_sel = b3;

3'd4: byte_sel = b4;

default: byte_sel = b5; // 3'd5

endcase

end

always @(*) cur_byte = byte_sel; // 组合赋值给串行器用

always @(posedge clk) begin

if (rst) begin

bidx <= 3'd0; ms_lat <= 32'd0; gap <= 32'd0;

start_pulse <= 1'b0; sent_hi <= 1'b0; was_busy <= 1'b0;

end else begin

start_pulse <= 1'b0; // 默认不启动（只保持 1 拍）

was_busy <= busy; // 记录上一拍的 busy，用来找边沿

// busy 上升沿：串行器已接收本字节 → 标记"这一字节已发出"

if (busy && !was_busy) sent_hi <= 1'b1;

// busy 下降沿：本字节发完了

if (!busy && was_busy) begin

sent_hi <= 1'b0;

if (bidx == 3'd5) begin

bidx <= 3'd0; // 一帧结束，回到帧头

gap <= GAP_CLK; // 开始 0.5 秒间隔

end else begin

bidx <= bidx + 3'd1; // 下一个字节

end

end

// 空闲且本字节还没被接收：要么等间隔，要么发起

if (!busy && !sent_hi) begin

if (gap != 32'd0) begin

gap <= gap - 32'd1; // 间隔倒计时

end else begin

// 帧头开始前锁存 ms，保证一帧 6 字节是同一个值

if (bidx == 3'd0) ms_lat <= ms;

start_pulse <= 1'b1; // 通知串行器发这一字节

end

end

end

end

endmodule

## 二、按代码顺序讲

### 第 1 步 对外只有九个信号

信号 | 方向 | 引脚 | 说明
clk | 入 | T9 | 板载晶振（手册写 50 MHz，另一份写 27 MHz，需实测确认）
rst_n | 入 | W13 | BTN0，低电平有效
led[7:0] | 出 | G14/E18/E19/F16/F17/H18/E17/H15 | 8 个 LED
uart_tx | 出 | W6 | 串口发送，接 J8 第 23 脚

板子上还有数码管、按键、拨码开关，它们都通过 perip_bridge 挂到 CPU 的总线上，不直接占 top 的端口。

### 第 2 步 五个实例

top 里例化了五样东西：

实例名 | 模块 | 作用
Core_cpu | myCPU | CPU 本体
Mem_IROM | IROM | 16 KB 指令存储器
bridge_inst | perip_bridge | 外设总线
u_ms_tx | ms_uart_tx | 串口发送器
—（无） | — | 数据存储器在 bridge 里

### 第 3 步 CPU 的三组连线

Core_cpu 对外只有三组线：

组 | 信号 | 去哪
取指 | irom_addr[11:0] 出、irom_data[31:0] 回 | Mem_IROM
外设 | perip_addr、perip_wdata、perip_wen 出；perip_rdata 回 | bridge_inst
中断/异常 | irq_* | 本设计未用

### 第 4 步 复位同步

reg rst_sync0, rst_sync1;

always @(posedge clk) begin

rst_sync0 <= ~rst_n;

rst_sync1 <= rst_sync0;

end

wire rst = rst_sync1;

异步复位（按键）进 FPGA 后先打两拍同步，避免"复位撤销的时刻正好在时钟沿附近"导致亚稳态。这是所有上板设计的标准动作。

### 第 5 步 DIAG 版和正式版的差别

当前工作区里的 top.v 是诊断版，有两处刻意的改动：

wire rst = 1'b0; // 忽略 BTN0，永不复位

assign led = 8'h00; // 8 个灯全亮

正式版应该是：

assign led = ~ms_value[7:0]; // 毫秒数低 8 位取反送 LED

为什么诊断版要这么改？因为排查板上问题时，要排除"复位键抖动"和"LED 极性"两个变量。把复位固定成 0、灯固定全亮，如果板上还是不对，就说明问题不在复位和 LED。

### 第 6 步 约束文件三处坑

kosmo_pins.xdc 里定义引脚和时钟。踩过三个坑：

坑 | 现象 | 修法
写了 12 组 uart_tx2..13 但板上没有 | 综合报"引脚不存在" | 删掉，重写成 26 行
时钟周期按 50 MHz 写，实际 27 MHz | 时序报告假通过，上板跑飞 | 按实测频率改 create_clock
复位没写 set_false_path | 复位路径参与时序分析，报假违例 | 对复位加 set_false_path

## 三、本章小结

问题 | 答案
top 干什么 | 接时钟复位、连 CPU 与外设、接引脚
对外几个信号 | 4 组：clk、rst_n、led[7:0]、uart_tx
五个实例 | Core_cpu / Mem_IROM / bridge_inst / u_ms_tx
为什么要复位同步 | 防亚稳态
DIAG 版改了什么 | 复位固定 0、LED 固定全亮

## 自测

1. top 的端口里哪个是低有效？代码里怎么处理的？

2. CPU 的 irom_addr 只有 12 位，为什么够用？

3. 如果 LED 接反了（本该亮的灭），改哪一行？

# 第 11 章 整机：一条指令的一生

前面九章把每个模块拆开讲完了。这一章不再贴代码，只讲数据怎么在这些模块之间流动，以及五个工位是怎么同时干活的。

## 一、CPU 对外只有九组线

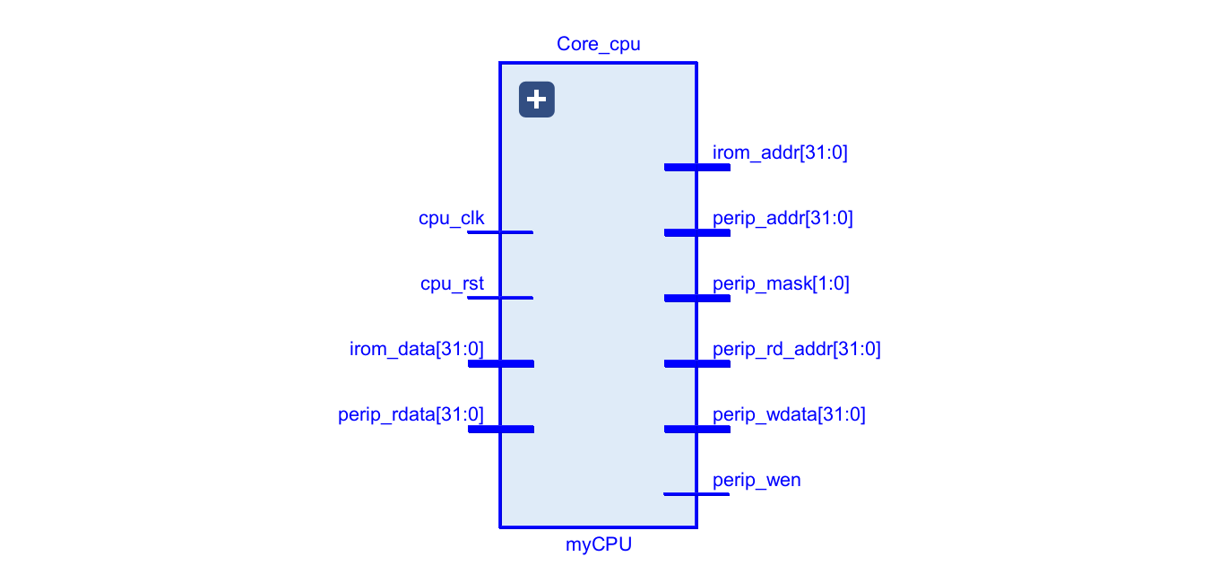
[picture p7: figure]

图 11-1　myCPU 的全部引脚：左边是时钟复位和取指，右边是外设总线和调试信号

整台 CPU 被封成一个方块，外面只露出九组线。左边三组进去（时钟、复位、IROM 数据），右边几组出来（PC 地址、外设地址/数据/使能、调试信号）。

记住这张图：CPU 跟外界只有两个通道——一个取指令（只读），一个读写外设。没有别的。

## 二、一条指令的五段路

以 addi x1, x1, 1（把 x1 加 1）为例，看它怎么穿过五个工位：

拍 | 工位 | 谁在干活 | 这一拍发生了什么 | 结果存进哪
1 | IF | IFU | PC=0x80000000 送 IROM，拿回 32 位指令 | IFID_EX_Reg 的 inst_reg
2 | ID | IDU + Control | 拆字段：opcode=0010011、rs1=1、rd=1、imm=1；读 x1=5 | IFID_EX_Reg 的 add1_reg=5、add2_reg=1、alu_opcode=0000
3 | EX | EXU + ALU | ALU 算 5+1=6 | EX_LSWB_Reg 的 Ex_result_reg=6
4 | MEM | LSU | 不是 load/store，直通 | Ex_result_next=6
5 | WB | WBU + RegisterFile | 写 x1=6 | 寄存器堆 x1 变成 6

关键点：第 2 拍的时候，IF 级已经在取第二条指令了。这就是流水线——工位不空着。

## 三、五条指令同时在线

程序是 addi / addi / addi / addi / addi 五条连着。跑到第 5 拍时，流水线里是这样的：

工位 | 第 1 拍 | 第 2 拍 | 第 3 拍 | 第 4 拍 | 第 5 拍
IF | 指令1 | 指令2 | 指令3 | 指令4 | 指令5
ID | — | 指令1 | 指令2 | 指令3 | 指令4
EX | — | — | 指令1 | 指令2 | 指令3
MEM | — | — | — | 指令1 | 指令2
WB | — | — | — | — | 指令1

五条指令同时在五个工位上，各干各的。第 5 拍结束，指令 1 出结果；第 6 拍结束，指令 2 出结果……稳定之后每拍出一条指令的结果。

这就是为什么"五级流水"平均一条指令只花一拍，而不是五拍。本工程真实固件的 CPI 是 1.073——比理想的 1.0 多了 7.3%，多出来的部分就是停顿（load-use）和冲刷（分支）。

## 四、模块之间的"交接"

### 4.1 PC 的交接

IFU.pc ──→ IROM.a ──→ IROM.spo ──→ IFU.inst ──→ IFID_EX_Reg.inst_reg

↑ │

└──── dnpc ←── Control.dnpc ◄── EXU/branch_pc ◄──────┘

PC 不是一个模块自己管的：IFU 存着它，Control 决定它下一个值是什么。正常时 Control 给 snpc，分支时给 branch_pc，跳转时给 Ex_result，异常时给 mtvec。

### 4.2 操作数的交接

RegisterFile.rdata1 ──→ IDU.add1_value ──→ IFID_EX_Reg.add1_reg ──→ EXU.add1_reg ──→ ALU.d1

↑ │

└──────────── WB 写回（rd_value） ←── WBU ←── LSU ←── EX_LSWB_Reg ←──────────┘

注意那条从 ALU 回到寄存器堆的虚线：正常情况数据要走完 MEM、WB 才写回寄存器堆；为了不让后面的指令干等，Data_hazard 从中间抽数（前递），把 EXU.Ex_result 或 LSU.Rdata 直接塞给 IDU。

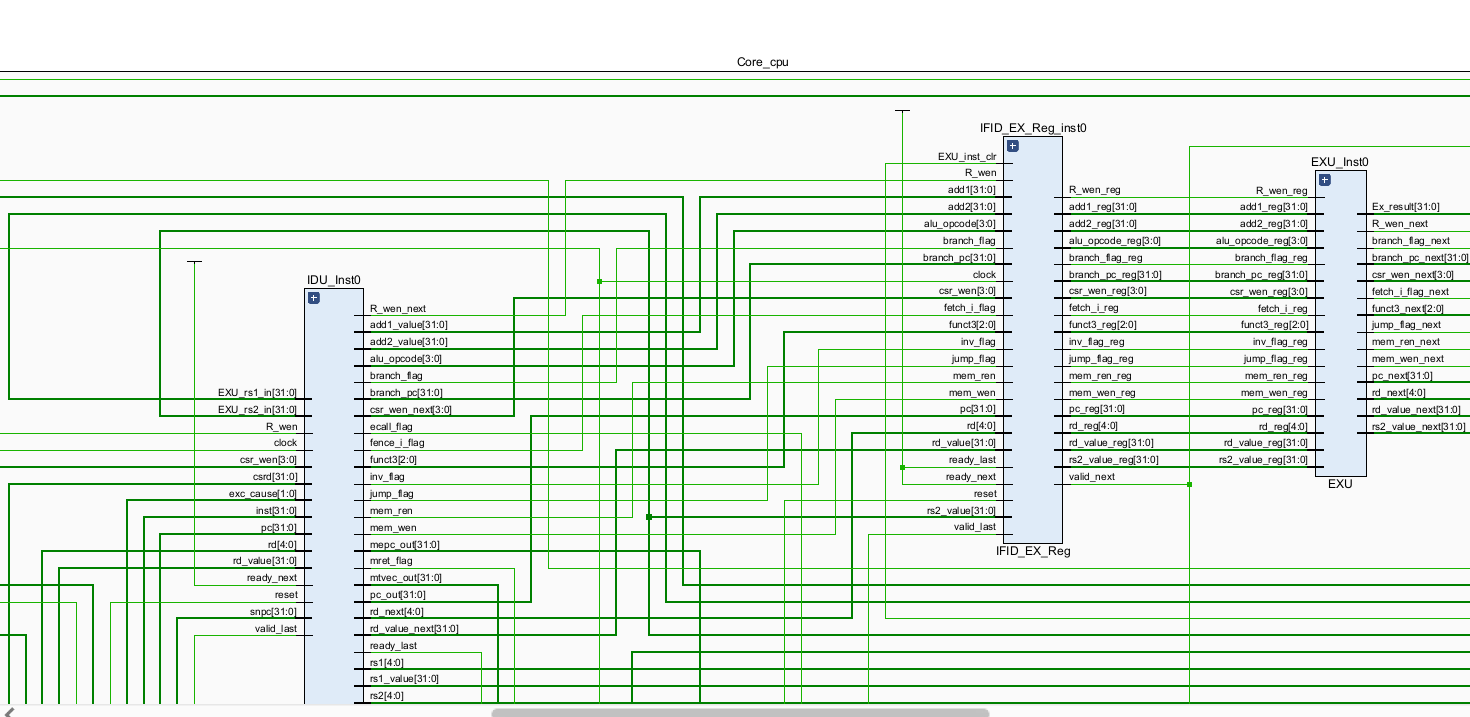
[picture p8: figure]

图 11-2　IDU_inst0 → IFID_EX_Reg_inst0 → EXU_inst0 三块并排，每根线上都有名字

这张图就是"交接"的实物照片：左边 IDU_inst0 算好的 add1_value[31:0] 接进中间那道墙，墙的右边出来变成 add1_reg[31:0] 送进 EXU_inst0。名字从 _value 变成 _reg，就是"过了一道墙"的标志。

### 4.3 控制信号的交接

IDU.R_wen_next ─→ IFID_EX_Reg.R_wen_reg ─→ EXU.R_wen_next ─→ EX_LSWB_Reg.R_wen_reg ─→ WBU.R_wen_next ─→ RegisterFile.wen

同一条 R_wen 要在四级里传下去，每一级都改一次名（_next → _reg）。为什么要这样？因为每一级都可能把它清掉（比如分支冲刷时墙里的 valid 变 0，WBU 里 R_wen & valid 就变成 0）。

## 五、五个工位各自的一句总结

工位 | 一句话 | 它交给下一级什么
IF | 按 PC 取指令 | 32 位指令 + 当前 PC
ID | 把机器码翻译成"要干什么" | 操作数 + 控制信号 + 立即数
EX | 算一个值，判一个分支 | 结果 + 分支成不成立
MEM | 访存（只有 load/store 真干活） | 读回的数或直通的结果
WB | 三选一选写回值，写寄存器堆 | 无（结果落到寄存器堆）

## 六、为什么这五段这么分

分段的唯一标准是让五段的工作量差不多，否则最慢的那段会拖死整条线（木桶效应）。

段 | 主要工作量 | 关键路径
IF | 地址加法 + IROM 读出 | 短（IROM 是 BRAM，读出快）
ID | 译码 + 读寄存器堆 + 算分支目标 | 中
EX | ALU 32 位加法 | 最长（进位链）
MEM | 地址比较 + 存储器访问 | 中
WB | 三选一 MUX + 写寄存器堆 | 短

本工程的时序报告印证了这一点：三版位流的 Fmax 分别是 75.34 / 110.10 / 130.84 MHz，最差的那版 slack 只有 +0.357 ns——瓶颈都在 EX 级的 32 位加法器上。想提频率，最有效的办法是把 EX 级再切一刀（比如把 ALU 拆成两级），变成六级流水。

## 七、回到板子

整台机器的物理链条：

晶振 ─→ clk ─→ [CPU 五级流水] ─→ ms_value ─→ 串口发送器 ─→ uart_tx 引脚 ─→ CH340 ─→ PC 串口

│

└─→ perip_bridge ─→ 数码管 / LED / DRAM

CPU 只负责"算"，"把数送出去"是 counter + ms_uart_tx 的事。两者通过总线上的两个地址相连——这就是第 9 章讲的那两个魔数。

## 自测

1. 五条指令连着跑，第 3 拍时流水线里各有几条指令在哪个工位？

2. addi x1,x1,1 和 lw x2,0(x1) 连着写，为什么要停一拍？停在哪一拍？

3. 如果想把 Fmax 从 130 MHz 提到 160 MHz，最该动哪一级？

# 第 12 章 总结：24 条指令、五个工位、两个数字

## 一、这座 CPU 到底做了什么

项目 | 数字
支持的整数指令 | 24 条（竞赛要求全集）
源码文件 | 27 个 .sv / .v
代码规模 | 约 66 KB
流水级数 | 5 级
触发器 | 1687 个（其中 297 个是流水寄存器）
LUT | 3119 个
BRAM | 64 个 BRAM36
位流大小 | 3,333,784 字节
最高频率 | 130.84 MHz（最好那版）
CPI（真实固件） | 1.073

## 二、24 条指令是怎么实现的

类别 | 指令 | 用到的工位 | 关键实现点
寄存器运算（8） | add/sub/and/or/xor/sll/srl/sra | ID→EX→WB | ALU 一个模块；sub 靠取反加一
立即数运算（7） | addi/andi/ori/xori/slli/srli/srai | ID→EX→WB | 立即数符号扩展后进 ALU
访存（2） | lw/sw | ID→EX→MEM→WB | LSU 出地址掩码；DRAM 时序读
条件分支（4） | beq/bne/blt/bge | ID→EX→IF | ALU 算比较位；inv_flag 翻 bit0
装入与跳转（3） | lui/jal/jalr | ID→EX→WB | lui 用 ALU 的 A 口接 0；跳转在 EX 级算目标

共同点：所有指令都走"取指 → 译码"，然后在 EX 级分岔——算数去 ALU，访存去 LSU，分支去 Control。分岔靠的是 IDU 输出的那五类控制信号。

## 三、要改指令，改哪几行

### 例 1：加一条 slti（立即数比较取小）

改哪里 | 改成什么
cpu_ALU.sv:23-33 | 加 define alu_slti 4'b1011
cpu_ALU.sv:95-110 | case 里加 alu_slti: result = signed_lt;
cpu_IDU.sv 的 alu_opcode 三目链 | opcode == addi && funct3 == 010 时给 alu_slti

三步，不动流水线、不动存储器。

### 例 2：加一个自定义指令 max rd, rs1, rs2

改哪里 | 改成什么
选一个没用过的 opcode | 比如 7'b0001011
cpu_IDU.sv | R_wen_next 加这个 opcode；alu_opcode 给新码
cpu_ALU.sv | case 里加 result = (signed_lt) ? d2 : d1;

⚠️ 改 opcode 表时必须同步改反汇编器（tools 目录里的脚本），否则看波形时指令显示成 unknown。

### 例 3：把流水线从 5 级改成 6 级

改哪里 | 改成什么
新增一道墙 | 把 ALU 拆成"加法"和"结果选择"两段
所有 valid 链路 | 多传一级
分支冲刷逻辑 | 多冲一条
前递路径 | 多一个来源

这是大改：面积 +15%，频率 +20% 左右，但 CPI 会略微变差（更多冲刷）。

## 四、五个最容易踩的坑

坑 | 症状 | 教训
equal = (d1 != d2) 是"不相等" | 分支全反 | 看名字不够，要看表达式
忘了清 R_wen 只清数据 | 寄存器莫名变 0 | valid 必须参与写回判断
DRAM 时序读当组合读用 | 736 拍后跑飞 | 存储器模型的行为要和注释一致
时钟按 50 MHz 算，实际 27 MHz | 时间少报 46% | 上板第一件事是核对晶振
小回归全过就以为对了 | 真实固件一跑就崩 | 测试要覆盖时序边界

## 五、怎么继续往下做

1. 测频率：用 Vivado 的 Report Timing 看 slack，找关键路径，从 EX 级下手。

2. 加缓存：一级指令 cache 能显著提升取指带宽（本工程 IROM 是 BRAM，已经很快）。

3. 加中断：irq_* 线已经引到顶层，接上 CSR 的 mip/mie 就能用。

4. 跑更大的程序：把 IROM 从 16 KB 扩到 64 KB，改 pc[13:2] 为 pc[15:2]。

5. 上竞赛板：器件换成 xc7k325tffg900-2，改 kosmo_pins.xdc 里的引脚约束。

## 六、一句话记住这本书

PC 从 IFU 出来，进 IROM 换成指令；指令过一道墙到 IDU，被拆成五类信号；再过一道墙到 EXU，ALU 算出结果；再走 LSU 和 WBU，最后写回寄存器堆。五段同时干活，就是五级流水。

## 附录 A 27 个源文件清单

文件 | 大小 | 模块 | 工位
cpu_add.sv | 1,517 | add | EX
cpu_ALU.sv | 6,771 | ALU | EX
cpu_EXU.sv | 6,272 | EXU | EX
cpu_Reg.sv | 1,257 | Reg | 流水寄存器
cpu_IFID_EX_Reg.sv | 8,599 | IFID_EX_Reg | 流水寄存器
cpu_EX_LSWB_Reg.sv | 8,030 | EX_LSWB_Reg | 流水寄存器
cpu_IDU.sv | 18,861 | IDU | ID
cpu_RegisterFile.sv | 4,357 | RegisterFile | ID/WB
cpu_Control.sv | 10,324 | Control | 全局
cpu_Data_hazard.sv | 3,858 | Data_hazard | 全局
cpu_CSR.sv | 4,962 | CSR | ID
cpu_IFU.sv | 6,296 | IFU | IF
cpu_LSU.sv | 6,825 | LSU | MEM
cpu_WBU.sv | 6,300 | WBU | WB
cpu_myCPU.sv | 25,318 | myCPU | 整机
cpu_para.sv | 2,033 | 参数/宏 | —
cpu_sext.sv | 1,149 | sext | ID
cpu_Reg_Stack.sv | 5,022 | Reg_Stack | ID
IROM.v | 85,758 | IROM | 存储器
DRAM.v | 616 | DRAM | 存储器
dram_driver.sv | 5,506 | dram_driver | 外设
perip_bridge.sv | 8,112 | perip_bridge | 外设
counter.sv | 4,317 | counter | 外设
uart.sv | 8,238 | uart | 外设
seg7.sv | 2,432 | seg7 | 外设
display_seg.sv | 3,558 | display_seg | 外设
top.v | 13,525 | top、ms_uart_tx | 板级

## 附录 B 端口速查

模块 | 主要输入 | 主要输出
IFU | dnpc、dnpc_flag、irom_data、stall | pc、inst、snpc、ifault
IDU | inst、pc、rd_value、EXU_rs1_in、EXU_rs2_in | alu_opcode、add1_value、add2_value、R_wen_next、branch_pc
Control | opcode、branch_taken、exc_trap | dnpc、dnpc_flag、stall
EXU | add1_reg、add2_reg、alu_opcode_reg | Ex_result、各 _next
LSU | Ex_result_reg、rs2_value_reg、funct3_reg | addr、wdata、mask、LSU_Rdata
WBU | LSU_Rdata、Ex_result、rd_value_reg | rd_value_next、R_wen_next

## 附录 C 术语表

术语 | 解释
PC | 程序计数器，存下一条指令地址
拍 | 一个时钟周期
CPI | 每条指令平均花几拍（理想 1.0）
前递 / 旁路 | 不等写回，直接从流水线中间取数
停顿 | 数据还没准备好，流水线停一拍
冲刷 | 分支跳走，把已经取错的指令作废
关键路径 | 两个触发器之间最长的那条组合路径，决定 Fmax
slack | 时序余量，正数表示满足时序
位流 | 综合布线后生成、可烧进 FPGA 的文件
x0 | 恒为 0 的寄存器，写入无效

Kosmo2 RISC-V 五级流水 CPU 教材
