ZhangXin555/kosmo-riscv/constrs/kosmo_pins.xdc

# Kosmo2 / PG2K100 pin map (from kosmo_pins.fdc)
# NOTE: Vivado has no PG2K100 device; PACKAGE_PIN values are for reference only.
# Only ports that actually exist in top.v are constrained here.
set_property PACKAGE_PIN T9  [get_ports {clk}]
set_property IOSTANDARD LVCMOS33 [get_ports {clk}]
set_property PACKAGE_PIN G14 [get_ports {led[0]}]
set_property IOSTANDARD LVCMOS33 [get_ports {led[0]}]
set_property PACKAGE_PIN E18 [get_ports {led[1]}]
set_property IOSTANDARD LVCMOS33 [get_ports {led[1]}]
set_property PACKAGE_PIN E19 [get_ports {led[2]}]
set_property IOSTANDARD LVCMOS33 [get_ports {led[2]}]
set_property PACKAGE_PIN F16 [get_ports {led[3]}]
set_property IOSTANDARD LVCMOS33 [get_ports {led[3]}]
set_property PACKAGE_PIN F17 [get_ports {led[4]}]
set_property IOSTANDARD LVCMOS33 [get_ports {led[4]}]
set_property PACKAGE_PIN H18 [get_ports {led[5]}]
set_property IOSTANDARD LVCMOS33 [get_ports {led[5]}]
set_property PACKAGE_PIN E17 [get_ports {led[6]}]
set_property IOSTANDARD LVCMOS33 [get_ports {led[6]}]
set_property PACKAGE_PIN H15 [get_ports {led[7]}]
set_property IOSTANDARD LVCMOS33 [get_ports {led[7]}]
set_property PACKAGE_PIN W13 [get_ports {rst_n}]
set_property IOSTANDARD LVCMOS33 [get_ports {rst_n}]
set_property PACKAGE_PIN W6  [get_ports {uart_tx}]
set_property IOSTANDARD LVCMOS33 [get_ports {uart_tx}]
create_clock -name clk -period 20.000 [get_ports {clk}]
