ZhangXin555/kosmo-riscv/rtl/IROM.v

`timescale 1ns/1ps

// IROM: 4096 x 32, generated from coe/src0/irom.coe (case ROM, no IP)
module IROM(
    input  wire [11:0] a,
    output reg  [31:0] spo
);
    always @(*) begin
        case (a)
            12'h000: spo = 32'h0013d117;
            12'h001: spo = 32'h24410113;
            12'h002: spo = 32'h16c010ef;
            12'h003: spo = 32'h7a5000ef;
            12'h004: spo = 32'h0000006f;
            12'h005: spo = 32'hff010113;
            12'h006: spo = 32'h00112623;
            12'h007: spo = 32'h00812423;
            12'h008: spo = 32'h01010413;
            12'h009: spo = 32'h802007b7;
            12'h00a: spo = 32'h0007a783;
            12'h00b: spo = 32'h00078513;
            12'h00c: spo = 32'h00c12083;
            12'h00d: spo = 32'h00812403;
            12'h00e: spo = 32'h01010113;
            12'h00f: spo = 32'h00008067;
            12'h010: spo = 32'hff010113;
            12'h011: spo = 32'h00112623;
            12'h012: spo = 32'h00812423;
            12'h013: spo = 32'h01010413;
            12'h014: spo = 32'h802007b7;
            12'h015: spo = 32'h00478793;
            12'h016: spo = 32'h0007a783;
            12'h017: spo = 32'h00078513;
            12'h018: spo = 32'h00c12083;
            12'h019: spo = 32'h00812403;
            12'h01a: spo = 32'h01010113;
            12'h01b: spo = 32'h00008067;
            12'h01c: spo = 32'hfd010113;
            12'h01d: spo = 32'h02112623;
            12'h01e: spo = 32'h02812423;
            12'h01f: spo = 32'h03010413;
            12'h020: spo = 32'hfca42e23;
            12'h021: spo = 32'hfe042623;
            12'h022: spo = 32'hfe042423;
            12'h023: spo = 32'h0580006f;
            12'h024: spo = 32'hfdc42783;
            12'h025: spo = 32'h00a00593;
            12'h026: spo = 32'h00078513;
            12'h027: spo = 32'h6a9010ef;
            12'h028: spo = 32'h00050793;
            12'h029: spo = 32'hfef42223;
            12'h02a: spo = 32'hfe842783;
            12'h02b: spo = 32'hfe442703;
            12'h02c: spo = 32'h00f717b3;
            12'h02d: spo = 32'hfec42703;
            12'h02e: spo = 32'h00f767b3;
            12'h02f: spo = 32'hfef42623;
            12'h030: spo = 32'hfdc42783;
            12'h031: spo = 32'h00a00593;
            12'h032: spo = 32'h00078513;
            12'h033: spo = 32'h631010ef;
            12'h034: spo = 32'h00050793;
            12'h035: spo = 32'hfcf42e23;
            12'h036: spo = 32'hfe842783;
            12'h037: spo = 32'h00478793;
            12'h038: spo = 32'hfef42423;
            12'h039: spo = 32'hfdc42783;
            12'h03a: spo = 32'hfa0794e3;
            12'h03b: spo = 32'hfec42783;
            12'h03c: spo = 32'h00078513;
            12'h03d: spo = 32'h02c12083;
            12'h03e: spo = 32'h02812403;
            12'h03f: spo = 32'h03010113;
            12'h040: spo = 32'h00008067;
            12'h041: spo = 32'hfe010113;
            12'h042: spo = 32'h00112e23;
            12'h043: spo = 32'h00812c23;
            12'h044: spo = 32'h02010413;
            12'h045: spo = 32'h801007b7;
            12'h046: spo = 32'h0007a783;
            12'h047: spo = 32'h00078513;
            12'h048: spo = 32'hf51ff0ef;
            12'h049: spo = 32'hfea42623;
            12'h04a: spo = 32'h802007b7;
            12'h04b: spo = 32'h02078793;
            12'h04c: spo = 32'hfec42703;
            12'h04d: spo = 32'h01871713;
            12'h04e: spo = 32'h00e7a023;
            12'h04f: spo = 32'h00000013;
            12'h050: spo = 32'h01c12083;
            12'h051: spo = 32'h01812403;
            12'h052: spo = 32'h02010113;
            12'h053: spo = 32'h00008067;
            12'h054: spo = 32'hfd010113;
            12'h055: spo = 32'h02112623;
            12'h056: spo = 32'h02812423;
            12'h057: spo = 32'h03010413;
            12'h058: spo = 32'hfca42e23;
            12'h059: spo = 32'hfdc42503;
            12'h05a: spo = 32'hf09ff0ef;
            12'h05b: spo = 32'h00050713;
            12'h05c: spo = 32'h010007b7;
            12'h05d: spo = 32'hfff78793;
            12'h05e: spo = 32'h00f777b3;
            12'h05f: spo = 32'hfef42623;
            12'h060: spo = 32'h802007b7;
            12'h061: spo = 32'h02078793;
            12'h062: spo = 32'h0007a683;
            12'h063: spo = 32'h802007b7;
            12'h064: spo = 32'h02078793;
            12'h065: spo = 32'hfec42703;
            12'h066: spo = 32'h00e6e733;
            12'h067: spo = 32'h00e7a023;
            12'h068: spo = 32'h00000013;
            12'h069: spo = 32'h02c12083;
            12'h06a: spo = 32'h02812403;
            12'h06b: spo = 32'h03010113;
            12'h06c: spo = 32'h00008067;
            12'h06d: spo = 32'hfe010113;
            12'h06e: spo = 32'h00112e23;
            12'h06f: spo = 32'h00812c23;
            12'h070: spo = 32'h02010413;
            12'h071: spo = 32'hfea42623;
            12'h072: spo = 32'h802007b7;
            12'h073: spo = 32'h04078793;
            12'h074: spo = 32'hfec42703;
            12'h075: spo = 32'h00e7a023;
            12'h076: spo = 32'h00000013;
            12'h077: spo = 32'h01c12083;
            12'h078: spo = 32'h01812403;
            12'h079: spo = 32'h02010113;
            12'h07a: spo = 32'h00008067;
            12'h07b: spo = 32'hfe010113;
            12'h07c: spo = 32'h00112e23;
            12'h07d: spo = 32'h00812c23;
            12'h07e: spo = 32'h02010413;
            12'h07f: spo = 32'hfe042623;
            12'h080: spo = 32'hfec42703;
            12'h081: spo = 32'h010007b7;
            12'h082: spo = 32'h00f767b3;
            12'h083: spo = 32'hfef42623;
            12'h084: spo = 32'hfec42703;
            12'h085: spo = 32'h000207b7;
            12'h086: spo = 32'h00f767b3;
            12'h087: spo = 32'hfef42623;
            12'h088: spo = 32'hfec42703;
            12'h089: spo = 32'h000017b7;
            12'h08a: spo = 32'h80078793;
            12'h08b: spo = 32'h00f767b3;
            12'h08c: spo = 32'hfef42623;
            12'h08d: spo = 32'hfec42783;
            12'h08e: spo = 32'h4007e793;
            12'h08f: spo = 32'hfef42623;
            12'h090: spo = 32'hfec42783;
            12'h091: spo = 32'h0087e793;
            12'h092: spo = 32'hfef42623;
            12'h093: spo = 32'hfec42703;
            12'h094: spo = 32'h000017b7;
            12'h095: spo = 32'h00f767b3;
            12'h096: spo = 32'hfef42623;
            12'h097: spo = 32'hfec42703;
            12'h098: spo = 32'h002007b7;
            12'h099: spo = 32'h00f767b3;
            12'h09a: spo = 32'hfef42623;
            12'h09b: spo = 32'hfec42503;
            12'h09c: spo = 32'hf45ff0ef;
            12'h09d: spo = 32'h00000013;
            12'h09e: spo = 32'h01c12083;
            12'h09f: spo = 32'h01812403;
            12'h0a0: spo = 32'h02010113;
            12'h0a1: spo = 32'h00008067;
            12'h0a2: spo = 32'hfe010113;
            12'h0a3: spo = 32'h00112e23;
            12'h0a4: spo = 32'h00812c23;
            12'h0a5: spo = 32'h02010413;
            12'h0a6: spo = 32'hfe042623;
            12'h0a7: spo = 32'hfec42783;
            12'h0a8: spo = 32'h0207e793;
            12'h0a9: spo = 32'hfef42623;
            12'h0aa: spo = 32'hfec42703;
            12'h0ab: spo = 32'h000017b7;
            12'h0ac: spo = 32'h00f767b3;
            12'h0ad: spo = 32'hfef42623;
            12'h0ae: spo = 32'hfec42703;
            12'h0af: spo = 32'h000807b7;
            12'h0b0: spo = 32'h00f767b3;
            12'h0b1: spo = 32'hfef42623;
            12'h0b2: spo = 32'hfec42703;
            12'h0b3: spo = 32'h040007b7;
            12'h0b4: spo = 32'h00f767b3;
            12'h0b5: spo = 32'hfef42623;
            12'h0b6: spo = 32'hfec42783;
            12'h0b7: spo = 32'h0047e793;
            12'h0b8: spo = 32'hfef42623;
            12'h0b9: spo = 32'hfec42703;
            12'h0ba: spo = 32'h000017b7;
            12'h0bb: spo = 32'h80078793;
            12'h0bc: spo = 32'h00f767b3;
            12'h0bd: spo = 32'hfef42623;
            12'h0be: spo = 32'hfec42703;
            12'h0bf: spo = 32'h001007b7;
            12'h0c0: spo = 32'h00f767b3;
            12'h0c1: spo = 32'hfef42623;
            12'h0c2: spo = 32'hfec42703;
            12'h0c3: spo = 32'h200007b7;
            12'h0c4: spo = 32'h00f767b3;
            12'h0c5: spo = 32'hfef42623;
            12'h0c6: spo = 32'hfec42503;
            12'h0c7: spo = 32'he99ff0ef;
            12'h0c8: spo = 32'h00000013;
            12'h0c9: spo = 32'h01c12083;
            12'h0ca: spo = 32'h01812403;
            12'h0cb: spo = 32'h02010113;
            12'h0cc: spo = 32'h00008067;
            12'h0cd: spo = 32'hfe010113;
            12'h0ce: spo = 32'h00112e23;
            12'h0cf: spo = 32'h00812c23;
            12'h0d0: spo = 32'h02010413;
            12'h0d1: spo = 32'hfe042623;
            12'h0d2: spo = 32'h0200006f;
            12'h0d3: spo = 32'h802007b7;
            12'h0d4: spo = 32'h05078793;
            12'h0d5: spo = 32'h80000737;
            12'h0d6: spo = 32'h00e7a023;
            12'h0d7: spo = 32'hfec42783;
            12'h0d8: spo = 32'h00178793;
            12'h0d9: spo = 32'hfef42623;
            12'h0da: spo = 32'hfec42703;
            12'h0db: spo = 32'h00900793;
            12'h0dc: spo = 32'hfce7dee3;
            12'h0dd: spo = 32'h00000013;
            12'h0de: spo = 32'h00000013;
            12'h0df: spo = 32'h01c12083;
            12'h0e0: spo = 32'h01812403;
            12'h0e1: spo = 32'h02010113;
            12'h0e2: spo = 32'h00008067;
            12'h0e3: spo = 32'hfe010113;
            12'h0e4: spo = 32'h00112e23;
            12'h0e5: spo = 32'h00812c23;
            12'h0e6: spo = 32'h02010413;
            12'h0e7: spo = 32'hfe042623;
            12'h0e8: spo = 32'h0200006f;
            12'h0e9: spo = 32'h802007b7;
            12'h0ea: spo = 32'h05078793;
            12'h0eb: spo = 32'hfff00713;
            12'h0ec: spo = 32'h00e7a023;
            12'h0ed: spo = 32'hfec42783;
            12'h0ee: spo = 32'h00178793;
            12'h0ef: spo = 32'hfef42623;
            12'h0f0: spo = 32'hfec42703;
            12'h0f1: spo = 32'h00900793;
            12'h0f2: spo = 32'hfce7dee3;
            12'h0f3: spo = 32'h00000013;
            12'h0f4: spo = 32'h00000013;
            12'h0f5: spo = 32'h01c12083;
            12'h0f6: spo = 32'h01812403;
            12'h0f7: spo = 32'h02010113;
            12'h0f8: spo = 32'h00008067;
            12'h0f9: spo = 32'hff010113;
            12'h0fa: spo = 32'h00112623;
            12'h0fb: spo = 32'h00812423;
            12'h0fc: spo = 32'h01010413;
            12'h0fd: spo = 32'h802007b7;
            12'h0fe: spo = 32'h05078793;
            12'h0ff: spo = 32'h0007a783;
            12'h100: spo = 32'h00078513;
            12'h101: spo = 32'h00c12083;
            12'h102: spo = 32'h00812403;
            12'h103: spo = 32'h01010113;
            12'h104: spo = 32'h00008067;
            12'h105: spo = 32'hfd010113;
            12'h106: spo = 32'h02112623;
            12'h107: spo = 32'h02812423;
            12'h108: spo = 32'h03010413;
            12'h109: spo = 32'hfca42e23;
            12'h10a: spo = 32'hfcb42c23;
            12'h10b: spo = 32'hfcc42a23;
            12'h10c: spo = 32'hfe042623;
            12'h10d: spo = 32'h1200006f;
            12'h10e: spo = 32'hfe042423;
            12'h10f: spo = 32'h1000006f;
            12'h110: spo = 32'hfe042023;
            12'h111: spo = 32'hfe042223;
            12'h112: spo = 32'h0a00006f;
            12'h113: spo = 32'hfec42703;
            12'h114: spo = 32'h00070793;
            12'h115: spo = 32'h00179793;
            12'h116: spo = 32'h00e787b3;
            12'h117: spo = 32'h00479713;
            12'h118: spo = 32'h40f70733;
            12'h119: spo = 32'h00371793;
            12'h11a: spo = 32'h00078713;
            12'h11b: spo = 32'hfdc42783;
            12'h11c: spo = 32'h00e78733;
            12'h11d: spo = 32'hfe442783;
            12'h11e: spo = 32'h00279793;
            12'h11f: spo = 32'h00f707b3;
            12'h120: spo = 32'h0007a683;
            12'h121: spo = 32'hfe442703;
            12'h122: spo = 32'h00070793;
            12'h123: spo = 32'h00179793;
            12'h124: spo = 32'h00e787b3;
            12'h125: spo = 32'h00479713;
            12'h126: spo = 32'h40f70733;
            12'h127: spo = 32'h00371793;
            12'h128: spo = 32'h00078713;
            12'h129: spo = 32'hfd842783;
            12'h12a: spo = 32'h00e78733;
            12'h12b: spo = 32'hfe842783;
            12'h12c: spo = 32'h00279793;
            12'h12d: spo = 32'h00f707b3;
            12'h12e: spo = 32'h0007a783;
            12'h12f: spo = 32'h00078593;
            12'h130: spo = 32'h00068513;
            12'h131: spo = 32'h2e5010ef;
            12'h132: spo = 32'h00050793;
            12'h133: spo = 32'h00078713;
            12'h134: spo = 32'hfe042783;
            12'h135: spo = 32'h00e787b3;
            12'h136: spo = 32'hfef42023;
            12'h137: spo = 32'hfe442783;
            12'h138: spo = 32'h00178793;
            12'h139: spo = 32'hfef42223;
            12'h13a: spo = 32'hfe442703;
            12'h13b: spo = 32'h05900793;
            12'h13c: spo = 32'hf4e7dee3;
            12'h13d: spo = 32'hfec42703;
            12'h13e: spo = 32'h00070793;
            12'h13f: spo = 32'h00179793;
            12'h140: spo = 32'h00e787b3;
            12'h141: spo = 32'h00479713;
            12'h142: spo = 32'h40f70733;
            12'h143: spo = 32'h00371793;
            12'h144: spo = 32'h00078713;
            12'h145: spo = 32'hfd442783;
            12'h146: spo = 32'h00e78733;
            12'h147: spo = 32'hfe842783;
            12'h148: spo = 32'h00279793;
            12'h149: spo = 32'h00f707b3;
            12'h14a: spo = 32'hfe042703;
            12'h14b: spo = 32'h00e7a023;
            12'h14c: spo = 32'hfe842783;
            12'h14d: spo = 32'h00178793;
            12'h14e: spo = 32'hfef42423;
            12'h14f: spo = 32'hfe842703;
            12'h150: spo = 32'h05900793;
            12'h151: spo = 32'heee7dee3;
            12'h152: spo = 32'hfec42783;
            12'h153: spo = 32'h00178793;
            12'h154: spo = 32'hfef42623;
            12'h155: spo = 32'hfec42703;
            12'h156: spo = 32'h05900793;
            12'h157: spo = 32'hece7dee3;
            12'h158: spo = 32'h00000013;
            12'h159: spo = 32'h00000013;
            12'h15a: spo = 32'h02c12083;
            12'h15b: spo = 32'h02812403;
            12'h15c: spo = 32'h03010113;
            12'h15d: spo = 32'h00008067;
            12'h15e: spo = 32'h81010113;
            12'h15f: spo = 32'h7e112623;
            12'h160: spo = 32'h7e812423;
            12'h161: spo = 32'h7f010413;
            12'h162: spo = 32'hffff92b7;
            12'h163: spo = 32'h93028293;
            12'h164: spo = 32'h00510133;
            12'h165: spo = 32'hffff87b7;
            12'h166: spo = 32'hff078793;
            12'h167: spo = 32'h008787b3;
            12'h168: spo = 32'h14a7ae23;
            12'h169: spo = 32'hffff87b7;
            12'h16a: spo = 32'hff078793;
            12'h16b: spo = 32'h008787b3;
            12'h16c: spo = 32'h14b7ac23;
            12'h16d: spo = 32'hffff87b7;
            12'h16e: spo = 32'hff078793;
            12'h16f: spo = 32'h008787b3;
            12'h170: spo = 32'h14c7aa23;
            12'h171: spo = 32'hfe042623;
            12'h172: spo = 32'h0b40006f;
            12'h173: spo = 32'hfe042423;
            12'h174: spo = 32'h0940006f;
            12'h175: spo = 32'hfec42703;
            12'h176: spo = 32'h00070793;
            12'h177: spo = 32'h00179793;
            12'h178: spo = 32'h00e787b3;
            12'h179: spo = 32'h00479713;
            12'h17a: spo = 32'h40f70733;
            12'h17b: spo = 32'h00371793;
            12'h17c: spo = 32'h00078713;
            12'h17d: spo = 32'hffff87b7;
            12'h17e: spo = 32'hff078793;
            12'h17f: spo = 32'h008787b3;
            12'h180: spo = 32'h1587a783;
            12'h181: spo = 32'h00e78733;
            12'h182: spo = 32'hfe842783;
            12'h183: spo = 32'h00279793;
            12'h184: spo = 32'h00f707b3;
            12'h185: spo = 32'h0007a683;
            12'h186: spo = 32'hffff87b7;
            12'h187: spo = 32'hff078793;
            12'h188: spo = 32'h00878633;
            12'h189: spo = 32'hfe842703;
            12'h18a: spo = 32'h00070793;
            12'h18b: spo = 32'h00179793;
            12'h18c: spo = 32'h00e787b3;
            12'h18d: spo = 32'h00479713;
            12'h18e: spo = 32'h40f70733;
            12'h18f: spo = 32'h00171793;
            12'h190: spo = 32'h00078713;
            12'h191: spo = 32'hfec42783;
            12'h192: spo = 32'h00f707b3;
            12'h193: spo = 32'h00279793;
            12'h194: spo = 32'h00f607b3;
            12'h195: spo = 32'h16d7a023;
            12'h196: spo = 32'hfe842783;
            12'h197: spo = 32'h00178793;
            12'h198: spo = 32'hfef42423;
            12'h199: spo = 32'hfe842703;
            12'h19a: spo = 32'h05900793;
            12'h19b: spo = 32'hf6e7d4e3;
            12'h19c: spo = 32'hfec42783;
            12'h19d: spo = 32'h00178793;
            12'h19e: spo = 32'hfef42623;
            12'h19f: spo = 32'hfec42703;
            12'h1a0: spo = 32'h05900793;
            12'h1a1: spo = 32'hf4e7d4e3;
            12'h1a2: spo = 32'hfe042623;
            12'h1a3: spo = 32'h1400006f;
            12'h1a4: spo = 32'hfe042423;
            12'h1a5: spo = 32'h1200006f;
            12'h1a6: spo = 32'hfe042023;
            12'h1a7: spo = 32'hfe042223;
            12'h1a8: spo = 32'h0b40006f;
            12'h1a9: spo = 32'hfec42703;
            12'h1aa: spo = 32'h00070793;
            12'h1ab: spo = 32'h00179793;
            12'h1ac: spo = 32'h00e787b3;
            12'h1ad: spo = 32'h00479713;
            12'h1ae: spo = 32'h40f70733;
            12'h1af: spo = 32'h00371793;
            12'h1b0: spo = 32'h00078713;
            12'h1b1: spo = 32'hffff87b7;
            12'h1b2: spo = 32'hff078793;
            12'h1b3: spo = 32'h008787b3;
            12'h1b4: spo = 32'h15c7a783;
            12'h1b5: spo = 32'h00e78733;
            12'h1b6: spo = 32'hfe442783;
            12'h1b7: spo = 32'h00279793;
            12'h1b8: spo = 32'h00f707b3;
            12'h1b9: spo = 32'h0007a603;
            12'h1ba: spo = 32'hffff87b7;
            12'h1bb: spo = 32'hff078793;
            12'h1bc: spo = 32'h008786b3;
            12'h1bd: spo = 32'hfe842703;
            12'h1be: spo = 32'h00070793;
            12'h1bf: spo = 32'h00179793;
            12'h1c0: spo = 32'h00e787b3;
            12'h1c1: spo = 32'h00479713;
            12'h1c2: spo = 32'h40f70733;
            12'h1c3: spo = 32'h00171793;
            12'h1c4: spo = 32'h00078713;
            12'h1c5: spo = 32'hfe442783;
            12'h1c6: spo = 32'h00f707b3;
            12'h1c7: spo = 32'h00279793;
            12'h1c8: spo = 32'h00f687b3;
            12'h1c9: spo = 32'h1607a783;
            12'h1ca: spo = 32'h00078593;
            12'h1cb: spo = 32'h00060513;
            12'h1cc: spo = 32'h079010ef;
            12'h1cd: spo = 32'h00050793;
            12'h1ce: spo = 32'h00078713;
            12'h1cf: spo = 32'hfe042783;
            12'h1d0: spo = 32'h00e787b3;
            12'h1d1: spo = 32'hfef42023;
            12'h1d2: spo = 32'hfe442783;
            12'h1d3: spo = 32'h00178793;
            12'h1d4: spo = 32'hfef42223;
            12'h1d5: spo = 32'hfe442703;
            12'h1d6: spo = 32'h05900793;
            12'h1d7: spo = 32'hf4e7d4e3;
            12'h1d8: spo = 32'hfec42703;
            12'h1d9: spo = 32'h00070793;
            12'h1da: spo = 32'h00179793;
            12'h1db: spo = 32'h00e787b3;
            12'h1dc: spo = 32'h00479713;
            12'h1dd: spo = 32'h40f70733;
            12'h1de: spo = 32'h00371793;
            12'h1df: spo = 32'h00078713;
            12'h1e0: spo = 32'hffff87b7;
            12'h1e1: spo = 32'hff078793;
            12'h1e2: spo = 32'h008787b3;
            12'h1e3: spo = 32'h1547a783;
            12'h1e4: spo = 32'h00e78733;
            12'h1e5: spo = 32'hfe842783;
            12'h1e6: spo = 32'h00279793;
            12'h1e7: spo = 32'h00f707b3;
            12'h1e8: spo = 32'hfe042703;
            12'h1e9: spo = 32'h00e7a023;
            12'h1ea: spo = 32'hfe842783;
            12'h1eb: spo = 32'h00178793;
            12'h1ec: spo = 32'hfef42423;
            12'h1ed: spo = 32'hfe842703;
            12'h1ee: spo = 32'h05900793;
            12'h1ef: spo = 32'hece7dee3;
            12'h1f0: spo = 32'hfec42783;
            12'h1f1: spo = 32'h00178793;
            12'h1f2: spo = 32'hfef42623;
            12'h1f3: spo = 32'hfec42703;
            12'h1f4: spo = 32'h05900793;
            12'h1f5: spo = 32'heae7dee3;
            12'h1f6: spo = 32'h00000013;
            12'h1f7: spo = 32'h00000013;
            12'h1f8: spo = 32'h000072b7;
            12'h1f9: spo = 32'h6d028293;
            12'h1fa: spo = 32'h00510133;
            12'h1fb: spo = 32'h7ec12083;
            12'h1fc: spo = 32'h7e812403;
            12'h1fd: spo = 32'h7f010113;
            12'h1fe: spo = 32'h00008067;
            12'h1ff: spo = 32'hfd010113;
            12'h200: spo = 32'h02112623;
            12'h201: spo = 32'h02812423;
            12'h202: spo = 32'h03010413;
            12'h203: spo = 32'hfca42e23;
            12'h204: spo = 32'hfcb42c23;
            12'h205: spo = 32'hfe042623;
            12'h206: spo = 32'h0ac0006f;
            12'h207: spo = 32'hfe042423;
            12'h208: spo = 32'h08c0006f;
            12'h209: spo = 32'hfec42703;
            12'h20a: spo = 32'h00070793;
            12'h20b: spo = 32'h00179793;
            12'h20c: spo = 32'h00e787b3;
            12'h20d: spo = 32'h00479713;
            12'h20e: spo = 32'h40f70733;
            12'h20f: spo = 32'h00371793;
            12'h210: spo = 32'h00078713;
            12'h211: spo = 32'hfdc42783;
            12'h212: spo = 32'h00e78733;
            12'h213: spo = 32'hfe842783;
            12'h214: spo = 32'h00279793;
            12'h215: spo = 32'h00f707b3;
            12'h216: spo = 32'h0007a683;
            12'h217: spo = 32'hfec42703;
            12'h218: spo = 32'h00070793;
            12'h219: spo = 32'h00179793;
            12'h21a: spo = 32'h00e787b3;
            12'h21b: spo = 32'h00479713;
            12'h21c: spo = 32'h40f70733;
            12'h21d: spo = 32'h00371793;
            12'h21e: spo = 32'h00078713;
            12'h21f: spo = 32'hfd842783;
            12'h220: spo = 32'h00e78733;
            12'h221: spo = 32'hfe842783;
            12'h222: spo = 32'h00279793;
            12'h223: spo = 32'h00f707b3;
            12'h224: spo = 32'h0007a783;
            12'h225: spo = 32'h00f68663;
            12'h226: spo = 32'h00000793;
            12'h227: spo = 32'h0380006f;
            12'h228: spo = 32'hfe842783;
            12'h229: spo = 32'h00178793;
            12'h22a: spo = 32'hfef42423;
            12'h22b: spo = 32'hfe842703;
            12'h22c: spo = 32'h05900793;
            12'h22d: spo = 32'hf6e7d8e3;
            12'h22e: spo = 32'hfec42783;
            12'h22f: spo = 32'h00178793;
            12'h230: spo = 32'hfef42623;
            12'h231: spo = 32'hfec42703;
            12'h232: spo = 32'h05900793;
            12'h233: spo = 32'hf4e7d8e3;
            12'h234: spo = 32'h00100793;
            12'h235: spo = 32'h00078513;
            12'h236: spo = 32'h02c12083;
            12'h237: spo = 32'h02812403;
            12'h238: spo = 32'h03010113;
            12'h239: spo = 32'h00008067;
            12'h23a: spo = 32'hfd010113;
            12'h23b: spo = 32'h02112623;
            12'h23c: spo = 32'h02812423;
            12'h23d: spo = 32'h02912223;
            12'h23e: spo = 32'h03010413;
            12'h23f: spo = 32'hfca42e23;
            12'h240: spo = 32'hfcb42c23;
            12'h241: spo = 32'hfe042623;
            12'h242: spo = 32'h0980006f;
            12'h243: spo = 32'hfe042423;
            12'h244: spo = 32'h0780006f;
            12'h245: spo = 32'hfe842583;
            12'h246: spo = 32'hfec42503;
            12'h247: spo = 32'h68c010ef;
            12'h248: spo = 32'h00050793;
            12'h249: spo = 32'h00078713;
            12'h24a: spo = 32'hfd842783;
            12'h24b: spo = 32'h00f706b3;
            12'h24c: spo = 32'hfec42703;
            12'h24d: spo = 32'h00070793;
            12'h24e: spo = 32'h00179793;
            12'h24f: spo = 32'h00e787b3;
            12'h250: spo = 32'h00479713;
            12'h251: spo = 32'h40f70733;
            12'h252: spo = 32'h00371793;
            12'h253: spo = 32'h00078713;
            12'h254: spo = 32'hfdc42783;
            12'h255: spo = 32'h00e784b3;
            12'h256: spo = 32'h06400593;
            12'h257: spo = 32'h00068513;
            12'h258: spo = 32'h618010ef;
            12'h259: spo = 32'h00050793;
            12'h25a: spo = 32'h00078713;
            12'h25b: spo = 32'hfe842783;
            12'h25c: spo = 32'h00279793;
            12'h25d: spo = 32'h00f487b3;
            12'h25e: spo = 32'h00e7a023;
            12'h25f: spo = 32'hfe842783;
            12'h260: spo = 32'h00178793;
            12'h261: spo = 32'hfef42423;
            12'h262: spo = 32'hfe842703;
            12'h263: spo = 32'h05900793;
            12'h264: spo = 32'hf8e7d2e3;
            12'h265: spo = 32'hfec42783;
            12'h266: spo = 32'h00178793;
            12'h267: spo = 32'hfef42623;
            12'h268: spo = 32'hfec42703;
            12'h269: spo = 32'h05900793;
            12'h26a: spo = 32'hf6e7d2e3;
            12'h26b: spo = 32'h00000013;
            12'h26c: spo = 32'h00000013;
            12'h26d: spo = 32'h02c12083;
            12'h26e: spo = 32'h02812403;
            12'h26f: spo = 32'h02412483;
            12'h270: spo = 32'h03010113;
            12'h271: spo = 32'h00008067;
            12'h272: spo = 32'hfd010113;
            12'h273: spo = 32'h02112623;
            12'h274: spo = 32'h02812423;
            12'h275: spo = 32'h03010413;
            12'h276: spo = 32'hfca42e23;
            12'h277: spo = 32'hfcb42c23;
            12'h278: spo = 32'hfe042623;
            12'h279: spo = 32'h0cc0006f;
            12'h27a: spo = 32'hfe042423;
            12'h27b: spo = 32'h0a00006f;
            12'h27c: spo = 32'hfe842783;
            12'h27d: spo = 32'h00279793;
            12'h27e: spo = 32'hfdc42703;
            12'h27f: spo = 32'h00f707b3;
            12'h280: spo = 32'h0007a703;
            12'h281: spo = 32'hfe842783;
            12'h282: spo = 32'h00178793;
            12'h283: spo = 32'h00279793;
            12'h284: spo = 32'hfdc42683;
            12'h285: spo = 32'h00f687b3;
            12'h286: spo = 32'h0007a783;
            12'h287: spo = 32'h06e7d263;
            12'h288: spo = 32'hfe842783;
            12'h289: spo = 32'h00279793;
            12'h28a: spo = 32'hfdc42703;
            12'h28b: spo = 32'h00f707b3;
            12'h28c: spo = 32'h0007a783;
            12'h28d: spo = 32'hfef42223;
            12'h28e: spo = 32'hfe842783;
            12'h28f: spo = 32'h00178793;
            12'h290: spo = 32'h00279793;
            12'h291: spo = 32'hfdc42703;
            12'h292: spo = 32'h00f70733;
            12'h293: spo = 32'hfe842783;
            12'h294: spo = 32'h00279793;
            12'h295: spo = 32'hfdc42683;
            12'h296: spo = 32'h00f687b3;
            12'h297: spo = 32'h00072703;
            12'h298: spo = 32'h00e7a023;
            12'h299: spo = 32'hfe842783;
            12'h29a: spo = 32'h00178793;
            12'h29b: spo = 32'h00279793;
            12'h29c: spo = 32'hfdc42703;
            12'h29d: spo = 32'h00f707b3;
            12'h29e: spo = 32'hfe442703;
            12'h29f: spo = 32'h00e7a023;
            12'h2a0: spo = 32'hfe842783;
            12'h2a1: spo = 32'h00178793;
            12'h2a2: spo = 32'hfef42423;
            12'h2a3: spo = 32'hfd842783;
            12'h2a4: spo = 32'hfff78713;
            12'h2a5: spo = 32'hfec42783;
            12'h2a6: spo = 32'h40f707b3;
            12'h2a7: spo = 32'hfe842703;
            12'h2a8: spo = 32'hf4f748e3;
            12'h2a9: spo = 32'hfec42783;
            12'h2aa: spo = 32'h00178793;
            12'h2ab: spo = 32'hfef42623;
            12'h2ac: spo = 32'hfd842783;
            12'h2ad: spo = 32'hfff78793;
            12'h2ae: spo = 32'hfec42703;
            12'h2af: spo = 32'hf2f746e3;
            12'h2b0: spo = 32'h00000013;
            12'h2b1: spo = 32'h00000013;
            12'h2b2: spo = 32'h02c12083;
            12'h2b3: spo = 32'h02812403;
            12'h2b4: spo = 32'h03010113;
            12'h2b5: spo = 32'h00008067;
            12'h2b6: spo = 32'hfd010113;
            12'h2b7: spo = 32'h02112623;
            12'h2b8: spo = 32'h02812423;
            12'h2b9: spo = 32'h03010413;
            12'h2ba: spo = 32'hfca42e23;
            12'h2bb: spo = 32'hfcb42c23;
            12'h2bc: spo = 32'hfe042623;
            12'h2bd: spo = 32'h0d80006f;
            12'h2be: spo = 32'hfec42783;
            12'h2bf: spo = 32'hfef42223;
            12'h2c0: spo = 32'hfec42783;
            12'h2c1: spo = 32'h00178793;
            12'h2c2: spo = 32'hfef42423;
            12'h2c3: spo = 32'h0440006f;
            12'h2c4: spo = 32'hfe842783;
            12'h2c5: spo = 32'h00279793;
            12'h2c6: spo = 32'hfdc42703;
            12'h2c7: spo = 32'h00f707b3;
            12'h2c8: spo = 32'h0007a703;
            12'h2c9: spo = 32'hfe442783;
            12'h2ca: spo = 32'h00279793;
            12'h2cb: spo = 32'hfdc42683;
            12'h2cc: spo = 32'h00f687b3;
            12'h2cd: spo = 32'h0007a783;
            12'h2ce: spo = 32'h00f75663;
            12'h2cf: spo = 32'hfe842783;
            12'h2d0: spo = 32'hfef42223;
            12'h2d1: spo = 32'hfe842783;
            12'h2d2: spo = 32'h00178793;
            12'h2d3: spo = 32'hfef42423;
            12'h2d4: spo = 32'hfe842703;
            12'h2d5: spo = 32'hfd842783;
            12'h2d6: spo = 32'hfaf74ce3;
            12'h2d7: spo = 32'hfe442703;
            12'h2d8: spo = 32'hfec42783;
            12'h2d9: spo = 32'h04f70e63;
            12'h2da: spo = 32'hfec42783;
            12'h2db: spo = 32'h00279793;
            12'h2dc: spo = 32'hfdc42703;
            12'h2dd: spo = 32'h00f707b3;
            12'h2de: spo = 32'h0007a783;
            12'h2df: spo = 32'hfef42023;
            12'h2e0: spo = 32'hfe442783;
            12'h2e1: spo = 32'h00279793;
            12'h2e2: spo = 32'hfdc42703;
            12'h2e3: spo = 32'h00f70733;
            12'h2e4: spo = 32'hfec42783;
            12'h2e5: spo = 32'h00279793;
            12'h2e6: spo = 32'hfdc42683;
            12'h2e7: spo = 32'h00f687b3;
            12'h2e8: spo = 32'h00072703;
            12'h2e9: spo = 32'h00e7a023;
            12'h2ea: spo = 32'hfe442783;
            12'h2eb: spo = 32'h00279793;
            12'h2ec: spo = 32'hfdc42703;
            12'h2ed: spo = 32'h00f707b3;
            12'h2ee: spo = 32'hfe042703;
            12'h2ef: spo = 32'h00e7a023;
            12'h2f0: spo = 32'hfec42783;
            12'h2f1: spo = 32'h00178793;
            12'h2f2: spo = 32'hfef42623;
            12'h2f3: spo = 32'hfd842783;
            12'h2f4: spo = 32'hfff78793;
            12'h2f5: spo = 32'hfec42703;
            12'h2f6: spo = 32'hf2f740e3;
            12'h2f7: spo = 32'h00000013;
            12'h2f8: spo = 32'h00000013;
            12'h2f9: spo = 32'h02c12083;
            12'h2fa: spo = 32'h02812403;
            12'h2fb: spo = 32'h03010113;
            12'h2fc: spo = 32'h00008067;
            12'h2fd: spo = 32'hfd010113;
            12'h2fe: spo = 32'h02112623;
            12'h2ff: spo = 32'h02812423;
            12'h300: spo = 32'h03010413;
            12'h301: spo = 32'hfca42e23;
            12'h302: spo = 32'hfcb42c23;
            12'h303: spo = 32'hfcc42a23;
            12'h304: spo = 32'hfe042623;
            12'h305: spo = 32'h0440006f;
            12'h306: spo = 32'hfec42783;
            12'h307: spo = 32'h00279793;
            12'h308: spo = 32'hfdc42703;
            12'h309: spo = 32'h00f707b3;
            12'h30a: spo = 32'h0007a703;
            12'h30b: spo = 32'hfec42783;
            12'h30c: spo = 32'h00279793;
            12'h30d: spo = 32'hfd842683;
            12'h30e: spo = 32'h00f687b3;
            12'h30f: spo = 32'h0007a783;
            12'h310: spo = 32'h00f70663;
            12'h311: spo = 32'h00000793;
            12'h312: spo = 32'h0200006f;
            12'h313: spo = 32'hfec42783;
            12'h314: spo = 32'h00178793;
            12'h315: spo = 32'hfef42623;
            12'h316: spo = 32'hfec42703;
            12'h317: spo = 32'hfd442783;
            12'h318: spo = 32'hfaf74ce3;
            12'h319: spo = 32'h00100793;
            12'h31a: spo = 32'h00078513;
            12'h31b: spo = 32'h02c12083;
            12'h31c: spo = 32'h02812403;
            12'h31d: spo = 32'h03010113;
            12'h31e: spo = 32'h00008067;
            12'h31f: spo = 32'hfd010113;
            12'h320: spo = 32'h02112623;
            12'h321: spo = 32'h02812423;
            12'h322: spo = 32'h02912223;
            12'h323: spo = 32'h03010413;
            12'h324: spo = 32'hfca42e23;
            12'h325: spo = 32'hfcb42c23;
            12'h326: spo = 32'hfcc42a23;
            12'h327: spo = 32'hfe042623;
            12'h328: spo = 32'h06c0006f;
            12'h329: spo = 32'hfd842703;
            12'h32a: spo = 32'h00070793;
            12'h32b: spo = 32'h00379793;
            12'h32c: spo = 32'h00e787b3;
            12'h32d: spo = 32'h00379793;
            12'h32e: spo = 32'h00e78733;
            12'h32f: spo = 32'hfd442783;
            12'h330: spo = 32'h00078693;
            12'h331: spo = 32'h00579793;
            12'h332: spo = 32'h40f687b3;
            12'h333: spo = 32'h00f70733;
            12'h334: spo = 32'hfec42783;
            12'h335: spo = 32'h00f706b3;
            12'h336: spo = 32'hfec42783;
            12'h337: spo = 32'h00279793;
            12'h338: spo = 32'hfdc42703;
            12'h339: spo = 32'h00f704b3;
            12'h33a: spo = 32'h000037b7;
            12'h33b: spo = 32'h03778593;
            12'h33c: spo = 32'h00068513;
            12'h33d: spo = 32'h284010ef;
            12'h33e: spo = 32'h00050793;
            12'h33f: spo = 32'h00f4a023;
            12'h340: spo = 32'hfec42783;
            12'h341: spo = 32'h00178793;
            12'h342: spo = 32'hfef42623;
            12'h343: spo = 32'hfec42703;
            12'h344: spo = 32'hfd842783;
            12'h345: spo = 32'hf8f748e3;
            12'h346: spo = 32'h00000013;
            12'h347: spo = 32'h00000013;
            12'h348: spo = 32'h02c12083;
            12'h349: spo = 32'h02812403;
            12'h34a: spo = 32'h02412483;
            12'h34b: spo = 32'h03010113;
            12'h34c: spo = 32'h00008067;
            12'h34d: spo = 32'hfd010113;
            12'h34e: spo = 32'h02112623;
            12'h34f: spo = 32'h02812423;
            12'h350: spo = 32'h03010413;
            12'h351: spo = 32'hfca42e23;
            12'h352: spo = 32'hfdc42703;
            12'h353: spo = 32'h00100793;
            12'h354: spo = 32'h00e7c663;
            12'h355: spo = 32'h00000793;
            12'h356: spo = 32'h05c0006f;
            12'h357: spo = 32'h00200793;
            12'h358: spo = 32'hfef42623;
            12'h359: spo = 32'h0300006f;
            12'h35a: spo = 32'hfdc42783;
            12'h35b: spo = 32'hfec42583;
            12'h35c: spo = 32'h00078513;
            12'h35d: spo = 32'h204010ef;
            12'h35e: spo = 32'h00050793;
            12'h35f: spo = 32'h00079663;
            12'h360: spo = 32'h00000793;
            12'h361: spo = 32'h0300006f;
            12'h362: spo = 32'hfec42783;
            12'h363: spo = 32'h00178793;
            12'h364: spo = 32'hfef42623;
            12'h365: spo = 32'hfec42583;
            12'h366: spo = 32'hfec42503;
            12'h367: spo = 32'h20c010ef;
            12'h368: spo = 32'h00050793;
            12'h369: spo = 32'h00078713;
            12'h36a: spo = 32'hfdc42783;
            12'h36b: spo = 32'hfae7dee3;
            12'h36c: spo = 32'h00100793;
            12'h36d: spo = 32'h00078513;
            12'h36e: spo = 32'h02c12083;
            12'h36f: spo = 32'h02812403;
            12'h370: spo = 32'h03010113;
            12'h371: spo = 32'h00008067;
            12'h372: spo = 32'hfd010113;
            12'h373: spo = 32'h02112623;
            12'h374: spo = 32'h02812423;
            12'h375: spo = 32'h03010413;
            12'h376: spo = 32'hfe042623;
            12'h377: spo = 32'hfe042423;
            12'h378: spo = 32'h00200793;
            12'h379: spo = 32'hfef42223;
            12'h37a: spo = 32'h02c0006f;
            12'h37b: spo = 32'hfe442503;
            12'h37c: spo = 32'hf45ff0ef;
            12'h37d: spo = 32'h00050793;
            12'h37e: spo = 32'h00078863;
            12'h37f: spo = 32'hfe842783;
            12'h380: spo = 32'h00178793;
            12'h381: spo = 32'hfef42423;
            12'h382: spo = 32'hfe442783;
            12'h383: spo = 32'h00178793;
            12'h384: spo = 32'hfef42223;
            12'h385: spo = 32'hfe442703;
            12'h386: spo = 32'h000057b7;
            12'h387: spo = 32'he2078793;
            12'h388: spo = 32'hfce7d6e3;
            12'h389: spo = 32'hfe042023;
            12'h38a: spo = 32'h02c0006f;
            12'h38b: spo = 32'h801007b7;
            12'h38c: spo = 32'h03078713;
            12'h38d: spo = 32'hfe042783;
            12'h38e: spo = 32'h00279793;
            12'h38f: spo = 32'h00f707b3;
            12'h390: spo = 32'h00100713;
            12'h391: spo = 32'h00e7a023;
            12'h392: spo = 32'hfe042783;
            12'h393: spo = 32'h00178793;
            12'h394: spo = 32'hfef42023;
            12'h395: spo = 32'hfe042703;
            12'h396: spo = 32'h000057b7;
            12'h397: spo = 32'he2078793;
            12'h398: spo = 32'hfce7d6e3;
            12'h399: spo = 32'h801007b7;
            12'h39a: spo = 32'h03078793;
            12'h39b: spo = 32'h0007a423;
            12'h39c: spo = 32'h00200793;
            12'h39d: spo = 32'hfcf42e23;
            12'h39e: spo = 32'h0800006f;
            12'h39f: spo = 32'h801007b7;
            12'h3a0: spo = 32'h03078713;
            12'h3a1: spo = 32'hfdc42783;
            12'h3a2: spo = 32'h00279793;
            12'h3a3: spo = 32'h00f707b3;
            12'h3a4: spo = 32'h0007a783;
            12'h3a5: spo = 32'h04078c63;
            12'h3a6: spo = 32'hfec42783;
            12'h3a7: spo = 32'h00178793;
            12'h3a8: spo = 32'hfef42623;
            12'h3a9: spo = 32'hfdc42783;
            12'h3aa: spo = 32'h00179793;
            12'h3ab: spo = 32'hfcf42c23;
            12'h3ac: spo = 32'h02c0006f;
            12'h3ad: spo = 32'h801007b7;
            12'h3ae: spo = 32'h03078713;
            12'h3af: spo = 32'hfd842783;
            12'h3b0: spo = 32'h00279793;
            12'h3b1: spo = 32'h00f707b3;
            12'h3b2: spo = 32'h0007a023;
            12'h3b3: spo = 32'hfd842703;
            12'h3b4: spo = 32'hfdc42783;
            12'h3b5: spo = 32'h00f707b3;
            12'h3b6: spo = 32'hfcf42c23;
            12'h3b7: spo = 32'hfd842703;
            12'h3b8: spo = 32'h000057b7;
            12'h3b9: spo = 32'he2078793;
            12'h3ba: spo = 32'hfce7d6e3;
            12'h3bb: spo = 32'hfdc42783;
            12'h3bc: spo = 32'h00178793;
            12'h3bd: spo = 32'hfcf42e23;
            12'h3be: spo = 32'hfdc42703;
            12'h3bf: spo = 32'h000057b7;
            12'h3c0: spo = 32'he2078793;
            12'h3c1: spo = 32'hf6e7dce3;
            12'h3c2: spo = 32'hfec42703;
            12'h3c3: spo = 32'hfe842783;
            12'h3c4: spo = 32'h40f707b3;
            12'h3c5: spo = 32'h0017b793;
            12'h3c6: spo = 32'h0ff7f793;
            12'h3c7: spo = 32'h00078513;
            12'h3c8: spo = 32'h02c12083;
            12'h3c9: spo = 32'h02812403;
            12'h3ca: spo = 32'h03010113;
            12'h3cb: spo = 32'h00008067;
            12'h3cc: spo = 32'hff010113;
            12'h3cd: spo = 32'h00112623;
            12'h3ce: spo = 32'h00812423;
            12'h3cf: spo = 32'h01010413;
            12'h3d0: spo = 32'hc4cff0ef;
            12'h3d1: spo = 32'hca0ff0ef;
            12'h3d2: spo = 32'h00050793;
            12'h3d3: spo = 32'h00078513;
            12'h3d4: spo = 32'ha00ff0ef;
            12'h3d5: spo = 32'hb34ff0ef;
            12'h3d6: spo = 32'h00000f93;
            12'h3d7: spo = 32'h00000013;
            12'h3d8: spo = 32'h00c12083;
            12'h3d9: spo = 32'h00812403;
            12'h3da: spo = 32'h01010113;
            12'h3db: spo = 32'h00008067;
            12'h3dc: spo = 32'hff010113;
            12'h3dd: spo = 32'h00112623;
            12'h3de: spo = 32'h00812423;
            12'h3df: spo = 32'h01010413;
            12'h3e0: spo = 32'hc0cff0ef;
            12'h3e1: spo = 32'hc60ff0ef;
            12'h3e2: spo = 32'h00050793;
            12'h3e3: spo = 32'h00078513;
            12'h3e4: spo = 32'h9c0ff0ef;
            12'h3e5: spo = 32'ha58ff0ef;
            12'h3e6: spo = 32'h00100f93;
            12'h3e7: spo = 32'h00000013;
            12'h3e8: spo = 32'h00c12083;
            12'h3e9: spo = 32'h00812403;
            12'h3ea: spo = 32'h01010113;
            12'h3eb: spo = 32'h00008067;
            12'h3ec: spo = 32'hfe010113;
            12'h3ed: spo = 32'h00112e23;
            12'h3ee: spo = 32'h00812c23;
            12'h3ef: spo = 32'h02010413;
            12'h3f0: spo = 32'h944ff0ef;
            12'h3f1: spo = 32'hb70ff0ef;
            12'h3f2: spo = 32'hfe042623;
            12'h3f3: spo = 32'h0980006f;
            12'h3f4: spo = 32'hfec42583;
            12'h3f5: spo = 32'h801147b7;
            12'h3f6: spo = 32'h8c478513;
            12'h3f7: spo = 32'h90dff0ef;
            12'h3f8: spo = 32'hfec42783;
            12'h3f9: spo = 32'h00179793;
            12'h3fa: spo = 32'h00078593;
            12'h3fb: spo = 32'h8011b7b7;
            12'h3fc: spo = 32'h75478513;
            12'h3fd: spo = 32'h8f5ff0ef;
            12'h3fe: spo = 32'h801237b7;
            12'h3ff: spo = 32'h5e478613;
            12'h400: spo = 32'h8011b7b7;
            12'h401: spo = 32'h75478593;
            12'h402: spo = 32'h801147b7;
            12'h403: spo = 32'h8c478513;
            12'h404: spo = 32'hc04ff0ef;
            12'h405: spo = 32'h8012b7b7;
            12'h406: spo = 32'h47478613;
            12'h407: spo = 32'h8011b7b7;
            12'h408: spo = 32'h75478593;
            12'h409: spo = 32'h801147b7;
            12'h40a: spo = 32'h8c478513;
            12'h40b: spo = 32'hd4cff0ef;
            12'h40c: spo = 32'h8012b7b7;
            12'h40d: spo = 32'h47478593;
            12'h40e: spo = 32'h801237b7;
            12'h40f: spo = 32'h5e478513;
            12'h410: spo = 32'hfbcff0ef;
            12'h411: spo = 32'h00050793;
            12'h412: spo = 32'h00079863;
            12'h413: spo = 32'hee5ff0ef;
            12'h414: spo = 32'h00000793;
            12'h415: spo = 32'h10c0006f;
            12'h416: spo = 32'hfec42783;
            12'h417: spo = 32'h00178793;
            12'h418: spo = 32'hfef42623;
            12'h419: spo = 32'hfec42703;
            12'h41a: spo = 32'h00900793;
            12'h41b: spo = 32'hf6e7d2e3;
            12'h41c: spo = 32'hfe042423;
            12'h41d: spo = 32'h0c00006f;
            12'h41e: spo = 32'hfe842603;
            12'h41f: spo = 32'h3e800593;
            12'h420: spo = 32'h801337b7;
            12'h421: spo = 32'h30478513;
            12'h422: spo = 32'hbf5ff0ef;
            12'h423: spo = 32'hfe042223;
            12'h424: spo = 32'h0400006f;
            12'h425: spo = 32'h801337b7;
            12'h426: spo = 32'h30478713;
            12'h427: spo = 32'hfe442783;
            12'h428: spo = 32'h00279793;
            12'h429: spo = 32'h00f707b3;
            12'h42a: spo = 32'h0007a703;
            12'h42b: spo = 32'h801347b7;
            12'h42c: spo = 32'h2a478693;
            12'h42d: spo = 32'hfe442783;
            12'h42e: spo = 32'h00279793;
            12'h42f: spo = 32'h00f687b3;
            12'h430: spo = 32'h00e7a023;
            12'h431: spo = 32'hfe442783;
            12'h432: spo = 32'h00178793;
            12'h433: spo = 32'hfef42223;
            12'h434: spo = 32'hfe442703;
            12'h435: spo = 32'h3e700793;
            12'h436: spo = 32'hfae7dee3;
            12'h437: spo = 32'h3e800593;
            12'h438: spo = 32'h801337b7;
            12'h439: spo = 32'h30478513;
            12'h43a: spo = 32'h8e1ff0ef;
            12'h43b: spo = 32'h3e800593;
            12'h43c: spo = 32'h801347b7;
            12'h43d: spo = 32'h2a478513;
            12'h43e: spo = 32'h9e1ff0ef;
            12'h43f: spo = 32'h3e800613;
            12'h440: spo = 32'h801347b7;
            12'h441: spo = 32'h2a478593;
            12'h442: spo = 32'h801337b7;
            12'h443: spo = 32'h30478513;
            12'h444: spo = 32'hae5ff0ef;
            12'h445: spo = 32'h00050793;
            12'h446: spo = 32'h00079863;
            12'h447: spo = 32'he15ff0ef;
            12'h448: spo = 32'h00000793;
            12'h449: spo = 32'h03c0006f;
            12'h44a: spo = 32'hfe842783;
            12'h44b: spo = 32'h00178793;
            12'h44c: spo = 32'hfef42423;
            12'h44d: spo = 32'hfe842703;
            12'h44e: spo = 32'h00900793;
            12'h44f: spo = 32'hf2e7dee3;
            12'h450: spo = 32'hc89ff0ef;
            12'h451: spo = 32'h00050793;
            12'h452: spo = 32'h00079863;
            12'h453: spo = 32'hde5ff0ef;
            12'h454: spo = 32'h00000793;
            12'h455: spo = 32'h00c0006f;
            12'h456: spo = 32'he19ff0ef;
            12'h457: spo = 32'h00000793;
            12'h458: spo = 32'h00078513;
            12'h459: spo = 32'h01c12083;
            12'h45a: spo = 32'h01812403;
            12'h45b: spo = 32'h02010113;
            12'h45c: spo = 32'h00008067;
            12'h45d: spo = 32'h000ff317;
            12'h45e: spo = 32'he9430313;
            12'h45f: spo = 32'h00132c23;
            12'h460: spo = 32'h0a4000ef;
            12'h461: spo = 32'h184000ef;
            12'h462: spo = 32'h34c000ef;
            12'h463: spo = 32'h468000ef;
            12'h464: spo = 32'h294000ef;
            12'h465: spo = 32'h1d0000ef;
            12'h466: spo = 32'h4b0000ef;
            12'h467: spo = 32'h55c000ef;
            12'h468: spo = 32'h600000ef;
            12'h469: spo = 32'h6ac000ef;
            12'h46a: spo = 32'h764000ef;
            12'h46b: spo = 32'h79c000ef;
            12'h46c: spo = 32'h38c000ef;
            12'h46d: spo = 32'h108000ef;
            12'h46e: spo = 32'h218000ef;
            12'h46f: spo = 32'h2c4000ef;
            12'h470: spo = 32'h3e8000ef;
            12'h471: spo = 32'h4dc000ef;
            12'h472: spo = 32'h588000ef;
            12'h473: spo = 32'h630000ef;
            12'h474: spo = 32'h6ec000ef;
            12'h475: spo = 32'h015000ef;
            12'h476: spo = 32'h7bc000ef;
            12'h477: spo = 32'h151000ef;
            12'h478: spo = 32'h1d5000ef;
            12'h479: spo = 32'h059000ef;
            12'h47a: spo = 32'h0a5000ef;
            12'h47b: spo = 32'h0f9000ef;
            12'h47c: spo = 32'h231000ef;
            12'h47d: spo = 32'h27d000ef;
            12'h47e: spo = 32'h2cd000ef;
            12'h47f: spo = 32'h315000ef;
            12'h480: spo = 32'h35d000ef;
            12'h481: spo = 32'h3a5000ef;
            12'h482: spo = 32'h3ed000ef;
            12'h483: spo = 32'h435000ef;
            12'h484: spo = 32'h481000ef;
            12'h485: spo = 32'h000ff317;
            12'h486: spo = 32'hdf430313;
            12'h487: spo = 32'h01832083;
            12'h488: spo = 32'h00008067;
            12'h489: spo = 32'h800002b7;
            12'h48a: spo = 32'hfff28293;
            12'h48b: spo = 32'h00100313;
            12'h48c: spo = 32'h006283b3;
            12'h48d: spo = 32'h80000e37;
            12'h48e: spo = 32'h07c39663;
            12'h48f: spo = 32'hfff00293;
            12'h490: spo = 32'h00100313;
            12'h491: spo = 32'h006283b3;
            12'h492: spo = 32'h04039e63;
            12'h493: spo = 32'h123452b7;
            12'h494: spo = 32'h67828293;
            12'h495: spo = 32'h87654337;
            12'h496: spo = 32'h32130313;
            12'h497: spo = 32'h006283b3;
            12'h498: spo = 32'h9999ae37;
            12'h499: spo = 32'h999e0e13;
            12'h49a: spo = 32'h03c39e63;
            12'h49b: spo = 32'h9999ae37;
            12'h49c: spo = 32'h999e0e13;
            12'h49d: spo = 32'h9999aeb7;
            12'h49e: spo = 32'h999e8e93;
            12'h49f: spo = 32'h01de0f33;
            12'h4a0: spo = 32'h33333fb7;
            12'h4a1: spo = 32'h332f8f93;
            12'h4a2: spo = 32'h01ff1e63;
            12'h4a3: spo = 32'h000ff297;
            12'h4a4: spo = 32'hd7428293;
            12'h4a5: spo = 32'h0002a303;
            12'h4a6: spo = 32'h00130313;
            12'h4a7: spo = 32'h0062a023;
            12'h4a8: spo = 32'h00008067;
            12'h4a9: spo = 32'h000ff297;
            12'h4aa: spo = 32'hd6028293;
            12'h4ab: spo = 32'h0002a303;
            12'h4ac: spo = 32'h00130313;
            12'h4ad: spo = 32'h0062a023;
            12'h4ae: spo = 32'h00008067;
            12'h4af: spo = 32'h00000293;
            12'h4b0: spo = 32'h07b28313;
            12'h4b1: spo = 32'h07b00393;
            12'h4b2: spo = 32'h02731463;
            12'h4b3: spo = 32'hfff00293;
            12'h4b4: spo = 32'h00128313;
            12'h4b5: spo = 32'h00031e63;
            12'h4b6: spo = 32'h000ff297;
            12'h4b7: spo = 32'hd2828293;
            12'h4b8: spo = 32'h0002a303;
            12'h4b9: spo = 32'h00130313;
            12'h4ba: spo = 32'h0062a023;
            12'h4bb: spo = 32'h00008067;
            12'h4bc: spo = 32'h000ff297;
            12'h4bd: spo = 32'hd1428293;
            12'h4be: spo = 32'h0002a303;
            12'h4bf: spo = 32'h00130313;
            12'h4c0: spo = 32'h0062a023;
            12'h4c1: spo = 32'h00008067;
            12'h4c2: spo = 32'h800002b7;
            12'h4c3: spo = 32'hfff28293;
            12'h4c4: spo = 32'h80000337;
            12'h4c5: spo = 32'hfff30313;
            12'h4c6: spo = 32'h406283b3;
            12'h4c7: spo = 32'h02039863;
            12'h4c8: spo = 32'h00000293;
            12'h4c9: spo = 32'hfff00313;
            12'h4ca: spo = 32'h406283b3;
            12'h4cb: spo = 32'h00100e13;
            12'h4cc: spo = 32'h01c39e63;
            12'h4cd: spo = 32'h000ff297;
            12'h4ce: spo = 32'hccc28293;
            12'h4cf: spo = 32'h0002a303;
            12'h4d0: spo = 32'h00130313;
            12'h4d1: spo = 32'h0062a023;
            12'h4d2: spo = 32'h00008067;
            12'h4d3: spo = 32'h000ff297;
            12'h4d4: spo = 32'hcb828293;
            12'h4d5: spo = 32'h0002a303;
            12'h4d6: spo = 32'h00130313;
            12'h4d7: spo = 32'h0062a023;
            12'h4d8: spo = 32'h00008067;
            12'h4d9: spo = 32'haaaab2b7;
            12'h4da: spo = 32'haaa28293;
            12'h4db: spo = 32'h55555337;
            12'h4dc: spo = 32'h55530313;
            12'h4dd: spo = 32'h0062f3b3;
            12'h4de: spo = 32'h04039063;
            12'h4df: spo = 32'hfff00293;
            12'h4e0: spo = 32'h00000313;
            12'h4e1: spo = 32'h0062f3b3;
            12'h4e2: spo = 32'h02039863;
            12'h4e3: spo = 32'h123452b7;
            12'h4e4: spo = 32'h67828293;
            12'h4e5: spo = 32'hfff00313;
            12'h4e6: spo = 32'h0062f3b3;
            12'h4e7: spo = 32'h00539e63;
            12'h4e8: spo = 32'h000ff297;
            12'h4e9: spo = 32'hc6028293;
            12'h4ea: spo = 32'h0002a303;
            12'h4eb: spo = 32'h00130313;
            12'h4ec: spo = 32'h0062a023;
            12'h4ed: spo = 32'h00008067;
            12'h4ee: spo = 32'h000ff297;
            12'h4ef: spo = 32'hc4c28293;
            12'h4f0: spo = 32'h0002a303;
            12'h4f1: spo = 32'h00130313;
            12'h4f2: spo = 32'h0062a023;
            12'h4f3: spo = 32'h00008067;
            12'h4f4: spo = 32'hfff00293;
            12'h4f5: spo = 32'h70f2f313;
            12'h4f6: spo = 32'h70f00393;
            12'h4f7: spo = 32'h02731863;
            12'h4f8: spo = 32'h1234b2b7;
            12'h4f9: spo = 32'hbcd28293;
            12'h4fa: spo = 32'h5cb2f313;
            12'h4fb: spo = 32'h1c900393;
            12'h4fc: spo = 32'h00731e63;
            12'h4fd: spo = 32'h000ff297;
            12'h4fe: spo = 32'hc0c28293;
            12'h4ff: spo = 32'h0002a303;
            12'h500: spo = 32'h00130313;
            12'h501: spo = 32'h0062a023;
            12'h502: spo = 32'h00008067;
            12'h503: spo = 32'h000ff297;
            12'h504: spo = 32'hbf828293;
            12'h505: spo = 32'h0002a303;
            12'h506: spo = 32'h00130313;
            12'h507: spo = 32'h0062a023;
            12'h508: spo = 32'h00008067;
            12'h509: spo = 32'haaaab2b7;
            12'h50a: spo = 32'haaa28293;
            12'h50b: spo = 32'h55555337;
            12'h50c: spo = 32'h55530313;
            12'h50d: spo = 32'h0062e3b3;
            12'h50e: spo = 32'hfff00e13;
            12'h50f: spo = 32'h03c39663;
            12'h510: spo = 32'h00000293;
            12'h511: spo = 32'h00000313;
            12'h512: spo = 32'h0062e3b3;
            12'h513: spo = 32'h00039e63;
            12'h514: spo = 32'h000ff297;
            12'h515: spo = 32'hbb028293;
            12'h516: spo = 32'h0002a303;
            12'h517: spo = 32'h00130313;
            12'h518: spo = 32'h0062a023;
            12'h519: spo = 32'h00008067;
            12'h51a: spo = 32'h000ff297;
            12'h51b: spo = 32'hb9c28293;
            12'h51c: spo = 32'h0002a303;
            12'h51d: spo = 32'h00130313;
            12'h51e: spo = 32'h0062a023;
            12'h51f: spo = 32'h00008067;
            12'h520: spo = 32'h00000293;
            12'h521: spo = 32'h7f02e313;
            12'h522: spo = 32'h7f000393;
            12'h523: spo = 32'h02731863;
            12'h524: spo = 32'haaaa02b7;
            12'h525: spo = 32'h7ff2e313;
            12'h526: spo = 32'haaaa03b7;
            12'h527: spo = 32'h7ff38393;
            12'h528: spo = 32'h00731e63;
            12'h529: spo = 32'h000ff297;
            12'h52a: spo = 32'hb5c28293;
            12'h52b: spo = 32'h0002a303;
            12'h52c: spo = 32'h00130313;
            12'h52d: spo = 32'h0062a023;
            12'h52e: spo = 32'h00008067;
            12'h52f: spo = 32'h000ff297;
            12'h530: spo = 32'hb4828293;
            12'h531: spo = 32'h0002a303;
            12'h532: spo = 32'h00130313;
            12'h533: spo = 32'h0062a023;
            12'h534: spo = 32'h00008067;
            12'h535: spo = 32'hfff00293;
            12'h536: spo = 32'h00000313;
            12'h537: spo = 32'h0062a3b3;
            12'h538: spo = 32'h00100e13;
            12'h539: spo = 32'h05c39063;
            12'h53a: spo = 32'h07b00293;
            12'h53b: spo = 32'h07b00313;
            12'h53c: spo = 32'h0062a3b3;
            12'h53d: spo = 32'h02039863;
            12'h53e: spo = 32'h800002b7;
            12'h53f: spo = 32'hfff28293;
            12'h540: spo = 32'hfff00313;
            12'h541: spo = 32'h0062a3b3;
            12'h542: spo = 32'h00039e63;
            12'h543: spo = 32'h000ff297;
            12'h544: spo = 32'haf428293;
            12'h545: spo = 32'h0002a303;
            12'h546: spo = 32'h00130313;
            12'h547: spo = 32'h0062a023;
            12'h548: spo = 32'h00008067;
            12'h549: spo = 32'h000ff297;
            12'h54a: spo = 32'hae028293;
            12'h54b: spo = 32'h0002a303;
            12'h54c: spo = 32'h00130313;
            12'h54d: spo = 32'h0062a023;
            12'h54e: spo = 32'h00008067;
            12'h54f: spo = 32'hfff00293;
            12'h550: spo = 32'h0002a313;
            12'h551: spo = 32'h00100393;
            12'h552: spo = 32'h04731663;
            12'h553: spo = 32'h00500293;
            12'h554: spo = 32'h00a2a313;
            12'h555: spo = 32'h00100393;
            12'h556: spo = 32'h02731e63;
            12'h557: spo = 32'h00500293;
            12'h558: spo = 32'h0052a313;
            12'h559: spo = 32'h00000393;
            12'h55a: spo = 32'h02731663;
            12'h55b: spo = 32'h00a00293;
            12'h55c: spo = 32'h0052a313;
            12'h55d: spo = 32'h00000393;
            12'h55e: spo = 32'h00731e63;
            12'h55f: spo = 32'h000ff297;
            12'h560: spo = 32'ha8428293;
            12'h561: spo = 32'h0002a303;
            12'h562: spo = 32'h00130313;
            12'h563: spo = 32'h0062a023;
            12'h564: spo = 32'h00008067;
            12'h565: spo = 32'h000ff297;
            12'h566: spo = 32'ha7028293;
            12'h567: spo = 32'h0002a303;
            12'h568: spo = 32'h00130313;
            12'h569: spo = 32'h0062a023;
            12'h56a: spo = 32'h00000293;
            12'h56b: spo = 32'h0012b313;
            12'h56c: spo = 32'h00100393;
            12'h56d: spo = 32'h02731463;
            12'h56e: spo = 32'hfff00293;
            12'h56f: spo = 32'hfff2b313;
            12'h570: spo = 32'h00031e63;
            12'h571: spo = 32'h000ff297;
            12'h572: spo = 32'ha3c28293;
            12'h573: spo = 32'h0002a303;
            12'h574: spo = 32'h00130313;
            12'h575: spo = 32'h0062a023;
            12'h576: spo = 32'h00008067;
            12'h577: spo = 32'h000ff297;
            12'h578: spo = 32'ha2828293;
            12'h579: spo = 32'h0002a303;
            12'h57a: spo = 32'h00130313;
            12'h57b: spo = 32'h0062a023;
            12'h57c: spo = 32'h00008067;
            12'h57d: spo = 32'hfff00293;
            12'h57e: spo = 32'h00000313;
            12'h57f: spo = 32'h0062b3b3;
            12'h580: spo = 32'h02039863;
            12'h581: spo = 32'h00000293;
            12'h582: spo = 32'h00100313;
            12'h583: spo = 32'h0062b3b3;
            12'h584: spo = 32'h00100e13;
            12'h585: spo = 32'h01c39e63;
            12'h586: spo = 32'h000ff297;
            12'h587: spo = 32'h9e828293;
            12'h588: spo = 32'h0002a303;
            12'h589: spo = 32'h00130313;
            12'h58a: spo = 32'h0062a023;
            12'h58b: spo = 32'h00008067;
            12'h58c: spo = 32'h000ff297;
            12'h58d: spo = 32'h9d428293;
            12'h58e: spo = 32'h0002a303;
            12'h58f: spo = 32'h00130313;
            12'h590: spo = 32'h0062a023;
            12'h591: spo = 32'h00008067;
            12'h592: spo = 32'hffff02b7;
            12'h593: spo = 32'h00010337;
            12'h594: spo = 32'hfff30313;
            12'h595: spo = 32'h0062c3b3;
            12'h596: spo = 32'hfff00e13;
            12'h597: spo = 32'h03c39663;
            12'h598: spo = 32'haaaab2b7;
            12'h599: spo = 32'haaa28293;
            12'h59a: spo = 32'h0052c3b3;
            12'h59b: spo = 32'h00039e63;
            12'h59c: spo = 32'h000ff297;
            12'h59d: spo = 32'h99028293;
            12'h59e: spo = 32'h0002a303;
            12'h59f: spo = 32'h00130313;
            12'h5a0: spo = 32'h0062a023;
            12'h5a1: spo = 32'h00008067;
            12'h5a2: spo = 32'h000ff297;
            12'h5a3: spo = 32'h97c28293;
            12'h5a4: spo = 32'h0002a303;
            12'h5a5: spo = 32'h00130313;
            12'h5a6: spo = 32'h0062a023;
            12'h5a7: spo = 32'h00008067;
            12'h5a8: spo = 32'h0000b2b7;
            12'h5a9: spo = 32'haaa28293;
            12'h5aa: spo = 32'h5552c313;
            12'h5ab: spo = 32'h0000b3b7;
            12'h5ac: spo = 32'hfff38393;
            12'h5ad: spo = 32'h02731663;
            12'h5ae: spo = 32'h00400293;
            12'h5af: spo = 32'h2342c313;
            12'h5b0: spo = 32'h23000393;
            12'h5b1: spo = 32'h00731e63;
            12'h5b2: spo = 32'h000ff297;
            12'h5b3: spo = 32'h93828293;
            12'h5b4: spo = 32'h0002a303;
            12'h5b5: spo = 32'h00130313;
            12'h5b6: spo = 32'h0062a023;
            12'h5b7: spo = 32'h00008067;
            12'h5b8: spo = 32'h000ff297;
            12'h5b9: spo = 32'h92428293;
            12'h5ba: spo = 32'h0002a303;
            12'h5bb: spo = 32'h00130313;
            12'h5bc: spo = 32'h0062a023;
            12'h5bd: spo = 32'h00008067;
            12'h5be: spo = 32'h00100293;
            12'h5bf: spo = 32'h00300313;
            12'h5c0: spo = 32'h006293b3;
            12'h5c1: spo = 32'h00800e13;
            12'h5c2: spo = 32'h03c39863;
            12'h5c3: spo = 32'h00100293;
            12'h5c4: spo = 32'h01f00313;
            12'h5c5: spo = 32'h006293b3;
            12'h5c6: spo = 32'h80000e37;
            12'h5c7: spo = 32'h01c39e63;
            12'h5c8: spo = 32'h000ff297;
            12'h5c9: spo = 32'h8e028293;
            12'h5ca: spo = 32'h0002a303;
            12'h5cb: spo = 32'h00130313;
            12'h5cc: spo = 32'h0062a023;
            12'h5cd: spo = 32'h00008067;
            12'h5ce: spo = 32'h000ff297;
            12'h5cf: spo = 32'h8cc28293;
            12'h5d0: spo = 32'h0002a303;
            12'h5d1: spo = 32'h00130313;
            12'h5d2: spo = 32'h0062a023;
            12'h5d3: spo = 32'h00008067;
            12'h5d4: spo = 32'h00100293;
            12'h5d5: spo = 32'h00429313;
            12'h5d6: spo = 32'h01000393;
            12'h5d7: spo = 32'h02731663;
            12'h5d8: spo = 32'h00100293;
            12'h5d9: spo = 32'h01f29313;
            12'h5da: spo = 32'h800003b7;
            12'h5db: spo = 32'h00731e63;
            12'h5dc: spo = 32'h000ff297;
            12'h5dd: spo = 32'h89028293;
            12'h5de: spo = 32'h0002a303;
            12'h5df: spo = 32'h00130313;
            12'h5e0: spo = 32'h0062a023;
            12'h5e1: spo = 32'h00008067;
            12'h5e2: spo = 32'h000ff297;
            12'h5e3: spo = 32'h87c28293;
            12'h5e4: spo = 32'h0002a303;
            12'h5e5: spo = 32'h00130313;
            12'h5e6: spo = 32'h0062a023;
            12'h5e7: spo = 32'h00008067;
            12'h5e8: spo = 32'h800002b7;
            12'h5e9: spo = 32'h01f00313;
            12'h5ea: spo = 32'h0062d3b3;
            12'h5eb: spo = 32'h00100e13;
            12'h5ec: spo = 32'h03c39a63;
            12'h5ed: spo = 32'hfff00293;
            12'h5ee: spo = 32'h00400313;
            12'h5ef: spo = 32'h0062d3b3;
            12'h5f0: spo = 32'h10000e37;
            12'h5f1: spo = 32'hfffe0e13;
            12'h5f2: spo = 32'h01c39e63;
            12'h5f3: spo = 32'h000ff297;
            12'h5f4: spo = 32'h83428293;
            12'h5f5: spo = 32'h0002a303;
            12'h5f6: spo = 32'h00130313;
            12'h5f7: spo = 32'h0062a023;
            12'h5f8: spo = 32'h00008067;
            12'h5f9: spo = 32'h000ff297;
            12'h5fa: spo = 32'h82028293;
            12'h5fb: spo = 32'h0002a303;
            12'h5fc: spo = 32'h00130313;
            12'h5fd: spo = 32'h0062a023;
            12'h5fe: spo = 32'h00008067;
            12'h5ff: spo = 32'h800002b7;
            12'h600: spo = 32'h01f2d313;
            12'h601: spo = 32'h00100393;
            12'h602: spo = 32'h02731863;
            12'h603: spo = 32'hfff00293;
            12'h604: spo = 32'h0042d313;
            12'h605: spo = 32'h100003b7;
            12'h606: spo = 32'hfff38393;
            12'h607: spo = 32'h00731e63;
            12'h608: spo = 32'h000fe297;
            12'h609: spo = 32'h7e028293;
            12'h60a: spo = 32'h0002a303;
            12'h60b: spo = 32'h00130313;
            12'h60c: spo = 32'h0062a023;
            12'h60d: spo = 32'h00008067;
            12'h60e: spo = 32'h000fe297;
            12'h60f: spo = 32'h7cc28293;
            12'h610: spo = 32'h0002a303;
            12'h611: spo = 32'h00130313;
            12'h612: spo = 32'h0062a023;
            12'h613: spo = 32'h00008067;
            12'h614: spo = 32'hfff00293;
            12'h615: spo = 32'h01f00313;
            12'h616: spo = 32'h4062d3b3;
            12'h617: spo = 32'hfff00e13;
            12'h618: spo = 32'h05c39263;
            12'h619: spo = 32'h800002b7;
            12'h61a: spo = 32'h01f00313;
            12'h61b: spo = 32'h4062d3b3;
            12'h61c: spo = 32'hfff00e13;
            12'h61d: spo = 32'h03c39863;
            12'h61e: spo = 32'h010002b7;
            12'h61f: spo = 32'h00400313;
            12'h620: spo = 32'h4062d3b3;
            12'h621: spo = 32'h00100e37;
            12'h622: spo = 32'h01c39e63;
            12'h623: spo = 32'h000fe297;
            12'h624: spo = 32'h77428293;
            12'h625: spo = 32'h0002a303;
            12'h626: spo = 32'h00130313;
            12'h627: spo = 32'h0062a023;
            12'h628: spo = 32'h00008067;
            12'h629: spo = 32'h000fe297;
            12'h62a: spo = 32'h76028293;
            12'h62b: spo = 32'h0002a303;
            12'h62c: spo = 32'h00130313;
            12'h62d: spo = 32'h0062a023;
            12'h62e: spo = 32'h00008067;
            12'h62f: spo = 32'hfff00293;
            12'h630: spo = 32'h41f2d313;
            12'h631: spo = 32'hfff00393;
            12'h632: spo = 32'h02731663;
            12'h633: spo = 32'h800002b7;
            12'h634: spo = 32'h41f2d313;
            12'h635: spo = 32'hfff00393;
            12'h636: spo = 32'h00731e63;
            12'h637: spo = 32'h000fe297;
            12'h638: spo = 32'h72428293;
            12'h639: spo = 32'h0002a303;
            12'h63a: spo = 32'h00130313;
            12'h63b: spo = 32'h0062a023;
            12'h63c: spo = 32'h00008067;
            12'h63d: spo = 32'h000fe297;
            12'h63e: spo = 32'h71028293;
            12'h63f: spo = 32'h0002a303;
            12'h640: spo = 32'h00130313;
            12'h641: spo = 32'h0062a023;
            12'h642: spo = 32'h00008067;
            12'h643: spo = 32'h123452b7;
            12'h644: spo = 32'h12345337;
            12'h645: spo = 32'h00629e63;
            12'h646: spo = 32'h000fe297;
            12'h647: spo = 32'h6e828293;
            12'h648: spo = 32'h0002a303;
            12'h649: spo = 32'h00130313;
            12'h64a: spo = 32'h0062a023;
            12'h64b: spo = 32'h00008067;
            12'h64c: spo = 32'h000fe297;
            12'h64d: spo = 32'h6d428293;
            12'h64e: spo = 32'h0002a303;
            12'h64f: spo = 32'h00130313;
            12'h650: spo = 32'h0062a023;
            12'h651: spo = 32'h00008067;
            12'h652: spo = 32'h00000297;
            12'h653: spo = 32'h00028293;
            12'h654: spo = 32'h00000013;
            12'h655: spo = 32'h00000013;
            12'h656: spo = 32'h00000317;
            12'h657: spo = 32'hff030313;
            12'h658: spo = 32'h00629e63;
            12'h659: spo = 32'h000fe297;
            12'h65a: spo = 32'h69c28293;
            12'h65b: spo = 32'h0002a303;
            12'h65c: spo = 32'h00130313;
            12'h65d: spo = 32'h0062a023;
            12'h65e: spo = 32'h00008067;
            12'h65f: spo = 32'h000fe297;
            12'h660: spo = 32'h68828293;
            12'h661: spo = 32'h0002a303;
            12'h662: spo = 32'h00130313;
            12'h663: spo = 32'h0062a023;
            12'h664: spo = 32'h00008067;
            12'h665: spo = 32'h123452b7;
            12'h666: spo = 32'h68828293;
            12'h667: spo = 32'h000fe317;
            12'h668: spo = 32'h66c30313;
            12'h669: spo = 32'h00532023;
            12'h66a: spo = 32'h00032383;
            12'h66b: spo = 32'h12345e37;
            12'h66c: spo = 32'h688e0e13;
            12'h66d: spo = 32'h01c39e63;
            12'h66e: spo = 32'h000fe297;
            12'h66f: spo = 32'h64828293;
            12'h670: spo = 32'h0002a303;
            12'h671: spo = 32'h00130313;
            12'h672: spo = 32'h0062a023;
            12'h673: spo = 32'h00008067;
            12'h674: spo = 32'h000fe297;
            12'h675: spo = 32'h63428293;
            12'h676: spo = 32'h0002a303;
            12'h677: spo = 32'h00130313;
            12'h678: spo = 32'h0062a023;
            12'h679: spo = 32'h00008067;
            12'h67a: spo = 32'h00008413;
            12'h67b: spo = 32'h010000ef;
            12'h67c: spo = 32'h00000297;
            12'h67d: spo = 32'h00509863;
            12'h67e: spo = 32'h0280006f;
            12'h67f: spo = 32'h00400313;
            12'h680: spo = 32'h00008067;
            12'h681: spo = 32'h000fe297;
            12'h682: spo = 32'h60028293;
            12'h683: spo = 32'h0002a303;
            12'h684: spo = 32'h00130313;
            12'h685: spo = 32'h0062a023;
            12'h686: spo = 32'h00040093;
            12'h687: spo = 32'h00008067;
            12'h688: spo = 32'h000fe297;
            12'h689: spo = 32'h5e028293;
            12'h68a: spo = 32'h0002a303;
            12'h68b: spo = 32'h00130313;
            12'h68c: spo = 32'h0062a023;
            12'h68d: spo = 32'h00040093;
            12'h68e: spo = 32'h00008067;
            12'h68f: spo = 32'h000fe297;
            12'h690: spo = 32'h5cc28293;
            12'h691: spo = 32'h00228303;
            12'h692: spo = 32'h03400393;
            12'h693: spo = 32'h02731463;
            12'h694: spo = 32'h00028303;
            12'h695: spo = 32'hf8800393;
            12'h696: spo = 32'h00731e63;
            12'h697: spo = 32'h000fe297;
            12'h698: spo = 32'h5a428293;
            12'h699: spo = 32'h0002a303;
            12'h69a: spo = 32'h00130313;
            12'h69b: spo = 32'h0062a023;
            12'h69c: spo = 32'h00008067;
            12'h69d: spo = 32'h000fe297;
            12'h69e: spo = 32'h59028293;
            12'h69f: spo = 32'h0002a303;
            12'h6a0: spo = 32'h00130313;
            12'h6a1: spo = 32'h0062a023;
            12'h6a2: spo = 32'h00008067;
            12'h6a3: spo = 32'h000fe297;
            12'h6a4: spo = 32'h57c28293;
            12'h6a5: spo = 32'h00429303;
            12'h6a6: spo = 32'hffffb3b7;
            12'h6a7: spo = 32'hbcd38393;
            12'h6a8: spo = 32'h02731663;
            12'h6a9: spo = 32'h00629303;
            12'h6aa: spo = 32'h000013b7;
            12'h6ab: spo = 32'h23438393;
            12'h6ac: spo = 32'h00731e63;
            12'h6ad: spo = 32'h000fe297;
            12'h6ae: spo = 32'h54c28293;
            12'h6af: spo = 32'h0002a303;
            12'h6b0: spo = 32'h00130313;
            12'h6b1: spo = 32'h0062a023;
            12'h6b2: spo = 32'h00008067;
            12'h6b3: spo = 32'h000fe297;
            12'h6b4: spo = 32'h53828293;
            12'h6b5: spo = 32'h0002a303;
            12'h6b6: spo = 32'h00130313;
            12'h6b7: spo = 32'h0062a023;
            12'h6b8: spo = 32'h00008067;
            12'h6b9: spo = 32'h000fe297;
            12'h6ba: spo = 32'h52428293;
            12'h6bb: spo = 32'h0082a303;
            12'h6bc: spo = 32'h556673b7;
            12'h6bd: spo = 32'h78838393;
            12'h6be: spo = 32'h00731e63;
            12'h6bf: spo = 32'h000fe297;
            12'h6c0: spo = 32'h50428293;
            12'h6c1: spo = 32'h0002a303;
            12'h6c2: spo = 32'h00130313;
            12'h6c3: spo = 32'h0062a023;
            12'h6c4: spo = 32'h00008067;
            12'h6c5: spo = 32'h000fe297;
            12'h6c6: spo = 32'h4f028293;
            12'h6c7: spo = 32'h0002a303;
            12'h6c8: spo = 32'h00130313;
            12'h6c9: spo = 32'h0062a023;
            12'h6ca: spo = 32'h00008067;
            12'h6cb: spo = 32'h000fe297;
            12'h6cc: spo = 32'h4dc28293;
            12'h6cd: spo = 32'h07f00313;
            12'h6ce: spo = 32'h00628623;
            12'h6cf: spo = 32'h00c28383;
            12'h6d0: spo = 32'h07f00e13;
            12'h6d1: spo = 32'h05c39c63;
            12'h6d2: spo = 32'h07f00313;
            12'h6d3: spo = 32'h006286a3;
            12'h6d4: spo = 32'h00d28383;
            12'h6d5: spo = 32'h07f00e13;
            12'h6d6: spo = 32'h05c39263;
            12'h6d7: spo = 32'h07f00313;
            12'h6d8: spo = 32'h00628723;
            12'h6d9: spo = 32'h00e28383;
            12'h6da: spo = 32'h07f00e13;
            12'h6db: spo = 32'h03c39863;
            12'h6dc: spo = 32'h07f00313;
            12'h6dd: spo = 32'h006287a3;
            12'h6de: spo = 32'h00f28383;
            12'h6df: spo = 32'h07f00e13;
            12'h6e0: spo = 32'h01c39e63;
            12'h6e1: spo = 32'h000fe297;
            12'h6e2: spo = 32'h47c28293;
            12'h6e3: spo = 32'h0002a303;
            12'h6e4: spo = 32'h00130313;
            12'h6e5: spo = 32'h0062a023;
            12'h6e6: spo = 32'h00008067;
            12'h6e7: spo = 32'h000fe297;
            12'h6e8: spo = 32'h46828293;
            12'h6e9: spo = 32'h0002a303;
            12'h6ea: spo = 32'h00130313;
            12'h6eb: spo = 32'h0062a023;
            12'h6ec: spo = 32'h00008067;
            12'h6ed: spo = 32'h000fe297;
            12'h6ee: spo = 32'h45428293;
            12'h6ef: spo = 32'h00008337;
            12'h6f0: spo = 32'h00130313;
            12'h6f1: spo = 32'h00629823;
            12'h6f2: spo = 32'h01029383;
            12'h6f3: spo = 32'hffff8e37;
            12'h6f4: spo = 32'h001e0e13;
            12'h6f5: spo = 32'h03c39a63;
            12'h6f6: spo = 32'h10100313;
            12'h6f7: spo = 32'h00629923;
            12'h6f8: spo = 32'h0102a383;
            12'h6f9: spo = 32'h01018e37;
            12'h6fa: spo = 32'h001e0e13;
            12'h6fb: spo = 32'h01c39e63;
            12'h6fc: spo = 32'h000fe297;
            12'h6fd: spo = 32'h41028293;
            12'h6fe: spo = 32'h0002a303;
            12'h6ff: spo = 32'h00130313;
            12'h700: spo = 32'h0062a023;
            12'h701: spo = 32'h00008067;
            12'h702: spo = 32'h000fe297;
            12'h703: spo = 32'h3fc28293;
            12'h704: spo = 32'h0002a303;
            12'h705: spo = 32'h00130313;
            12'h706: spo = 32'h0062a023;
            12'h707: spo = 32'h00008067;
            12'h708: spo = 32'h000fe297;
            12'h709: spo = 32'h3e828293;
            12'h70a: spo = 32'h0142c303;
            12'h70b: spo = 32'h0ff00393;
            12'h70c: spo = 32'h02731463;
            12'h70d: spo = 32'h0152c303;
            12'h70e: spo = 32'h00000393;
            12'h70f: spo = 32'h00731e63;
            12'h710: spo = 32'h000fe297;
            12'h711: spo = 32'h3c028293;
            12'h712: spo = 32'h0002a303;
            12'h713: spo = 32'h00130313;
            12'h714: spo = 32'h0062a023;
            12'h715: spo = 32'h00008067;
            12'h716: spo = 32'h000fe297;
            12'h717: spo = 32'h3ac28293;
            12'h718: spo = 32'h0002a303;
            12'h719: spo = 32'h00130313;
            12'h71a: spo = 32'h0062a023;
            12'h71b: spo = 32'h00008067;
            12'h71c: spo = 32'h000fe297;
            12'h71d: spo = 32'h39828293;
            12'h71e: spo = 32'h0142d303;
            12'h71f: spo = 32'h0ff00393;
            12'h720: spo = 32'h02731663;
            12'h721: spo = 32'h0162d303;
            12'h722: spo = 32'h000103b7;
            12'h723: spo = 32'hf0038393;
            12'h724: spo = 32'h00731e63;
            12'h725: spo = 32'h000fe297;
            12'h726: spo = 32'h36c28293;
            12'h727: spo = 32'h0002a303;
            12'h728: spo = 32'h00130313;
            12'h729: spo = 32'h0062a023;
            12'h72a: spo = 32'h00008067;
            12'h72b: spo = 32'h000fe297;
            12'h72c: spo = 32'h35828293;
            12'h72d: spo = 32'h0002a303;
            12'h72e: spo = 32'h00130313;
            12'h72f: spo = 32'h0062a023;
            12'h730: spo = 32'h00008067;
            12'h731: spo = 32'h00500293;
            12'h732: spo = 32'h00500313;
            12'h733: spo = 32'h00628463;
            12'h734: spo = 32'h0280006f;
            12'h735: spo = 32'h00100293;
            12'h736: spo = 32'h00200313;
            12'h737: spo = 32'h00628e63;
            12'h738: spo = 32'h000fe297;
            12'h739: spo = 32'h32028293;
            12'h73a: spo = 32'h0002a303;
            12'h73b: spo = 32'h00130313;
            12'h73c: spo = 32'h0062a023;
            12'h73d: spo = 32'h00008067;
            12'h73e: spo = 32'h000fe297;
            12'h73f: spo = 32'h30c28293;
            12'h740: spo = 32'h0002a303;
            12'h741: spo = 32'h00130313;
            12'h742: spo = 32'h0062a023;
            12'h743: spo = 32'h00008067;
            12'h744: spo = 32'h00100293;
            12'h745: spo = 32'h00200313;
            12'h746: spo = 32'h00629463;
            12'h747: spo = 32'h0280006f;
            12'h748: spo = 32'h00500293;
            12'h749: spo = 32'h00500313;
            12'h74a: spo = 32'h00629e63;
            12'h74b: spo = 32'h000fe297;
            12'h74c: spo = 32'h2d428293;
            12'h74d: spo = 32'h0002a303;
            12'h74e: spo = 32'h00130313;
            12'h74f: spo = 32'h0062a023;
            12'h750: spo = 32'h00008067;
            12'h751: spo = 32'h000fe297;
            12'h752: spo = 32'h2c028293;
            12'h753: spo = 32'h0002a303;
            12'h754: spo = 32'h00130313;
            12'h755: spo = 32'h0062a023;
            12'h756: spo = 32'h00008067;
            12'h757: spo = 32'hfff00293;
            12'h758: spo = 32'h00000313;
            12'h759: spo = 32'h0062c463;
            12'h75a: spo = 32'h0280006f;
            12'h75b: spo = 32'h00500293;
            12'h75c: spo = 32'h00500313;
            12'h75d: spo = 32'h0062ce63;
            12'h75e: spo = 32'h000fe297;
            12'h75f: spo = 32'h28828293;
            12'h760: spo = 32'h0002a303;
            12'h761: spo = 32'h00130313;
            12'h762: spo = 32'h0062a023;
            12'h763: spo = 32'h00008067;
            12'h764: spo = 32'h000fe297;
            12'h765: spo = 32'h27428293;
            12'h766: spo = 32'h0002a303;
            12'h767: spo = 32'h00130313;
            12'h768: spo = 32'h0062a023;
            12'h769: spo = 32'h00008067;
            12'h76a: spo = 32'h00100293;
            12'h76b: spo = 32'hfff00313;
            12'h76c: spo = 32'h0062d463;
            12'h76d: spo = 32'h0280006f;
            12'h76e: spo = 32'h00100293;
            12'h76f: spo = 32'h00500313;
            12'h770: spo = 32'h0062de63;
            12'h771: spo = 32'h000fe297;
            12'h772: spo = 32'h23c28293;
            12'h773: spo = 32'h0002a303;
            12'h774: spo = 32'h00130313;
            12'h775: spo = 32'h0062a023;
            12'h776: spo = 32'h00008067;
            12'h777: spo = 32'h000fe297;
            12'h778: spo = 32'h22828293;
            12'h779: spo = 32'h0002a303;
            12'h77a: spo = 32'h00130313;
            12'h77b: spo = 32'h0062a023;
            12'h77c: spo = 32'h00008067;
            12'h77d: spo = 32'hfff00293;
            12'h77e: spo = 32'h00500313;
            12'h77f: spo = 32'h00536463;
            12'h780: spo = 32'h0280006f;
            12'h781: spo = 32'h00500293;
            12'h782: spo = 32'h00500313;
            12'h783: spo = 32'h0062ee63;
            12'h784: spo = 32'h000fe297;
            12'h785: spo = 32'h1f028293;
            12'h786: spo = 32'h0002a303;
            12'h787: spo = 32'h00130313;
            12'h788: spo = 32'h0062a023;
            12'h789: spo = 32'h00008067;
            12'h78a: spo = 32'h000fe297;
            12'h78b: spo = 32'h1dc28293;
            12'h78c: spo = 32'h0002a303;
            12'h78d: spo = 32'h00130313;
            12'h78e: spo = 32'h0062a023;
            12'h78f: spo = 32'h00008067;
            12'h790: spo = 32'h00500293;
            12'h791: spo = 32'hfff00313;
            12'h792: spo = 32'h00537c63;
            12'h793: spo = 32'h02c0006f;
            12'h794: spo = 32'h00500293;
            12'h795: spo = 32'h00500313;
            12'h796: spo = 32'h0062f463;
            12'h797: spo = 32'h01c0006f;
            12'h798: spo = 32'h000fe297;
            12'h799: spo = 32'h1a028293;
            12'h79a: spo = 32'h0002a303;
            12'h79b: spo = 32'h00130313;
            12'h79c: spo = 32'h0062a023;
            12'h79d: spo = 32'h00008067;
            12'h79e: spo = 32'h000fe297;
            12'h79f: spo = 32'h18c28293;
            12'h7a0: spo = 32'h0002a303;
            12'h7a1: spo = 32'h00130313;
            12'h7a2: spo = 32'h0062a023;
            12'h7a3: spo = 32'h00008067;
            12'h7a4: spo = 32'h00008413;
            12'h7a5: spo = 32'h00000297;
            12'h7a6: spo = 32'h02028293;
            12'h7a7: spo = 32'h000280e7;
            12'h7a8: spo = 32'h00000e17;
            12'h7a9: spo = 32'h00800313;
            12'h7aa: spo = 32'h00639a63;
            12'h7ab: spo = 32'h01c09863;
            12'h7ac: spo = 32'h0280006f;
            12'h7ad: spo = 32'h00800393;
            12'h7ae: spo = 32'h00008067;
            12'h7af: spo = 32'h000fe297;
            12'h7b0: spo = 32'h14828293;
            12'h7b1: spo = 32'h0002a303;
            12'h7b2: spo = 32'h00130313;
            12'h7b3: spo = 32'h0062a023;
            12'h7b4: spo = 32'h00040093;
            12'h7b5: spo = 32'h00008067;
            12'h7b6: spo = 32'h000fe297;
            12'h7b7: spo = 32'h12828293;
            12'h7b8: spo = 32'h0002a303;
            12'h7b9: spo = 32'h00130313;
            12'h7ba: spo = 32'h0062a023;
            12'h7bb: spo = 32'h00040093;
            12'h7bc: spo = 32'h00008067;
            12'h7bd: spo = 32'h06054063;
            12'h7be: spo = 32'h0605c663;
            12'h7bf: spo = 32'h00058613;
            12'h7c0: spo = 32'h00050593;
            12'h7c1: spo = 32'hfff00513;
            12'h7c2: spo = 32'h02060c63;
            12'h7c3: spo = 32'h00100693;
            12'h7c4: spo = 32'h00b67a63;
            12'h7c5: spo = 32'h00c05863;
            12'h7c6: spo = 32'h00161613;
            12'h7c7: spo = 32'h00169693;
            12'h7c8: spo = 32'hfeb66ae3;
            12'h7c9: spo = 32'h00000513;
            12'h7ca: spo = 32'h00c5e663;
            12'h7cb: spo = 32'h40c585b3;
            12'h7cc: spo = 32'h00d56533;
            12'h7cd: spo = 32'h0016d693;
            12'h7ce: spo = 32'h00165613;
            12'h7cf: spo = 32'hfe0696e3;
            12'h7d0: spo = 32'h00008067;
            12'h7d1: spo = 32'h00008293;
            12'h7d2: spo = 32'hfb5ff0ef;
            12'h7d3: spo = 32'h00058513;
            12'h7d4: spo = 32'h00028067;
            12'h7d5: spo = 32'h40a00533;
            12'h7d6: spo = 32'h00b04863;
            12'h7d7: spo = 32'h40b005b3;
            12'h7d8: spo = 32'hf9dff06f;
            12'h7d9: spo = 32'h40b005b3;
            12'h7da: spo = 32'h00008293;
            12'h7db: spo = 32'hf91ff0ef;
            12'h7dc: spo = 32'h40a00533;
            12'h7dd: spo = 32'h00028067;
            12'h7de: spo = 32'h00008293;
            12'h7df: spo = 32'h0005ca63;
            12'h7e0: spo = 32'h00054c63;
            12'h7e1: spo = 32'hf79ff0ef;
            12'h7e2: spo = 32'h00058513;
            12'h7e3: spo = 32'h00028067;
            12'h7e4: spo = 32'h40b005b3;
            12'h7e5: spo = 32'hfe0558e3;
            12'h7e6: spo = 32'h40a00533;
            12'h7e7: spo = 32'hf61ff0ef;
            12'h7e8: spo = 32'h40b00533;
            12'h7e9: spo = 32'h00028067;
            12'h7ea: spo = 32'h00050613;
            12'h7eb: spo = 32'h00000513;
            12'h7ec: spo = 32'h0015f693;
            12'h7ed: spo = 32'h00068463;
            12'h7ee: spo = 32'h00c50533;
            12'h7ef: spo = 32'h0015d593;
            12'h7f0: spo = 32'h00161613;
            12'h7f1: spo = 32'hfe0596e3;
            12'h7f2: spo = 32'h00008067;
            default: spo = 32'h0000_0013;
        endcase
    end
endmodule
