ZhangXin555/kosmo-riscv/(commit log)

2026-11-09 RV32I 5-stage pipelined CPU: RTL, constraints, simulation, docs
2026-11-09 docs: add 94-page textbook (RISC-V 5-stage pipelined CPU, full source + Vivado screenshots)
